newdigate/nosh-dev-board/fab/README.md

# Nosh fabrication outputs

Generated by `python3 Kicad/tools/fab_export.py` on 2026-11-03 from Kicad/Nosh.kicad_pcb (commit b732f8e).

| File | Contents |
|---|---|
| `Nosh-gerbers.zip` | 16 Gerber/drill files: 6 copper layers, paste, silk, mask, edge cuts, one Excellon drill file (PTH + NPTH, slots as routed ovals) and its map |
| `Nosh-bom.csv` | 70 order codes covering 268 fitted parts |
| `Nosh-cpl.csv` | 268 placements, 198 top / 70 bottom; through-hole parts included: J11, J4 |

## JLCPCB order settings

- 6 layers, 1.6 mm, FR4 TG155 (chosen over TG135 for the two lead-free reflow passes and hand rework), 1 oz outer / 0.5 oz inner copper (0.5 oz inner keeps the 0.09 mm inner spacing allowed), any colour.
- Order options worth the free day each: Confirm Production File = Yes, Confirm Parts Placement = Yes (rotation preview); Depanel boards & edge rail = Yes (JLCPCB rails go on the long edges; J5 pads sit 0.3 mm from the north V-score).
- Surface finish: ENIG, 1U" gold (0.025 um, the IPC-4552 minimum and JLCPCB's standard). The gold is sacrificial and dissolves into the joint, so 2U" adds nothing to wetting and only moves the small 0402 / 0.4 mm QFN joints toward Au embrittlement; thicker gold is for wiping contacts, which this board has none of. OSP is also offered on 6 layers but was rejected: two reflow passes (70 bottom-side parts), hand soldering of J4/J11, test points and rework all want a finish that survives handling.
- Stackup: Specify Stackup = Yes, JLC06161H-3313 (3313 prepreg, 0.0994 mm outer dielectric, 0.5 oz inner, finished 1.54 mm +-10%). JLCPCB impedance calculator, 2026-11-03, L1 over L2: the USB pairs (0.13 mm / 0.11 mm gap) come out ~85 R (USB 2.0 wants 90 +-15%) and the MIPI pairs (0.13 / 0.13) ~90 R (D-PHY 80-125 R), so no impedance-control order is needed. The 7628 and 2116 stackups put 0.21-0.22 mm under the outer layers (our pairs would read ~115-120 R) and 1080 only 0.076 mm (~75 R); do not pick those.
- Via covering: "Epoxy Filled & Capped" (the 6-layer default) - the board has via-in-pad under the decoupling capacitors.
- Min track / spacing: the 0.09 / 0.09 mm tier (board minimum 0.13 mm track, 0.09 mm spacing).
- Min via hole size / diameter: choose "0.2 mm / (0.3/0.35 mm)". The board has 323 vias at 0.2 mm drill in a 0.45 mm pad (0.125 mm ring), 809 at 0.3 mm drill in 0.45 mm (0.075 mm ring) and 63 at 0.3 mm in 0.5 mm; the 0.2 mm drills carry JLCPCB's small-via surcharge. Smallest component hole 0.6 mm.
- Assembly: both sides, standard parts; order the stencil for both sides; add BGA X-ray inspection.
- Consigned / pre-ordered parts: U1 MIMXRT1176DVMAA (C1020237, reserved in the parts library) and U9/U10 AS4C32M16SC-7TIN (C1349997, four ordered 2026-11-03 after the -6TIN C1351095 stayed out of stock).
- Through-hole: J4 barrel jack and J11 UART header are the only THT parts; run with `--no-tht` to leave them off the BOM/CPL and hand-solder them.
- Rotation: the CPL carries KiCad rotations. Check every polarised part (SOT-23 family, QFN, WSON, TSSOP, TSOP, SOT-223, SOD/SMA diodes, BGA) in the JLCPCB placement preview before paying.

## Order placed 2026-11-03

JLCPCB order Y95-2611336A, $477.79 incl. $30.57 shipping: 5 PCBs ($132.93) + 2 assembled both sides ($311.91). Dimension 153.9 x 91.8 mm = board + 5 mm rails on the long edges, FR4 TG155, JLC06161H-3313, ENIG 1U", 1 oz / 0.5 oz, epoxy filled & capped, 0.2 mm / (0.3/0.35 mm) vias, black, flying probe + 4-wire Kelvin, mark removed, no impedance control, Confirm Production File = No, build 7-8 + 4-5 days. Ordered without the placement-confirmation and depanel options: snap the rails off by hand (J5 pads are 0.3 mm from the north V-score).
