newdigate/nosh-dev-board/Kicad/handroute/bga_handroute.md

# Open connections to hand-route

Generated by `tools/handroute_list.py` on 2026-10-27 from a KiCad DRC of the board with its zones refilled: **0 open connections** in total, 0 with one end at the U1 ball grid (0 power, 0 signal) and 0 elsewhere on the board.

Numbers 1–0 match the labels in `bga_open.png` (label = the ball end; yellow = signal, cyan = power; the short bar points toward the other end). Every number is also in `board_open.png`, labelled at the middle of its airline.
Balls are 0.8 mm pitch, A1 at (65.6, 35.6), rows A–U top to bottom, columns 1–17 left to right. Coordinates are mm from the board origin (top-left, y down).

- **Fan-out via** is the dog-bone via already on that ball: start there. "none" means the ball has no fan-out yet (the outer two rings escape on F.Cu).
- **Other end** is where KiCad's ratsnest line lands (a pad, or the end of copper already routed on that net) and the pads it is part of.
- Inside the grid only 0.13 mm tracks (the board minimum) fit between the fan-out vias; no tracks on GND1, PWR or GND2.

⚡ = power net (route wider than 0.13 mm once outside the grid where there is room).
