newdigate/nosh-dev-board/Kicad/handroute/bga_open.png

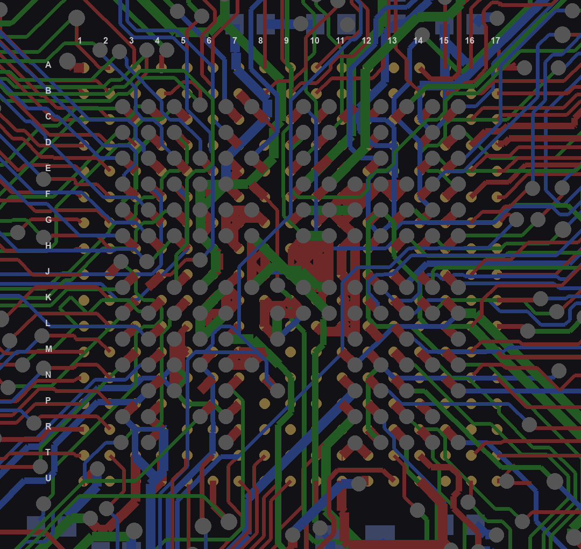
Kicad/handroute/bga_open.png
