newdigate/nosh-dev-board/Kicad/handroute/board_open.png

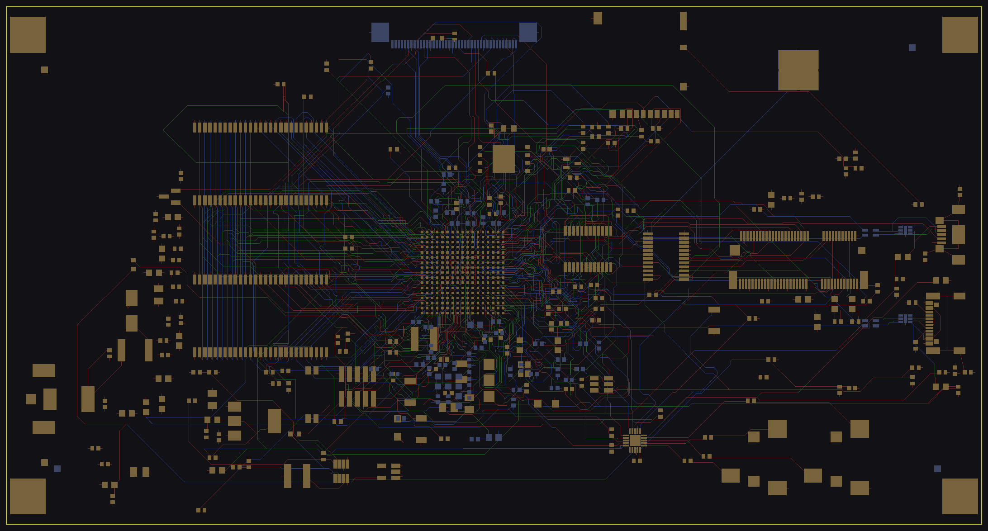
Kicad/handroute/board_open.png
