newdigate/nosh-dev-board/fab/Nosh-bom.csv

Comment | Designator | Footprint | LCSC Part # | MPN
1uF | C1,C11,C117,C132,C133,C141,C142,C19,C20,C47,C48,C49,C50,C51,C52,C58,C78,C8 | C_0402_1005Metric_JLC / C_0402_1005Metric_ViP | C52923 | CL05A105KA5NQNC
2.2uF | C118,C13,C14,C2,C28,C32,C34,C35,C36,C38,C39,C40,C42,C44,C7 | C_0402_1005Metric_JLC / C_0402_1005Metric_ViP | C12530 | CL05A225MQ5NSNC
100nF | C105,C106,C107,C108,C109,C111,C112,C113,C114,C119,C12,C127,C129,C130,C131,C146,C148,C21,C22,C25,C29,C3,C33,C46,C55,C56,C57,C59,C63,C69,C70,C74,C77,C80,C82,C84,C85,C86,C87,C88,C89,C9,C90,C91,C93,C94,C95,C96,C97,C98,C99 | C_0402_1005Metric_JLC / C_0402_1005Metric_ViP | C1525 | CL05B104KO5NNNC
220nF | C116,C4,C45,C71 | C_0402_1005Metric_JLC | C16772 | CL05B224KO5NNNC
4.7uF | C10,C128,C16,C17,C18,C24,C37,C41,C43,C5,C6,C64,C65,C66 | C_0402_1005Metric_JLC / C_0402_1005Metric_ViP | C23733 | CL05A475MP5NRNC
22uF | C15,C23,C26,C30 | C_0603_1608Metric | C59461 | CL10A226MQ8NRNC
10uF | C103,C104,C27,C31,C60,C62,C73,C75,C76,C81,C83 | C_0603_1608Metric | C19702 | CL10A106KP8NNNC
4.7pF | C53,C54 | C_0402_1005Metric_JLC | C325453 | CC0402BRNPO9BN4R7
10pF | C143,C144 | C_0402_1005Metric_JLC | C32949 | CL05C100JB5NNNC
3.3nF | C147 | C_0603_1608Metric | C1613 | CL10B332KB8NNNC
MIPI LCD FPC (RK055HDMIPI4MA0) | J7 | FPC40_0p5_Wuerth_68714014022 | C6264899 | 68714014022
DLW21HN900SQ2L | L3,L4 | L_CommonModeChoke_Murata_DLW21 | C80529 | DLW21HN900SQ2L
30k | R1 | R_0402_1005Metric_JLC | C2909347 | FRC0402F3002TS
100k | R100,R101,R102,R103,R105,R19,R24,R55,R90,R91,R92,R93,R94,R95,R96,R97,R98,R99 | R_0402_1005Metric_JLC | C25741 | 0402WGF1003TCE
47k | R106 | R_0402_1005Metric_JLC | C25792 | 0402WGF4702TCE
560R | R107 | R_0402_1005Metric_JLC | C25126 | 0402WGF5600TCE
RClamp0854P | U4,U5 | slp1616p6 | C842842 | RCLAMP0854P.TCT
TPS259531 | U17 | Texas_DSG0008A_WSON-8-1EP_2x2mm_P0.5mm_EP0.9x1.6mm | C2155674 | TPS259531DSGR
1.5nF | C61,C67 | C_0402_1005Metric_JLC | C107022 | CC0402KRX7R9BB152
22uF | C101,C68,C72 | C_0805_2012Metric | C45783 | CL21A226MAQNNNE
4.7uF | C100,C102,C79,C92 | C_0603_1608Metric | C19666 | CL10A475KO8NNNC
RB521S30 | D1,D5,D9 | D_SOD-523 | C145179 | RB521S30T1G
MBR120VLSFT1G | D3,D4 | D_SOD-123F | C223608 | MBR120VLSFT1G
RED | D10,D11,D6,D7 | LED_0603_1608Metric | C2286 | KT-0603R
SMAJ6.0A | D12 | D_SMA | C223993 | SMAJ6.0A
TPD1E05U06 | D13,D14,D15,D16,D17,D18 | ESD_X1SON-2_0.6x1mm_JLC | C436349 | TPD1E05U06DPYR
TPD1E10B06 | D19,D20,D21,D22 | ESD_X1SON-2_0.6x1mm_JLC | C48260 | TPD1E10B06DPYR
3A | F1 | Fuse_1812_4532Metric | C2892380 | SMD1812P300SLR/24
120R | FB1,FB11,FB2,FB3,FB4,FB5,FB6 | L_0402_1005Metric | C85812 | BLM15AG121SN1D
120R | FB10,FB7 | L_0603_1608Metric | C14709 | BLM18PG121SN1D
300R | FB8 | L_0603_1608Metric | C2649308 | 742792641
M2.5 nut 2mm | H5 | SMTSO_M2.5_Hole4.22mm_Pad6.2mm | C5301776 | SMTSOM2.520BTR
SWD | J1 | PinHeader_2x05_P1.27mm_Vertical_SMD | C150517 | 20021121-00010C4LF
USB2 micro-AB | J2 | USB_Micro-AB_Molex_47590-0001_JLC | C136001 | 47590-0001
USB1 USB-C | J3 | USB_C_Receptacle_GCT_USB4105-xx-A_16P_TopMnt_Horizontal_JLC | C5184243 | USB4105-GF-A-120
DC 5V IN | J4 | BarrelJack_CUI_PJ-063AH_Horizontal_JLC | C22434582 | PJ-063AH
microSD | J5 | microSD_HC_Hirose_DM3AT-SF-PEJM5_JLC | C114218 | DM3AT-SF-PEJM5
M.2 Key E (IW416 / MAYA-W1) | J6 | M2_KeyE_67pin_RA | C2977809 | 2199230-4
LINE IN / LINE OUT | J8,J9 | Jack_3.5mm_CUI_SJ-3524-SMT_Horizontal_JLC | C20182907 | SJ-3524-SMT-TR
DEBUG UART | J11 | PinHeader_1x03_P2.54mm_Vertical | C2937625 | PZ254V-11-03P
4.7uH | L1 | L_APV_ANR4020 | C6364800 | ANR4020T4R7M
1uH 3A | L5 | L_APV_ANR4020 | C91254 | SWPA4020S1R0NT
2SK3018 | Q2 | SOT-323_SC-70 | C113315 | 2SK3018T106
IRLML6401 | Q3,Q4 | SOT-23 | C3034 | IRLML6401TRPBF
4.7k | R11,R12,R2 | R_0402_1005Metric_JLC | C25900 | 0402WGF4701TCE
0R | R41,R42,R56,R7,R8,R81,R82,R83 | R_0402_1005Metric_JLC | C17168 | 0402WGF0000TCE
10k | R10,R108,R109,R13,R14,R18,R28,R43,R44,R46,R49,R53,R54,R57,R59,R66,R73 | R_0402_1005Metric_JLC | C25744 | 0402WGF1002TCE
100R | R16,R27 | R_0402_1005Metric_JLC | C25076 | 0402WGF1000TCE
22k | R23 | R_0402_1005Metric_JLC | C25768 | 0402WGF2202TCE
5.1k | R25,R26 | R_0402_1005Metric_JLC | C25905 | 0402WGF5101TCE
180k | R29 | R_0402_1005Metric_JLC | C25760 | 0402WGF1803TCE
40.2k | R30 | R_0402_1005Metric_JLC | C25893 | 0402WGF4022TCE
0R | R40 | R_0603_1608Metric | C21189 | 0603WAF0000T5E
27R | R47,R50 | R_0402_1005Metric_JLC | C25100 | 0402WGF270JTCE
1k | R104,R51,R52,R58,R60,R89 | R_0402_1005Metric_JLC | C11702 | 0402WGF1001TCE
2.2k | R74,R75 | R_0402_1005Metric_JLC | C25879 | 0402WGF2201TCE
ONOFF / RESET / WAKEUP | SW1,SW2,SW3 | SW_SPST_B3U-1000P | C231329 | B3U-1000P
BOOT_MODE | SW4 | SW_DIP_SPSTx02_Slide_KingTek_DSHP02TS_W7.62mm_P1.27mm | C3293142 | DSHP02TSGER
MIMXRT1176DVMAA | U1 | MAPBGA-289_14x14mm_Layout17x17_P0.8mm | C1020237 | MIMXRT1176DVMAA
W25Q512JVEIQ | U2 | WSON-8-1EP_8x6mm_P1.27mm_EP3.4x4.3mm | C7389628 | W25Q512JVEIQ
TPS2553DBVR | U3 | SOT-23-6 | C55266 | TPS2553DBVR
MP2143DJ | U6 | TSOT-23-8 | C43427 | MP2143DJ-LF-Z
AP2112K-3.3 | U7 | SOT-23-5 | C51118 | AP2112K-3.3TRG1
TLV1117LV-18 | U8 | SOT-223-3_TabPin2 | C80105 | TLV1117LV18DCYR
AS4C32M16SC-7TIN | U10,U9 | TSOP-II-54_22.2x10.16mm_P0.8mm | C1349997 | AS4C32M16SC-7TIN
74AVC8T245PW | U11,U12 | TSSOP-24_4.4x7.8mm_P0.65mm | C465742 | SN74AVC8T245PWR
SGTL5000XNLA3R2 | U15 | QFN-20-1EP_3x3mm_P0.4mm_EP1.65x1.65mm | C2651833 | SGTL5000XNLA3R2
TLV803S | U16 | SOT-23 | C132016 | TLV803SDBZR
24MHz | Y1 | Crystal_SMD_2016-4Pin_2.0x1.6mm | C5250251 | XRCGB24M000F2P91R0
32.768kHz | Y2 | Crystal_SMD_3215-2Pin_3.2x1.5mm_JLC | C48615 | Q13FC13500002
