newdigate/nosh-dev-board/Kicad/Nosh.kicad_pcb

## KiCad design Kicad/Nosh.kicad_pcb (2026-11-03)

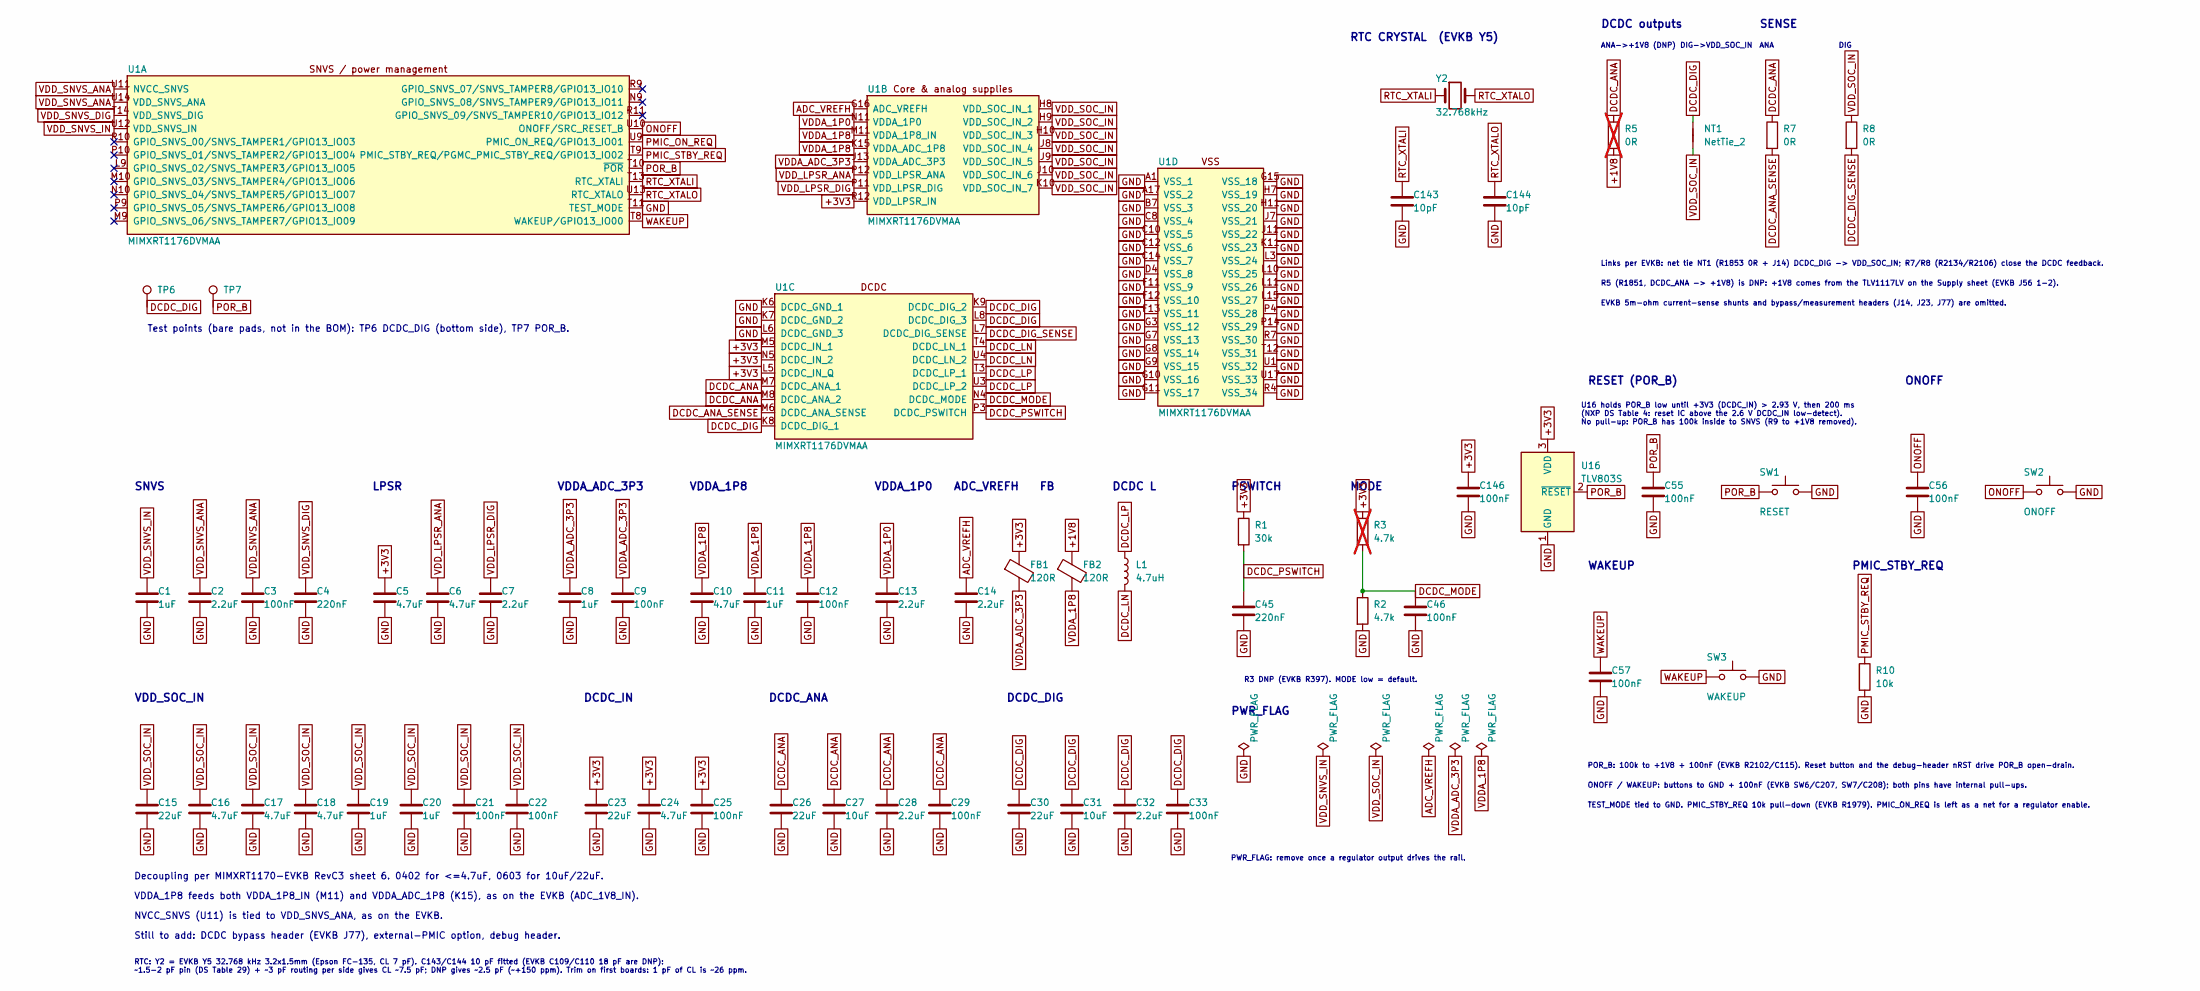
[picture p5: schematic power.kicad_sch]

Parts:
C1, C8: 1uF; C_0402_1005Metric_JLC; MPN CL05A105KA5NQNC; LCSC C52923
C2, C13, C14: 2.2uF; C_0402_1005Metric_JLC; MPN CL05A225MQ5NSNC; LCSC C12530
C3, C12, C21, C25, C33: 100nF; C_0402_1005Metric_ViP; MPN CL05B104KO5NNNC; LCSC C1525
C4, C45: 220nF; C_0402_1005Metric_JLC; MPN CL05B224KO5NNNC; LCSC C16772
C5, C16, C17, C24: 4.7uF; C_0402_1005Metric_ViP; MPN CL05A475MP5NRNC; LCSC C23733
C6, C10, C18: 4.7uF; C_0402_1005Metric_JLC; MPN CL05A475MP5NRNC; LCSC C23733
C7, C28, C32: 2.2uF; C_0402_1005Metric_ViP; MPN CL05A225MQ5NSNC; LCSC C12530
C9, C22, C29, C46, C55, C56, C57, C146: 100nF; C_0402_1005Metric_JLC; MPN CL05B104KO5NNNC; LCSC C1525
C11, C19, C20: 1uF; C_0402_1005Metric_ViP; MPN CL05A105KA5NQNC; LCSC C52923
C15, C23, C26, C30: 22uF; C_0603_1608Metric; MPN CL10A226MQ8NRNC; LCSC C59461
C27, C31: 10uF; C_0603_1608Metric; MPN CL10A106KP8NNNC; LCSC C19702
C143, C144: 10pF; C_0402_1005Metric_JLC; MPN CL05C100JB5NNNC; LCSC C32949
FB1, FB2: 120R; L_0402_1005Metric; MPN BLM15AG121SN1D; LCSC C85812
L1: 4.7uH; L_APV_ANR4020; MPN ANR4020T4R7M; LCSC C6364800
NT1: NetTie_2; NetTie-2_SMD_0805
R1: 30k; R_0402_1005Metric_JLC; MPN FRC0402F3002TS; LCSC C2909347
R2: 4.7k; R_0402_1005Metric_JLC; MPN 0402WGF4701TCE; LCSC C25900
R3: 4.7k; R_0402_1005Metric_JLC; MPN 0402WGF4701TCE; LCSC C25900; not fitted
R5: 0R; R_0805_2012Metric; MPN 0805W8F0000T5E; LCSC C17477; not fitted
R7, R8: 0R; R_0402_1005Metric_JLC; MPN 0402WGF0000TCE; LCSC C17168
R10: 10k; R_0402_1005Metric_JLC; MPN 0402WGF1002TCE; LCSC C25744
SW1: RESET; SW_SPST_B3U-1000P; MPN B3U-1000P; LCSC C231329
SW2: ONOFF; SW_SPST_B3U-1000P; MPN B3U-1000P; LCSC C231329
SW3: WAKEUP; SW_SPST_B3U-1000P; MPN B3U-1000P; LCSC C231329
TP6, TP7: TestPoint; TestPoint_Pad_D1.0mm_JLC
U1: MIMXRT1176DVMAA; MAPBGA-289_14x14mm_Layout17x17_P0.8mm; MPN MIMXRT1176DVMAA; LCSC C1020237
U16: TLV803S; SOT-23; MPN TLV803SDBZR; LCSC C132016
Y2: 32.768kHz; Crystal_SMD_3215-2Pin_3.2x1.5mm_JLC; MPN Q13FC13500002; LCSC C48615

Connections:
+1V8: FB2.1, R5.2; also elsewhere on the board
+3V3: C5.1, C23.1, C24.1, C25.1, C146.1, FB1.1, R1.1, R3.1, U1.L5 (DCDC_IN_Q), U1.M5 (DCDC_IN_1), U1.N5 (DCDC_IN_2), U1.R12 (VDD_LPSR_IN), U16.3 (VDD); also elsewhere on the board
ADC_VREFH: C14.1, U1.G16 (ADC_VREFH); also elsewhere on the board
DCDC_ANA: C26.1, C27.1, C28.1, C29.1, R5.1, R7.1, U1.M7 (DCDC_ANA_1), U1.M8 (DCDC_ANA_2)
DCDC_ANA_SENSE: R7.2, U1.M6 (DCDC_ANA_SENSE)
DCDC_DIG: C30.1, C31.1, C32.1, C33.1, NT1.1, TP6.1, U1.K8 (DCDC_DIG_1), U1.K9 (DCDC_DIG_2), U1.L8 (DCDC_DIG_3)
DCDC_DIG_SENSE: R8.2, U1.L7 (DCDC_DIG_SENSE)
DCDC_LN: L1.2, U1.T4 (DCDC_LN_1), U1.U4 (DCDC_LN_2)
DCDC_LP: L1.1, U1.T3 (DCDC_LP_1), U1.U3 (DCDC_LP_2)
DCDC_MODE: C46.1, R2.1, R3.2, U1.N4 (DCDC_MODE)
DCDC_PSWITCH: C45.1, R1.2, U1.P3 (DCDC_PSWITCH)
GND: C1.2, C2.2, C3.2, C4.2, C5.2, C6.2, C7.2, C8.2, C9.2, C10.2, C11.2, C12.2, C13.2, C14.2, C15.2, C16.2, C17.2, C18.2, C19.2, C20.2, C21.2, C22.2, C23.2, C24.2, C25.2, C26.2, C27.2, C28.2, C29.2, C30.2, C31.2, C32.2, C33.2, C45.2, C46.2, C55.2, C56.2, C57.2, C143.2, C144.2, C146.2, R2.2, R10.2, SW1.2, SW2.2, SW3.2, U1.A1 (VSS_1), U1.A17 (VSS_2), U1.B7 (VSS_3), U1.C8 (VSS_4), U1.C10 (VSS_5), U1.C12 (VSS_6), U1.C14 (VSS_7), U1.D4 (VSS_8), U1.F11 (VSS_9), U1.F12 (VSS_10), U1.F13 (VSS_11), U1.G3 (VSS_12), U1.G7 (VSS_13), U1.G8 (VSS_14), U1.G9 (VSS_15), U1.G10 (VSS_16), U1.G11 (VSS_17), U1.G15 (VSS_18), U1.H7 (VSS_19), U1.H11 (VSS_20), U1.J7 (VSS_21), U1.J11 (VSS_22), U1.K6 (DCDC_GND_1), U1.K7 (DCDC_GND_2), U1.K11 (VSS_23), U1.L3 (VSS_24), U1.L6 (DCDC_GND_3), U1.L10 (VSS_25), U1.L11 (VSS_26), U1.L15 (VSS_27), U1.P4 (VSS_28), U1.P14 (VSS_29), U1.R4 (VSS_34), U1.R7 (VSS_30), U1.T11 (TEST_MODE), U1.T12 (VSS_31), U1.U1 (VSS_32), U1.U17 (VSS_33), U16.1 (GND); also elsewhere on the board
ONOFF: C56.1, SW2.1, U1.U10 (ONOFF/SRC_RESET_B)
PMIC_ON_REQ: U1.U9 (PMIC_ON_REQ/GPIO13_IO01); also elsewhere on the board
PMIC_STBY_REQ: R10.1, U1.T9 (PMIC_STBY_REQ/PGMC_PMIC_STBY_REQ/GPIO13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)
POR_B: C55.1, SW1.1, TP7.1, U1.T10 (~POR), U16.2 (~RESET); also elsewhere on the board
RTC_XTALI: C143.1, U1.T13 (RTC_XTALI), Y2.1
RTC_XTALO: C144.1, U1.U13 (RTC_XTALO), Y2.2
VDDA_1P0: C13.1, U1.N11 (VDDA_1P0); also elsewhere on the board
VDDA_1P8: C10.1, C11.1, C12.1, FB2.2, U1.K15 (VDDA_ADC_1P8), U1.M11 (VDDA_1P8_IN)
VDDA_ADC_3P3: C8.1, C9.1, FB1.2, U1.J13 (VDDA_ADC_3P3)
VDD_LPSR_ANA: C6.1, U1.P12 (VDD_LPSR_ANA)
VDD_LPSR_DIG: C7.1, U1.P11 (VDD_LPSR_DIG)
VDD_SNVS_ANA: C2.1, C3.1, U1.U11 (NVCC_SNVS), U1.U14 (VDD_SNVS_ANA)
VDD_SNVS_DIG: C4.1, U1.T14 (VDD_SNVS_DIG)
VDD_SNVS_IN: C1.1, U1.U12 (VDD_SNVS_IN); also elsewhere on the board
VDD_SOC_IN: C15.1, C16.1, C17.1, C18.1, C19.1, C20.1, C21.1, C22.1, NT1.2, R8.1, U1.H8 (VDD_SOC_IN_1), U1.H9 (VDD_SOC_IN_2), U1.H10 (VDD_SOC_IN_3), U1.J8 (VDD_SOC_IN_4), U1.J9 (VDD_SOC_IN_5), U1.J10 (VDD_SOC_IN_6), U1.K10 (VDD_SOC_IN_7)
WAKEUP: C57.1, SW3.1, U1.T8 (WAKEUP/GPIO13_IO00)

Notes on the sheet:
DIG
SNVS
R5 (R1851, DCDC_ANA -> +1V8) is DNP: +1V8 comes from the TLV1117LV on the Supply sheet (EVKB J56 1-2).
ANA->+1V8 (DNP)
WAKEUP
RTC: Y2 = EVKB Y5 32.768 kHz 3.2x1.5mm (Epson FC-135, CL 7 pF). C143/C144 10 pF fitted (EVKB C109/C110 18 pF are DNP): ~1.5-2 pF pin (DS Table 29) + ~3 pF routing per side gives CL ~7.5 pF; DNP gives ~2.5 pF (~+150 ppm). Trim on first boards: 1 pF of CL is ~26 ppm.
U16 holds POR_B low until +3V3 (DCDC_IN) > 2.93 V, then 200 ms (NXP DS Table 4: reset IC above the 2.6 V DCDC_IN low-detect). No pull-up: POR_B has 100k inside to SNVS (R9 to +1V8 removed).
PWR_FLAG: remove once a regulator output drives the rail.
DCDC L
VDDA_1P8 feeds both VDDA_1P8_IN (M11) and VDDA_ADC_1P8 (K15), as on the EVKB (ADC_1V8_IN).
VDDA_1P0
TEST_MODE tied to GND. PMIC_STBY_REQ 10k pull-down (EVKB R1979). PMIC_ON_REQ is left as a net for a regulator enable.
PMIC_STBY_REQ
R3 DNP (EVKB R397). MODE low = default.
ADC_VREFH
SENSE
Still to add: DCDC bypass header (EVKB J77), external-PMIC option, debug header.
DCDC outputs
DCDC_DIG
VDDA_ADC_3P3
PSWITCH
VDDA_1P8
DCDC_IN
LPSR
ANA
RTC CRYSTAL (EVKB Y5)
MODE
RESET (POR_B)
EVKB 5m-ohm current-sense shunts and bypass/measurement headers (J14, J23, J77) are omitted.
PWR_FLAG
POR_B: 100k to +1V8 + 100nF (EVKB R2102/C115). Reset button and the debug-header nRST drive POR_B open-drain.
NVCC_SNVS (U11) is tied to VDD_SNVS_ANA, as on the EVKB.
Links per EVKB: net tie NT1 (R1853 0R + J14) DCDC_DIG -> VDD_SOC_IN; R7/R8 (R2134/R2106) close the DCDC feedback.
VDD_SOC_IN
DCDC_ANA
ONOFF / WAKEUP: buttons to GND + 100nF (EVKB SW6/C207, SW7/C208); both pins have internal pull-ups.
ONOFF
Decoupling per MIMXRT1170-EVKB RevC3 sheet 6. 0402 for <=4.7uF, 0603 for 10uF/22uF.
DIG->VDD_SOC_IN
Test points (bare pads, not in the BOM): TP6 DCDC_DIG (bottom side), TP7 POR_B.

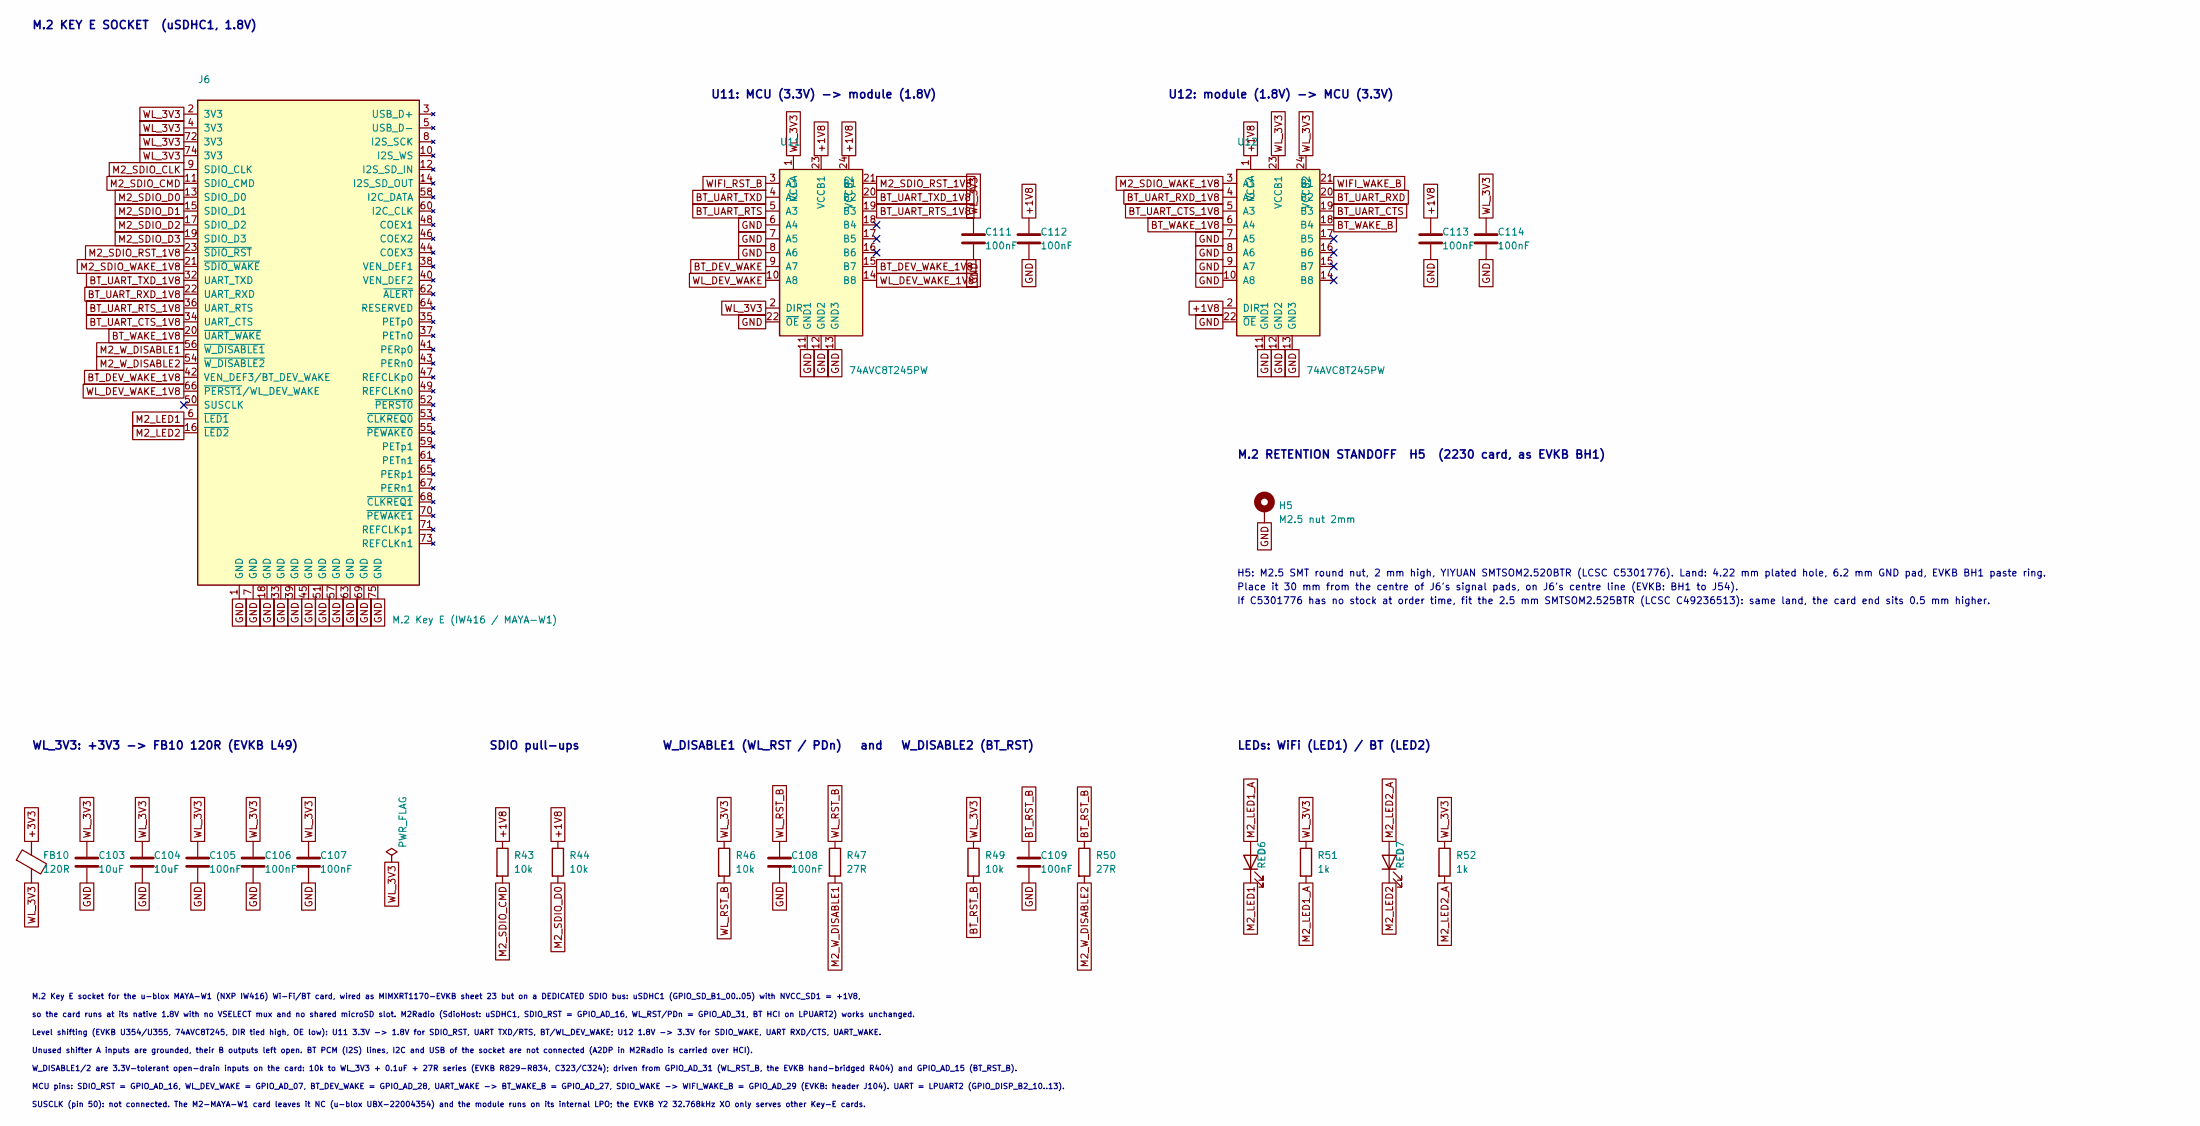
[picture p6: schematic m2.kicad_sch]

Parts:
C103, C104: 10uF; C_0603_1608Metric; MPN CL10A106KP8NNNC; LCSC C19702
C105, C106, C107, C108, C109, C111, C112, C113, C114: 100nF; C_0402_1005Metric_JLC; MPN CL05B104KO5NNNC; LCSC C1525
D6, D7: RED; LED_0603_1608Metric; MPN KT-0603R; LCSC C2286
FB10: 120R; L_0603_1608Metric; MPN BLM18PG121SN1D; LCSC C14709
H5: M2.5 nut 2mm; SMTSO_M2.5_Hole4.22mm_Pad6.2mm; MPN SMTSOM2.520BTR; LCSC C5301776
J6: M.2 Key E (IW416 / MAYA-W1); M2_KeyE_67pin_RA; MPN 2199230-4; LCSC C2977809
R43, R44, R46, R49: 10k; R_0402_1005Metric_JLC; MPN 0402WGF1002TCE; LCSC C25744
R47, R50: 27R; R_0402_1005Metric_JLC; MPN 0402WGF270JTCE; LCSC C25100
R51, R52: 1k; R_0402_1005Metric_JLC; MPN 0402WGF1001TCE; LCSC C11702
U11, U12: 74AVC8T245PW; TSSOP-24_4.4x7.8mm_P0.65mm; MPN SN74AVC8T245PWR; LCSC C465742

Connections:
+1V8: C112.1, C113.1, R43.1, R44.1, U11.23 (VCCB1), U11.24 (VCCB2), U12.1 (VCCA), U12.2 (DIR); also elsewhere on the board
+3V3: FB10.1; also elsewhere on the board
BT_DEV_WAKE: U11.9 (A7); also elsewhere on the board
BT_DEV_WAKE_1V8: J6.42 (VEN_DEF3/BT_DEV_WAKE), U11.15 (B7)
BT_RST_B: C109.1, R49.2, R50.1; also elsewhere on the board
BT_UART_CTS: U12.19 (B3); also elsewhere on the board
BT_UART_CTS_1V8: J6.34 (UART_CTS), U12.5 (A3)
BT_UART_RTS: U11.5 (A3); also elsewhere on the board
BT_UART_RTS_1V8: J6.36 (UART_RTS), U11.19 (B3)
BT_UART_RXD: U12.20 (B2); also elsewhere on the board
BT_UART_RXD_1V8: J6.22 (UART_RXD), U12.4 (A2)
BT_UART_TXD: U11.4 (A2); also elsewhere on the board
BT_UART_TXD_1V8: J6.32 (UART_TXD), U11.20 (B2)
BT_WAKE_1V8: J6.20 (~UART_WAKE), U12.6 (A4)
BT_WAKE_B: U12.18 (B4); also elsewhere on the board
GND: C103.2, C104.2, C105.2, C106.2, C107.2, C108.2, C109.2, C111.2, C112.2, C113.2, C114.2, H5.1, J6.1 (GND), J6.7 (GND), J6.18 (GND), J6.33 (GND), J6.39 (GND), J6.45 (GND), J6.51 (GND), J6.57 (GND), J6.63 (GND), J6.69 (GND), J6.75 (GND), U11.6 (A4), U11.7 (A5), U11.8 (A6), U11.11 (GND1), U11.12 (GND2), U11.13 (GND3), U11.22 (~OE), U12.7 (A5), U12.8 (A6), U12.9 (A7), U12.10 (A8), U12.11 (GND1), U12.12 (GND2), U12.13 (GND3), U12.22 (~OE); also elsewhere on the board
M2_LED1: D6.1 (K), J6.6 (~LED1)
M2_LED1_A: D6.2 (A), R51.2
M2_LED2: D7.1 (K), J6.16 (~LED2)
M2_LED2_A: D7.2 (A), R52.2
M2_SDIO_CLK: J6.9 (SDIO_CLK); also elsewhere on the board
M2_SDIO_CMD: J6.11 (SDIO_CMD), R43.2; also elsewhere on the board
M2_SDIO_D0: J6.13 (SDIO_D0), R44.2; also elsewhere on the board
M2_SDIO_D1: J6.15 (SDIO_D1); also elsewhere on the board
M2_SDIO_D2: J6.17 (SDIO_D2); also elsewhere on the board
M2_SDIO_D3: J6.19 (SDIO_D3); also elsewhere on the board
M2_SDIO_RST_1V8: J6.23 (~SDIO_RST), U11.21 (B1)
M2_SDIO_WAKE_1V8: J6.21 (~SDIO_WAKE), U12.3 (A1)
M2_W_DISABLE1: J6.56 (~W_DISABLE1), R47.2
M2_W_DISABLE2: J6.54 (~W_DISABLE2), R50.2
WIFI_RST_B: U11.3 (A1); also elsewhere on the board
WIFI_WAKE_B: U12.21 (B1); also elsewhere on the board
WL_3V3: C103.1, C104.1, C105.1, C106.1, C107.1, C111.1, C114.1, FB10.2, J6.2 (3V3), J6.4 (3V3), J6.72 (3V3), J6.74 (3V3), R46.1, R49.1, R51.1, R52.1, U11.1 (VCCA), U11.2 (DIR), U12.23 (VCCB1), U12.24 (VCCB2)
WL_DEV_WAKE: U11.10 (A8); also elsewhere on the board
WL_DEV_WAKE_1V8: J6.66 (~PERST1/WL_DEV_WAKE), U11.14 (B8)
WL_RST_B: C108.1, R46.2, R47.1; also elsewhere on the board

Notes on the sheet:
LEDs: WiFi (LED1) / BT (LED2)
Unused shifter A inputs are grounded, their B outputs left open. BT PCM (I2S) lines, I2C and USB of the socket are not connected (A2DP in M2Radio is carried over HCI).
WL_3V3: +3V3 -> FB10 120R (EVKB L49)
If C5301776 has no stock at order time, fit the 2.5 mm SMTSOM2.525BTR (LCSC C49236513): same land, the card end sits 0.5 mm higher.
Place it 30 mm from the centre of J6's signal pads, on J6's centre line (EVKB: BH1 to J54).
so the card runs at its native 1.8V with no VSELECT mux and no shared microSD slot. M2Radio (SdioHost: uSDHC1, SDIO_RST = GPIO_AD_16, WL_RST/PDn = GPIO_AD_31, BT HCI on LPUART2) works unchanged.
W_DISABLE1/2 are 3.3V-tolerant open-drain inputs on the card: 10k to WL_3V3 + 0.1uF + 27R series (EVKB R829-R834, C323/C324); driven from GPIO_AD_31 (WL_RST_B, the EVKB hand-bridged R404) and GPIO_AD_15 (BT_RST_B).
M.2 RETENTION STANDOFF H5 (2230 card, as EVKB BH1)
U12: module (1.8V) -> MCU (3.3V)
Level shifting (EVKB U354/U355, 74AVC8T245, DIR tied high, OE low): U11 3.3V -> 1.8V for SDIO_RST, UART TXD/RTS, BT/WL_DEV_WAKE; U12 1.8V -> 3.3V for SDIO_WAKE, UART RXD/CTS, UART_WAKE.
SUSCLK (pin 50): not connected. The M2-MAYA-W1 card leaves it NC (u-blox UBX-22004354) and the module runs on its internal LPO; the EVKB Y2 32.768kHz XO only serves other Key-E cards.
M.2 Key E socket for the u-blox MAYA-W1 (NXP IW416) Wi-Fi/BT card, wired as MIMXRT1170-EVKB sheet 23 but on a DEDICATED SDIO bus: uSDHC1 (GPIO_SD_B1_00..05) with NVCC_SD1 = +1V8,
U11: MCU (3.3V) -> module (1.8V)
M.2 KEY E SOCKET (uSDHC1, 1.8V)
H5: M2.5 SMT round nut, 2 mm high, YIYUAN SMTSOM2.520BTR (LCSC C5301776). Land: 4.22 mm plated hole, 6.2 mm GND pad, EVKB BH1 paste ring.
MCU pins: SDIO_RST = GPIO_AD_16, WL_DEV_WAKE = GPIO_AD_07, BT_DEV_WAKE = GPIO_AD_28, UART_WAKE -> BT_WAKE_B = GPIO_AD_27, SDIO_WAKE -> WIFI_WAKE_B = GPIO_AD_29 (EVKB: header J104). UART = LPUART2 (GPIO_DISP_B2_10..13).
SDIO pull-ups
W_DISABLE1 (WL_RST / PDn) and W_DISABLE2 (BT_RST)

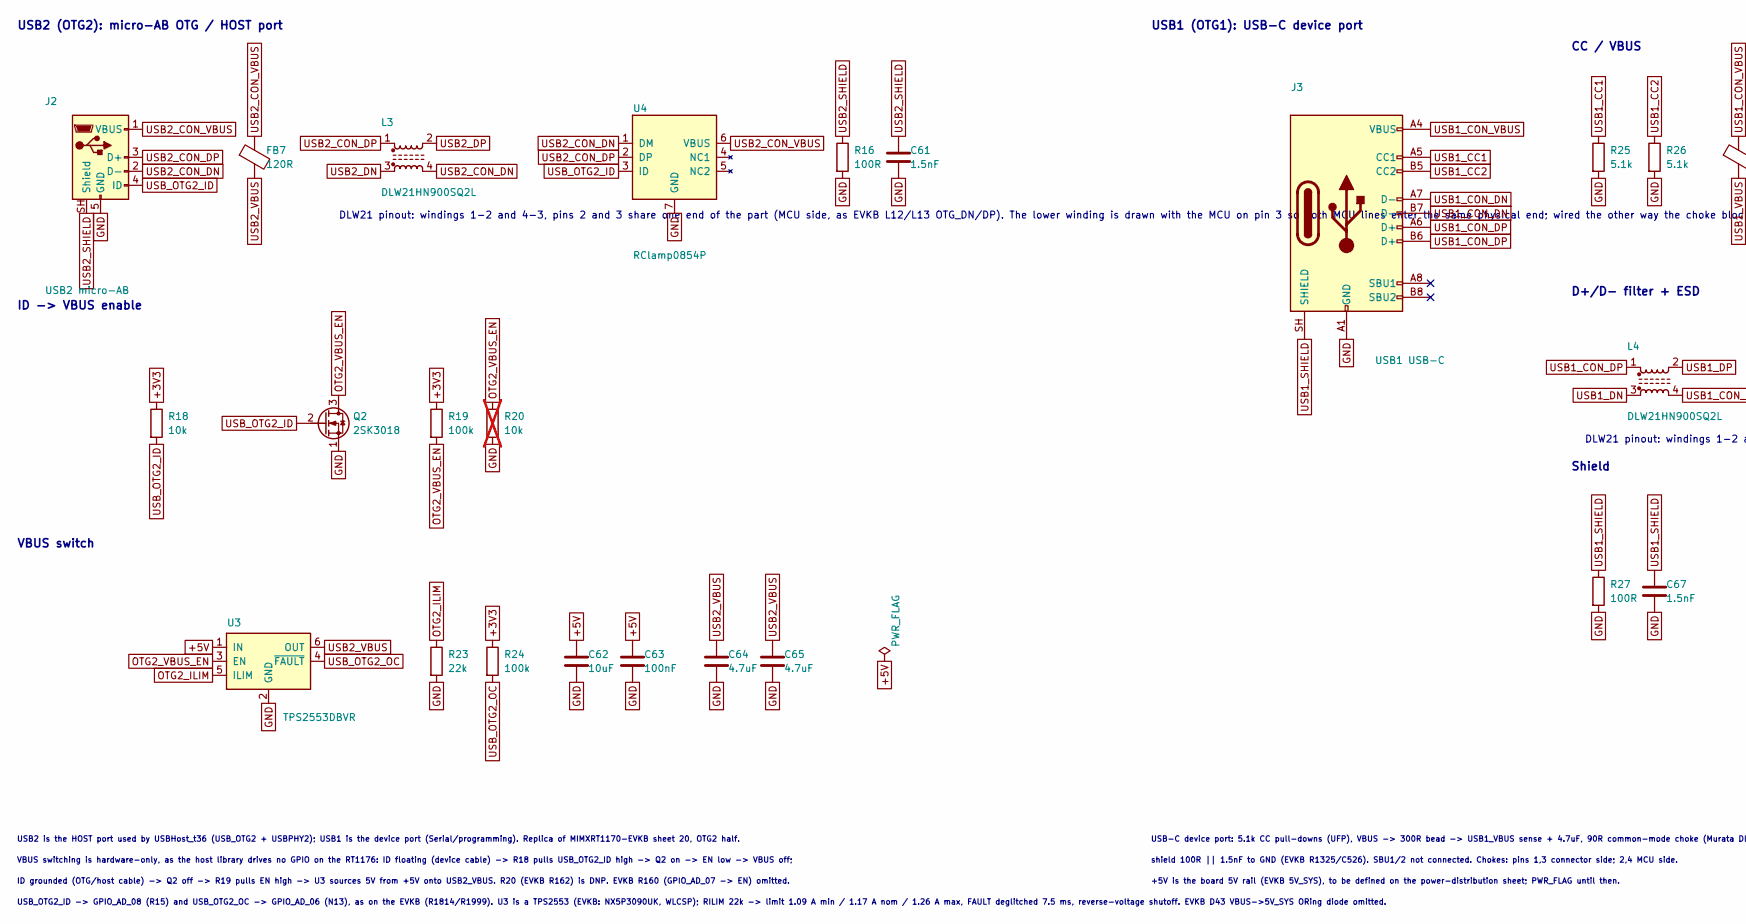
[picture p7: schematic usb.kicad_sch, part in row 1, column 1]

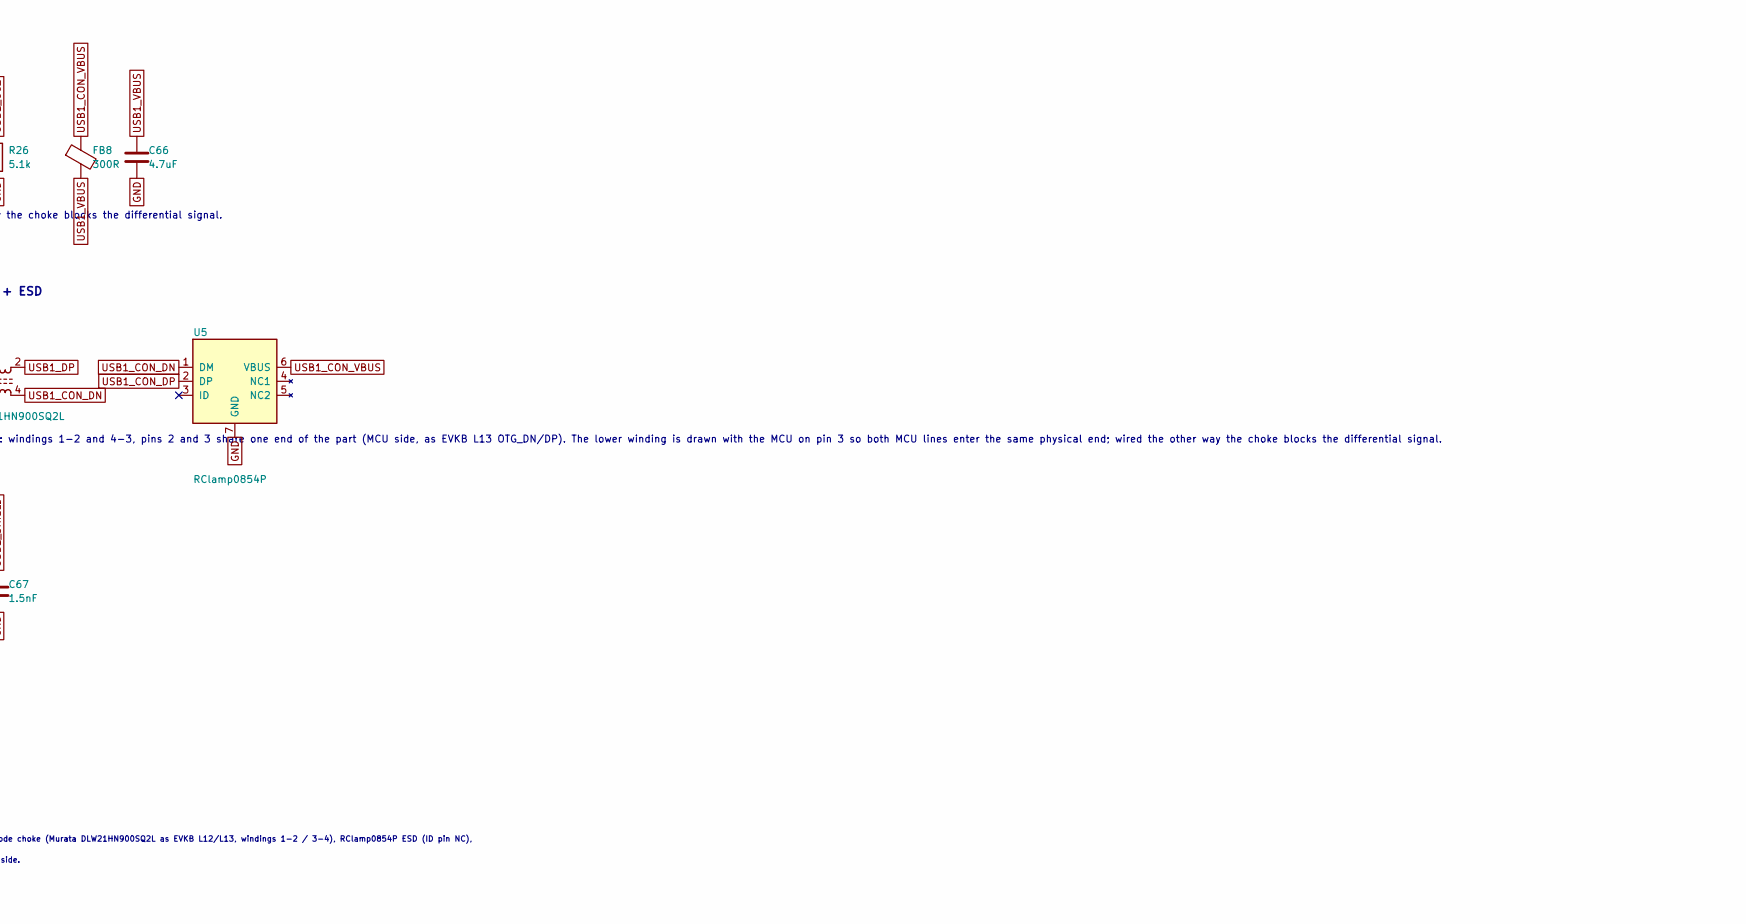
[picture p8: schematic usb.kicad_sch, part in row 1, column 2]

Parts:
C61, C67: 1.5nF; C_0402_1005Metric_JLC; MPN CC0402KRX7R9BB152; LCSC C107022
C62: 10uF; C_0603_1608Metric; MPN CL10A106KP8NNNC; LCSC C19702
C63: 100nF; C_0402_1005Metric_JLC; MPN CL05B104KO5NNNC; LCSC C1525
C64, C65, C66: 4.7uF; C_0402_1005Metric_JLC; MPN CL05A475MP5NRNC; LCSC C23733
FB7: 120R; L_0603_1608Metric; MPN BLM18PG121SN1D; LCSC C14709
FB8: 300R; L_0603_1608Metric; MPN 742792641; LCSC C2649308
J2: USB2 micro-AB; USB_Micro-AB_Molex_47590-0001_JLC; MPN 47590-0001; LCSC C136001
J3: USB1 USB-C; USB_C_Receptacle_GCT_USB4105-xx-A_16P_TopMnt_Horizontal_JLC; MPN USB4105-GF-A-120; LCSC C5184243
L3, L4: DLW21HN900SQ2L; L_CommonModeChoke_Murata_DLW21; MPN DLW21HN900SQ2L; LCSC C80529
Q2: 2SK3018; SOT-323_SC-70; MPN 2SK3018T106; LCSC C113315
R16, R27: 100R; R_0402_1005Metric_JLC; MPN 0402WGF1000TCE; LCSC C25076
R18: 10k; R_0402_1005Metric_JLC; MPN 0402WGF1002TCE; LCSC C25744
R19, R24: 100k; R_0402_1005Metric_JLC; MPN 0402WGF1003TCE; LCSC C25741
R20: 10k; R_0402_1005Metric_JLC; MPN 0402WGF1002TCE; LCSC C25744; not fitted
R23: 22k; R_0402_1005Metric_JLC; MPN 0402WGF2202TCE; LCSC C25768
R25, R26: 5.1k; R_0402_1005Metric_JLC; MPN 0402WGF5101TCE; LCSC C25905
U3: TPS2553DBVR; SOT-23-6; MPN TPS2553DBVR; LCSC C55266
U4, U5: RClamp0854P; slp1616p6; MPN RCLAMP0854P.TCT; LCSC C842842

Connections:
+3V3: R18.1, R19.1, R24.1; also elsewhere on the board
+5V: C62.1, C63.1, U3.1 (IN); also elsewhere on the board
GND: C61.2, C62.2, C63.2, C64.2, C65.2, C66.2, C67.2, J2.5 (GND), J3.A1 (GND), J3.A12 (GND), J3.B1 (GND), J3.B12 (GND), Q2.1 (S), R16.2, R20.2, R23.2, R25.2, R26.2, R27.2, U3.2 (GND), U4.7 (GND), U5.7 (GND); also elsewhere on the board
OTG2_ILIM: R23.1, U3.5 (ILIM)
OTG2_VBUS_EN: Q2.3 (D), R19.2, R20.1, U3.3 (EN)
USB1_CC1: J3.A5 (CC1), R25.1
USB1_CC2: J3.B5 (CC2), R26.1
USB1_CON_DN: J3.A7 (D-), J3.B7 (D-), L4.4, U5.1 (DM)
USB1_CON_DP: J3.A6 (D+), J3.B6 (D+), L4.1, U5.2 (DP)
USB1_CON_VBUS: FB8.1, J3.A4 (VBUS), J3.A9 (VBUS), J3.B4 (VBUS), J3.B9 (VBUS), U5.6 (VBUS)
USB1_DN: L4.3; also elsewhere on the board
USB1_DP: L4.2; also elsewhere on the board
USB1_SHIELD: C67.1, J3.SH (SHIELD), R27.1
USB1_VBUS: C66.1, FB8.2; also elsewhere on the board
USB2_CON_DN: J2.2 (D-), L3.4, U4.1 (DM)
USB2_CON_DP: J2.3 (D+), L3.1, U4.2 (DP)
USB2_CON_VBUS: FB7.1, J2.1 (VBUS), U4.6 (VBUS)
USB2_DN: L3.3; also elsewhere on the board
USB2_DP: L3.2; also elsewhere on the board
USB2_SHIELD: C61.1, J2.SH (Shield), R16.1
USB2_VBUS: C64.1, C65.1, FB7.2, U3.6 (OUT); also elsewhere on the board
USB_OTG2_ID: J2.4 (ID), Q2.2 (G), R18.2, U4.3 (ID); also elsewhere on the board
USB_OTG2_OC: R24.2, U3.4 (~FAULT); also elsewhere on the board

Notes on the sheet:
ID grounded (OTG/host cable) -> Q2 off -> R19 pulls EN high -> U3 sources 5V from +5V onto USB2_VBUS. R20 (EVKB R162) is DNP. EVKB R160 (GPIO_AD_07 -> EN) omitted.
shield 100R || 1.5nF to GND (EVKB R1325/C526). SBU1/2 not connected. Chokes: pins 1,3 connector side; 2,4 MCU side.
USB1 (OTG1): USB-C device port
DLW21 pinout: windings 1-2 and 4-3, pins 2 and 3 share one end of the part (MCU side, as EVKB L13 OTG_DN/DP). The lower winding is drawn with the MCU on pin 3 so both MCU lines enter the same physical end; wired the other way the choke blocks the differential signal.
Shield
D+/D- filter + ESD
VBUS switch
+5V is the board 5V rail (EVKB 5V_SYS), to be defined on the power-distribution sheet; PWR_FLAG until then.
USB-C device port: 5.1k CC pull-downs (UFP), VBUS -> 300R bead -> USB1_VBUS sense + 4.7uF, 90R common-mode choke (Murata DLW21HN900SQ2L as EVKB L12/L13, windings 1-2 / 3-4), RClamp0854P ESD (ID pin NC),
CC / VBUS
USB_OTG2_ID -> GPIO_AD_08 (R15) and USB_OTG2_OC -> GPIO_AD_06 (N13), as on the EVKB (R1814/R1999). U3 is a TPS2553 (EVKB: NX5P3090UK, WLCSP); RILIM 22k -> limit 1.09 A min / 1.17 A nom / 1.26 A max, FAULT deglitched 7.5 ms, reverse-voltage shutoff. EVKB D43 VBUS->5V_SYS ORing diode omitted.
USB2 is the HOST port used by USBHost_t36 (USB_OTG2 + USBPHY2); USB1 is the device port (Serial/programming). Replica of MIMXRT1170-EVKB sheet 20, OTG2 half.
ID -> VBUS enable
VBUS switching is hardware-only, as the host library drives no GPIO on the RT1176: ID floating (device cable) -> R18 pulls USB_OTG2_ID high -> Q2 on -> EN low -> VBUS off;
DLW21 pinout: windings 1-2 and 4-3, pins 2 and 3 share one end of the part (MCU side, as EVKB L12/L13 OTG_DN/DP). The lower winding is drawn with the MCU on pin 3 so both MCU lines enter the same physical end; wired the other way the choke blocks the differential signal.
USB2 (OTG2): micro-AB OTG / HOST port
