newdigate/nosh-dev-board/Kicad/Nosh.kicad_pcb

## KiCad design Kicad/Nosh.kicad_pcb (continued)

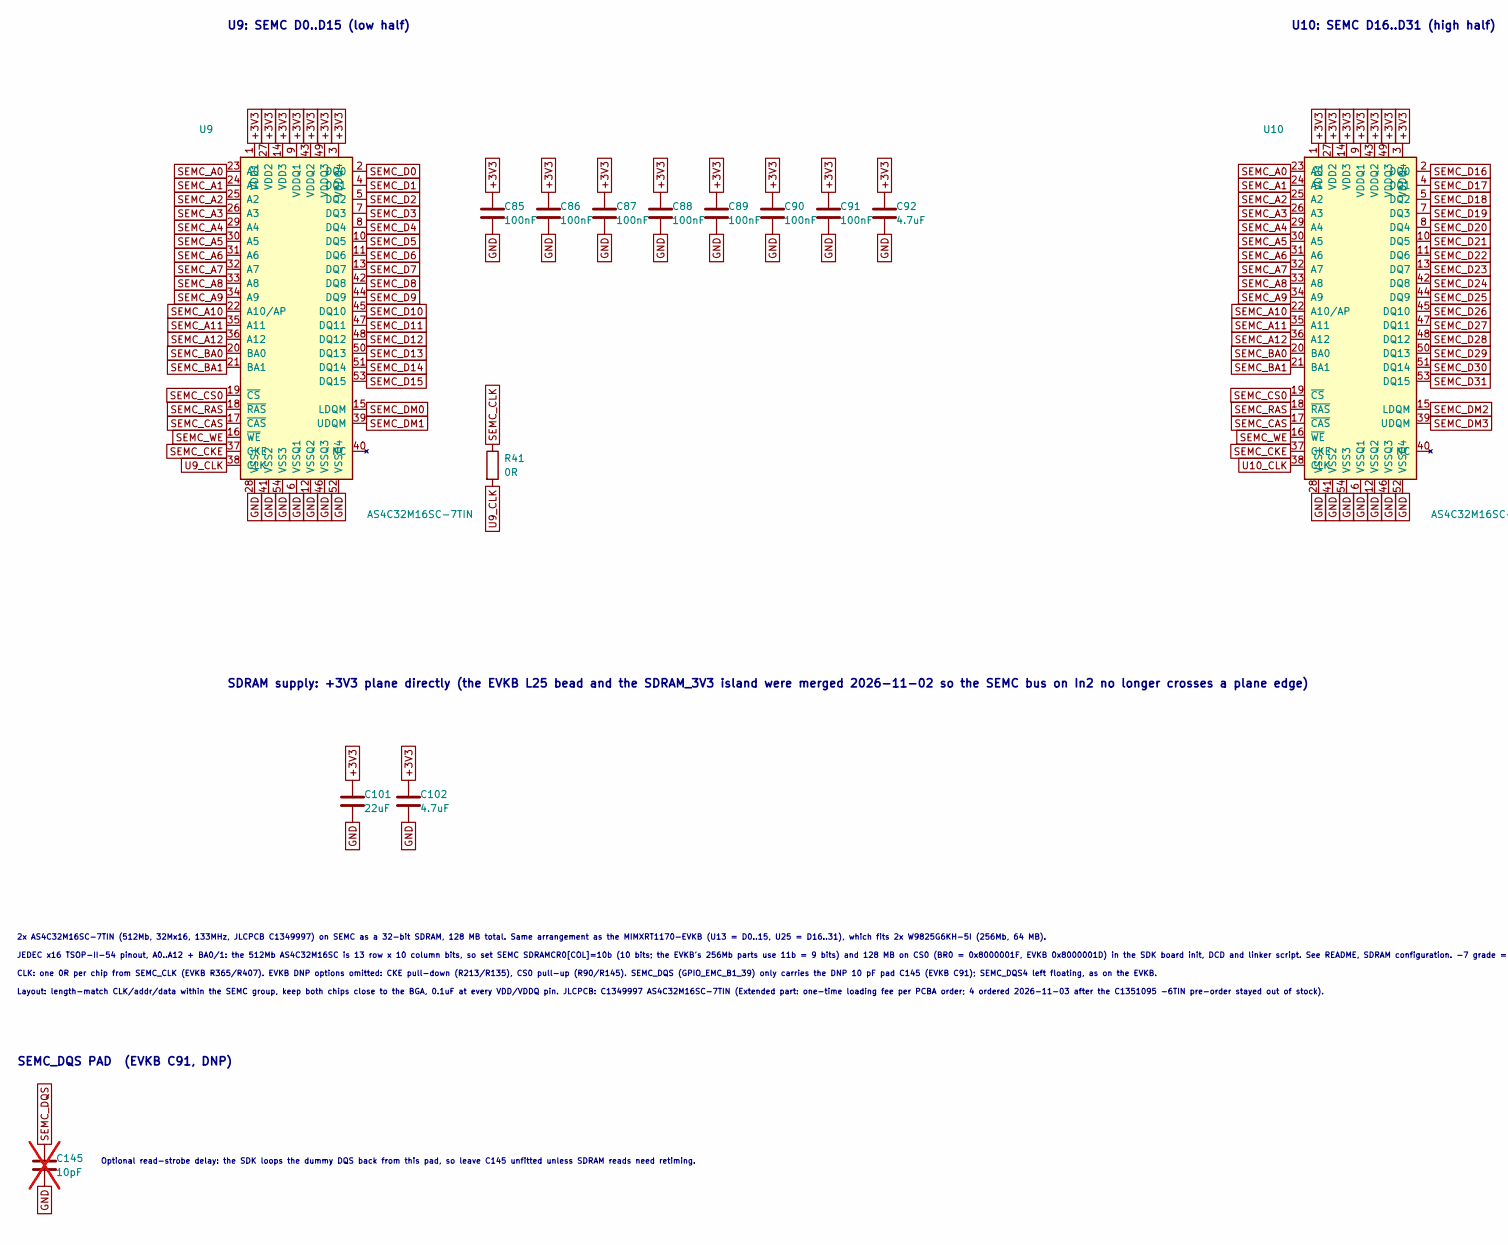
[picture p9: schematic sdram.kicad_sch, part in row 1, column 1]

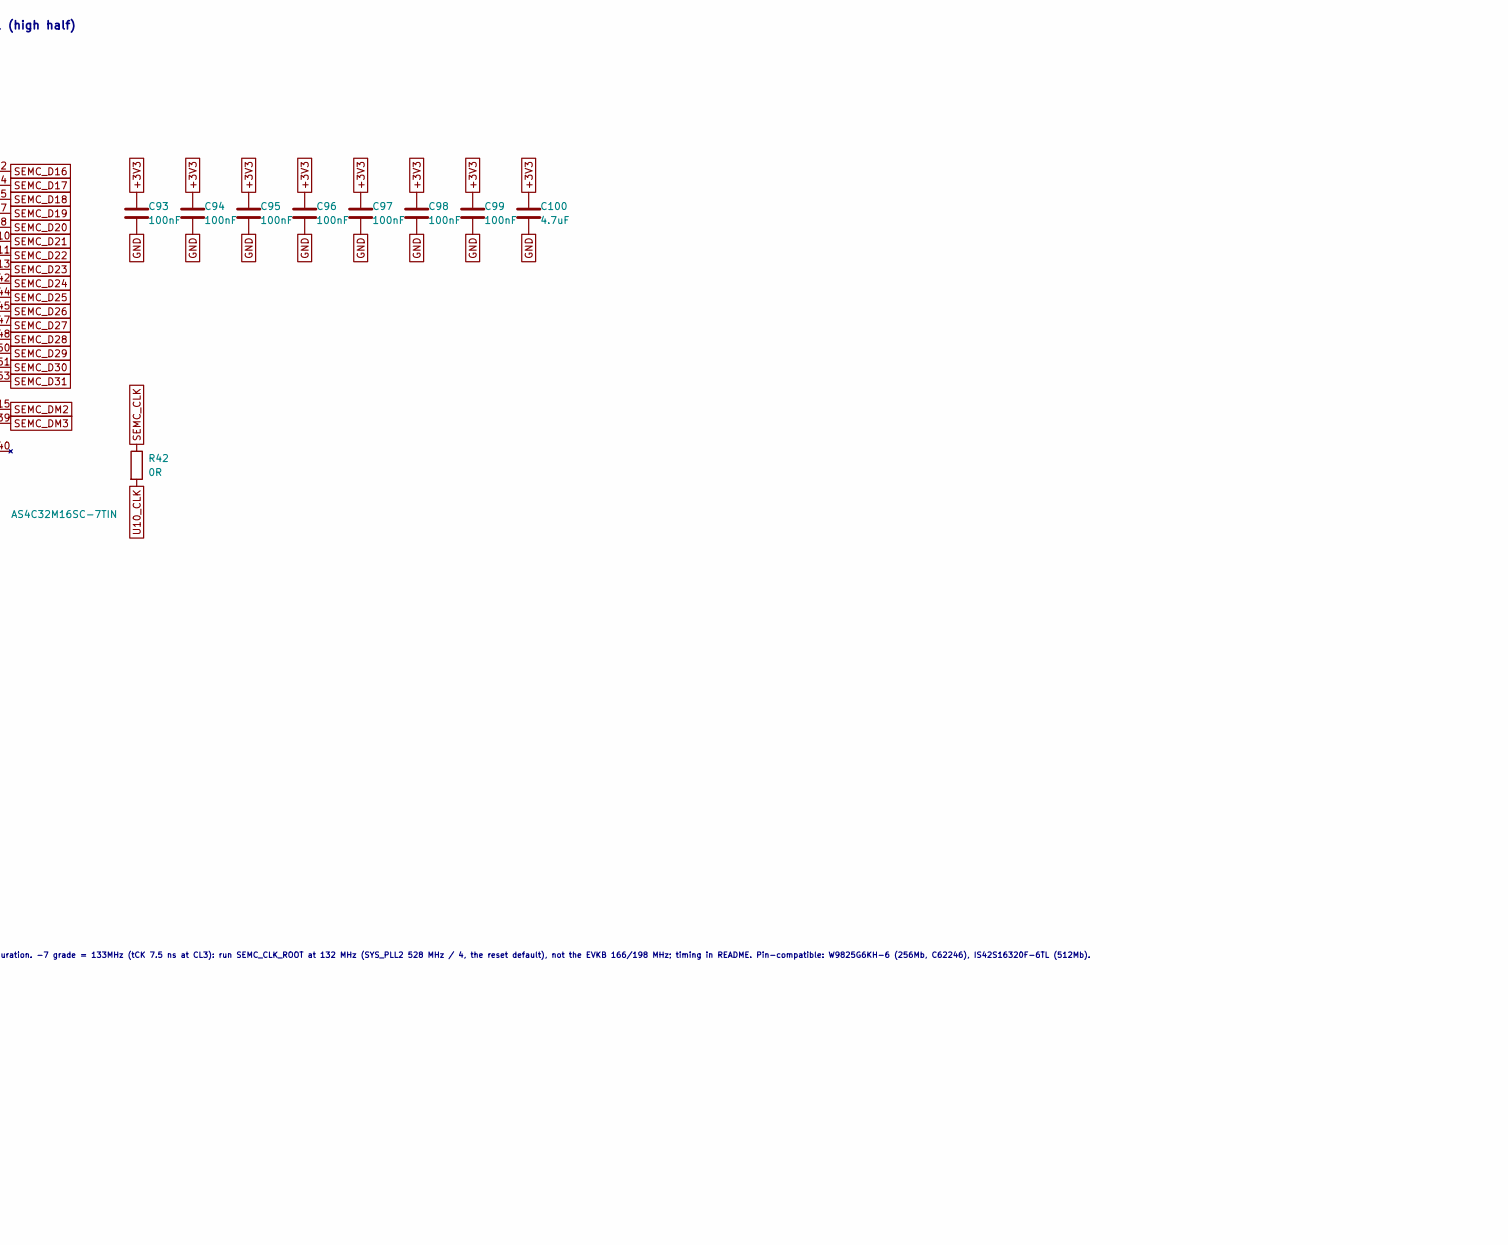
[picture p10: schematic sdram.kicad_sch, part in row 1, column 2]

Parts:
C85, C86, C87, C88, C89, C90, C91, C94, C95, C96, C97, C98, C99: 100nF; C_0402_1005Metric_JLC; MPN CL05B104KO5NNNC; LCSC C1525
C92, C100, C102: 4.7uF; C_0603_1608Metric; MPN CL10A475KO8NNNC; LCSC C19666
C93: 100nF; C_0402_1005Metric_ViP; MPN CL05B104KO5NNNC; LCSC C1525
C101: 22uF; C_0805_2012Metric; MPN CL21A226MAQNNNE; LCSC C45783
C145: 10pF; C_0402_1005Metric_JLC; MPN 0402CG100J500NT; LCSC C1545; not fitted
R41, R42: 0R; R_0402_1005Metric_JLC; MPN 0402WGF0000TCE; LCSC C17168
U9, U10: AS4C32M16SC-7TIN; TSOP-II-54_22.2x10.16mm_P0.8mm; MPN AS4C32M16SC-7TIN; LCSC C1349997

Connections:
+3V3: C85.1, C86.1, C87.1, C88.1, C89.1, C90.1, C91.1, C92.1, C93.1, C94.1, C95.1, C96.1, C97.1, C98.1, C99.1, C100.1, C101.1, C102.1, U9.1 (VDD1), U9.3 (VDDQ4), U9.9 (VDDQ1), U9.14 (VDD3), U9.27 (VDD2), U9.43 (VDDQ2), U9.49 (VDDQ3), U10.1 (VDD1), U10.3 (VDDQ4), U10.9 (VDDQ1), U10.14 (VDD3), U10.27 (VDD2), U10.43 (VDDQ2), U10.49 (VDDQ3); also elsewhere on the board
GND: C85.2, C86.2, C87.2, C88.2, C89.2, C90.2, C91.2, C92.2, C93.2, C94.2, C95.2, C96.2, C97.2, C98.2, C99.2, C100.2, C101.2, C102.2, C145.2, U9.6 (VSSQ1), U9.12 (VSSQ2), U9.28 (VSS1), U9.41 (VSS2), U9.46 (VSSQ3), U9.52 (VSSQ4), U9.54 (VSS3), U10.6 (VSSQ1), U10.12 (VSSQ2), U10.28 (VSS1), U10.41 (VSS2), U10.46 (VSSQ3), U10.52 (VSSQ4), U10.54 (VSS3); also elsewhere on the board
SEMC_A0: U9.23 (A0), U10.23 (A0); also elsewhere on the board
SEMC_A1: U9.24 (A1), U10.24 (A1); also elsewhere on the board
SEMC_A2: U9.25 (A2), U10.25 (A2); also elsewhere on the board
SEMC_A3: U9.26 (A3), U10.26 (A3); also elsewhere on the board
SEMC_A4: U9.29 (A4), U10.29 (A4); also elsewhere on the board
SEMC_A5: U9.30 (A5), U10.30 (A5); also elsewhere on the board
SEMC_A6: U9.31 (A6), U10.31 (A6); also elsewhere on the board
SEMC_A7: U9.32 (A7), U10.32 (A7); also elsewhere on the board
SEMC_A8: U9.33 (A8), U10.33 (A8); also elsewhere on the board
SEMC_A9: U9.34 (A9), U10.34 (A9); also elsewhere on the board
SEMC_A10: U9.22 (A10/AP), U10.22 (A10/AP); also elsewhere on the board
SEMC_A11: U9.35 (A11), U10.35 (A11); also elsewhere on the board
SEMC_A12: U9.36 (A12), U10.36 (A12); also elsewhere on the board
SEMC_BA0: U9.20 (BA0), U10.20 (BA0); also elsewhere on the board
SEMC_BA1: U9.21 (BA1), U10.21 (BA1); also elsewhere on the board
SEMC_CAS: U9.17 (~CAS), U10.17 (~CAS); also elsewhere on the board
SEMC_CKE: U9.37 (CKE), U10.37 (CKE); also elsewhere on the board
SEMC_CLK: R41.1, R42.1; also elsewhere on the board
SEMC_CS0: U9.19 (~CS), U10.19 (~CS); also elsewhere on the board
SEMC_D0: U9.2 (DQ0); also elsewhere on the board
SEMC_D1: U9.4 (DQ1); also elsewhere on the board
SEMC_D2: U9.5 (DQ2); also elsewhere on the board
SEMC_D3: U9.7 (DQ3); also elsewhere on the board
SEMC_D4: U9.8 (DQ4); also elsewhere on the board
SEMC_D5: U9.10 (DQ5); also elsewhere on the board
SEMC_D6: U9.11 (DQ6); also elsewhere on the board
SEMC_D7: U9.13 (DQ7); also elsewhere on the board
SEMC_D8: U9.42 (DQ8); also elsewhere on the board
SEMC_D9: U9.44 (DQ9); also elsewhere on the board
SEMC_D10: U9.45 (DQ10); also elsewhere on the board
SEMC_D11: U9.47 (DQ11); also elsewhere on the board
SEMC_D12: U9.48 (DQ12); also elsewhere on the board
SEMC_D13: U9.50 (DQ13); also elsewhere on the board
SEMC_D14: U9.51 (DQ14); also elsewhere on the board
SEMC_D15: U9.53 (DQ15); also elsewhere on the board
SEMC_D16: U10.2 (DQ0); also elsewhere on the board
SEMC_D17: U10.4 (DQ1); also elsewhere on the board
SEMC_D18: U10.5 (DQ2); also elsewhere on the board
SEMC_D19: U10.7 (DQ3); also elsewhere on the board
SEMC_D20: U10.8 (DQ4); also elsewhere on the board
SEMC_D21: U10.10 (DQ5); also elsewhere on the board
SEMC_D22: U10.11 (DQ6); also elsewhere on the board
SEMC_D23: U10.13 (DQ7); also elsewhere on the board
SEMC_D24: U10.42 (DQ8); also elsewhere on the board
SEMC_D25: U10.44 (DQ9); also elsewhere on the board
SEMC_D26: U10.45 (DQ10); also elsewhere on the board
SEMC_D27: U10.47 (DQ11); also elsewhere on the board
SEMC_D28: U10.48 (DQ12); also elsewhere on the board
SEMC_D29: U10.50 (DQ13); also elsewhere on the board
SEMC_D30: U10.51 (DQ14); also elsewhere on the board
SEMC_D31: U10.53 (DQ15); also elsewhere on the board
SEMC_DM0: U9.15 (LDQM); also elsewhere on the board
SEMC_DM1: U9.39 (UDQM); also elsewhere on the board
SEMC_DM2: U10.15 (LDQM); also elsewhere on the board
SEMC_DM3: U10.39 (UDQM); also elsewhere on the board
SEMC_DQS: C145.1; also elsewhere on the board
SEMC_RAS: U9.18 (~RAS), U10.18 (~RAS); also elsewhere on the board
SEMC_WE: U9.16 (~WE), U10.16 (~WE); also elsewhere on the board
U9_CLK: R41.2, U9.38 (CLK)
U10_CLK: R42.2, U10.38 (CLK)

Notes on the sheet:
SDRAM supply: +3V3 plane directly (the EVKB L25 bead and the SDRAM_3V3 island were merged 2026-11-02 so the SEMC bus on In2 no longer crosses a plane edge)
SEMC_DQS PAD (EVKB C91, DNP)
Layout: length-match CLK/addr/data within the SEMC group, keep both chips close to the BGA, 0.1uF at every VDD/VDDQ pin. JLCPCB: C1349997 AS4C32M16SC-7TIN (Extended part: one-time loading fee per PCBA order; 4 ordered 2026-11-03 after the C1351095 -6TIN pre-order stayed out of stock).
U9: SEMC D0..D15 (low half)
CLK: one 0R per chip from SEMC_CLK (EVKB R365/R407). EVKB DNP options omitted: CKE pull-down (R213/R135), CS0 pull-up (R90/R145). SEMC_DQS (GPIO_EMC_B1_39) only carries the DNP 10 pF pad C145 (EVKB C91); SEMC_DQS4 left floating, as on the EVKB.
JEDEC x16 TSOP-II-54 pinout, A0..A12 + BA0/1: the 512Mb AS4C32M16SC is 13 row x 10 column bits, so set SEMC SDRAMCR0[COL]=10b (10 bits; the EVKB's 256Mb parts use 11b = 9 bits) and 128 MB on CS0 (BR0 = 0x8000001F, EVKB 0x8000001D) in the SDK board init, DCD and linker script. See README, SDRAM conf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
U10: SEMC D16..D31 (high half)
2x AS4C32M16SC-7TIN (512Mb, 32Mx16, 133MHz, JLCPCB C1349997) on SEMC as a 32-bit SDRAM, 128 MB total. Same arrangement as the MIMXRT1170-EVKB (U13 = D0..15, U25 = D16..31), which fits 2x W9825G6KH-5I (256Mb, 64 MB).
Optional read-strobe delay: the SDK loops the dummy DQS back from this pad, so leave C145 unfitted unless SDRAM reads need retiming.

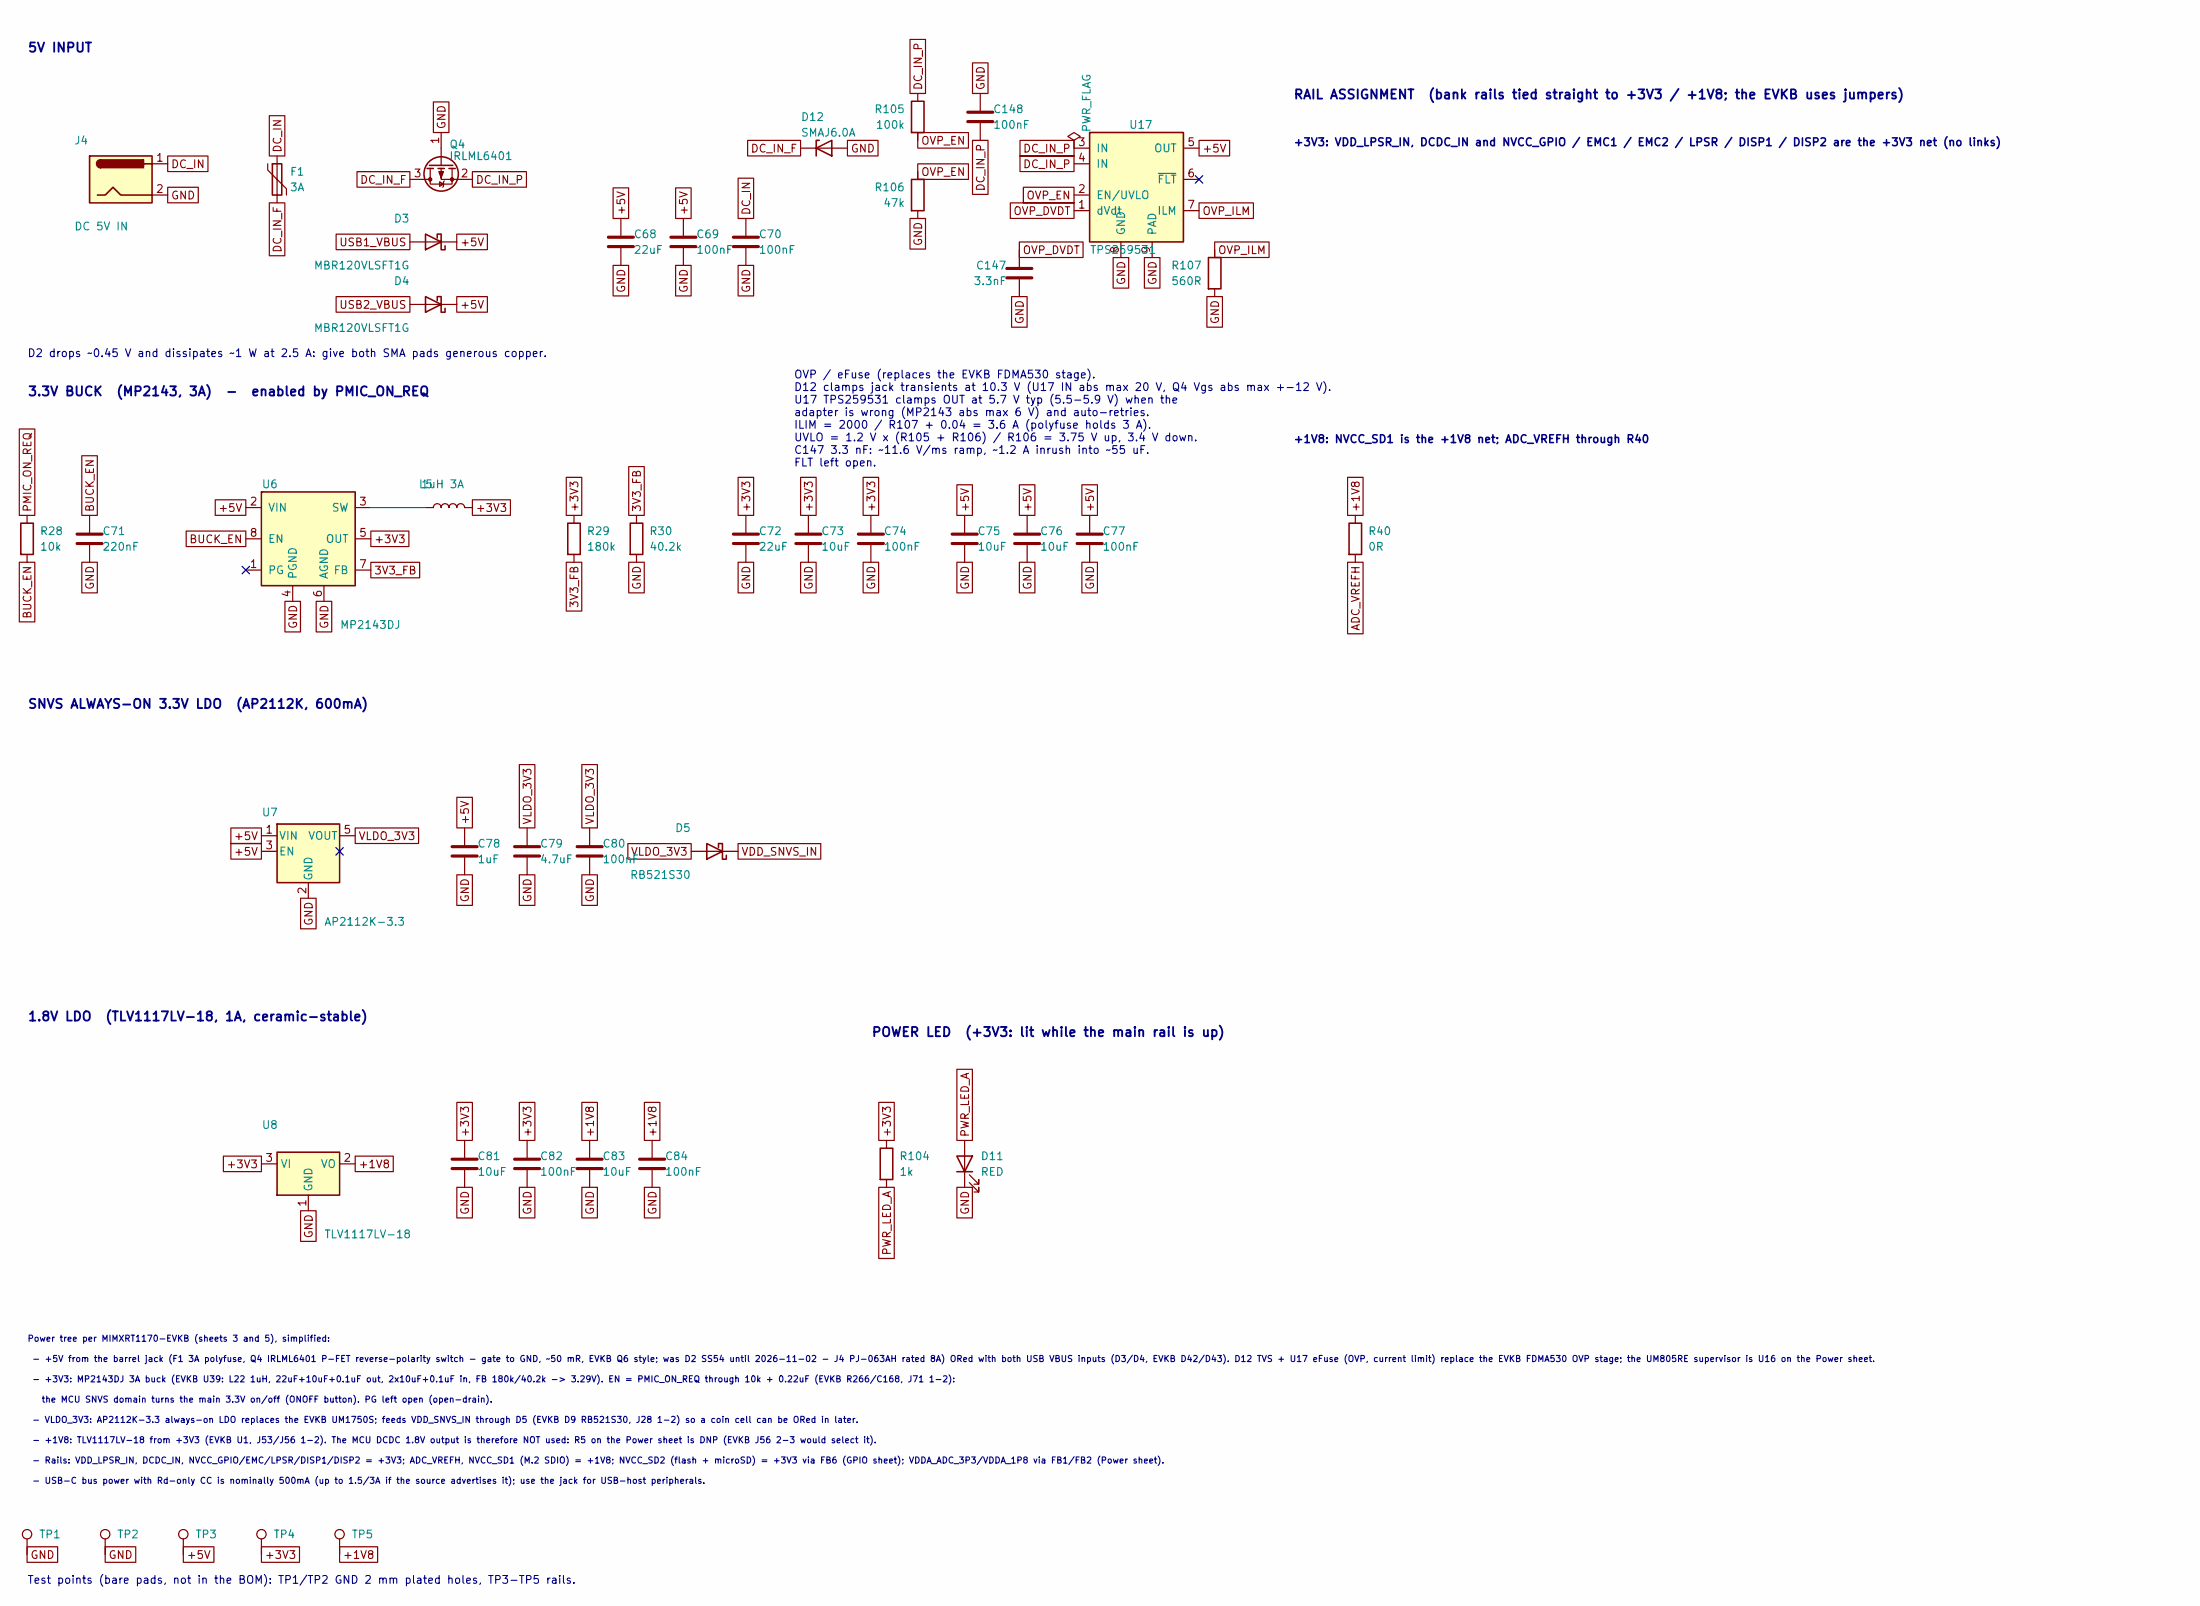
[picture p11: schematic supply.kicad_sch]

Parts:
C68, C72: 22uF; C_0805_2012Metric; MPN CL21A226MAQNNNE; LCSC C45783
C69, C70, C74, C77, C80, C82, C84, C148: 100nF; C_0402_1005Metric_JLC; MPN CL05B104KO5NNNC; LCSC C1525
C71: 220nF; C_0402_1005Metric_JLC; MPN CL05B224KO5NNNC; LCSC C16772
C73, C75, C76, C81, C83: 10uF; C_0603_1608Metric; MPN CL10A106KP8NNNC; LCSC C19702
C78: 1uF; C_0402_1005Metric_JLC; MPN CL05A105KA5NQNC; LCSC C52923
C79: 4.7uF; C_0603_1608Metric; MPN CL10A475KO8NNNC; LCSC C19666
C147: 3.3nF; C_0603_1608Metric; MPN CL10B332KB8NNNC; LCSC C1613
D3, D4: MBR120VLSFT1G; D_SOD-123F; MPN MBR120VLSFT1G; LCSC C223608
D5: RB521S30; D_SOD-523; MPN RB521S30T1G; LCSC C145179
D11: RED; LED_0603_1608Metric; MPN KT-0603R; LCSC C2286
D12: SMAJ6.0A; D_SMA; MPN SMAJ6.0A; LCSC C223993
F1: 3A; Fuse_1812_4532Metric; MPN SMD1812P300SLR/24; LCSC C2892380
J4: DC 5V IN; BarrelJack_CUI_PJ-063AH_Horizontal_JLC; MPN PJ-063AH; LCSC C22434582
L5: 1uH 3A; L_APV_ANR4020; MPN SWPA4020S1R0NT; LCSC C91254
Q4: IRLML6401; SOT-23; MPN IRLML6401TRPBF; LCSC C3034
R28: 10k; R_0402_1005Metric_JLC; MPN 0402WGF1002TCE; LCSC C25744
R29: 180k; R_0402_1005Metric_JLC; MPN 0402WGF1803TCE; LCSC C25760
R30: 40.2k; R_0402_1005Metric_JLC; MPN 0402WGF4022TCE; LCSC C25893
R40: 0R; R_0603_1608Metric; MPN 0603WAF0000T5E; LCSC C21189
R104: 1k; R_0402_1005Metric_JLC; MPN 0402WGF1001TCE; LCSC C11702
R105: 100k; R_0402_1005Metric_JLC; MPN 0402WGF1003TCE; LCSC C25741
R106: 47k; R_0402_1005Metric_JLC; MPN 0402WGF4702TCE; LCSC C25792
R107: 560R; R_0402_1005Metric_JLC; MPN 0402WGF5600TCE; LCSC C25126
TP1, TP2: TestPoint; TestPoint_THTPad_D2.0mm_Drill1.0mm_JLC
TP3, TP4, TP5: TestPoint; TestPoint_Pad_D1.0mm_JLC
U6: MP2143DJ; TSOT-23-8; MPN MP2143DJ-LF-Z; LCSC C43427
U7: AP2112K-3.3; SOT-23-5; MPN AP2112K-3.3TRG1; LCSC C51118
U8: TLV1117LV-18; SOT-223-3_TabPin2; MPN TLV1117LV18DCYR; LCSC C80105
U17: TPS259531; Texas_DSG0008A_WSON-8-1EP_2x2mm_P0.5mm_EP0.9x1.6mm; MPN TPS259531DSGR; LCSC C2155674

Connections:
3V3_FB: R29.2, R30.1, U6.7 (FB)
+1V8: C83.1, C84.1, R40.1, TP5.1, U8.2 (VO); also elsewhere on the board
+3V3: C72.1, C73.1, C74.1, C81.1, C82.1, L5.2, R29.1, R104.1, TP4.1, U6.5 (OUT), U8.3 (VI); also elsewhere on the board
+5V: C68.1, C69.1, C75.1, C76.1, C77.1, C78.1, D3.1 (K), D4.1 (K), TP3.1, U6.2 (VIN), U7.1 (VIN), U7.3 (EN), U17.5 (OUT); also elsewhere on the board
ADC_VREFH: R40.2; also elsewhere on the board
BUCK_EN: C71.1, R28.2, U6.8 (EN)
DC_IN: C70.1, F1.1, J4.1
DC_IN_F: D12.1 (K), F1.2, Q4.3 (D)
DC_IN_P: C148.2, Q4.2 (S), R105.1, U17.3 (IN), U17.4 (IN)
GND: C68.2, C69.2, C70.2, C71.2, C72.2, C73.2, C74.2, C75.2, C76.2, C77.2, C78.2, C79.2, C80.2, C81.2, C82.2, C83.2, C84.2, C147.2, C148.1, D11.1 (K), D12.2 (A), J4.2, Q4.1 (G), R30.2, R106.2, R107.2, TP1.1, TP2.1, U6.4 (PGND), U6.6 (AGND), U7.2 (GND), U8.1 (GND), U17.8 (GND), U17.9 (PAD); also elsewhere on the board
unnamed: L5.1, U6.3 (SW)
OVP_DVDT: C147.1, U17.1 (dVdt)
OVP_EN: R105.2, R106.1, U17.2 (EN/UVLO)
OVP_ILM: R107.1, U17.7 (ILM)
PMIC_ON_REQ: R28.1; also elsewhere on the board
PWR_LED_A: D11.2 (A), R104.2
USB1_VBUS: D3.2 (A); also elsewhere on the board
USB2_VBUS: D4.2 (A); also elsewhere on the board
VDD_SNVS_IN: D5.1 (K); also elsewhere on the board
VLDO_3V3: C79.1, C80.1, D5.2 (A), U7.5 (VOUT)

Notes on the sheet:
- +5V from the barrel jack (F1 3A polyfuse, Q4 IRLML6401 P-FET reverse-polarity switch - gate to GND, ~50 mR, EVKB Q6 style; was D2 SS54 until 2026-11-02 - J4 PJ-063AH rated 8A) ORed with both USB VBUS inputs (D3/D4, EVKB D42/D43). D12 TVS + U17 eFuse (OVP, current limit) replace the EVKB FDMA530 O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
+1V8: NVCC_SD1 is the +1V8 net; ADC_VREFH through R40
5V INPUT
- USB-C bus power with Rd-only CC is nominally 500mA (up to 1.5/3A if the source advertises it); use the jack for USB-host peripherals.
D2 drops ~0.45 V and dissipates ~1 W at 2.5 A: give both SMA pads generous copper.
RAIL ASSIGNMENT (bank rails tied straight to +3V3 / +1V8; the EVKB uses jumpers)
SNVS ALWAYS-ON 3.3V LDO (AP2112K, 600mA)
- +3V3: MP2143DJ 3A buck (EVKB U39: L22 1uH, 22uF+10uF+0.1uF out, 2x10uF+0.1uF in, FB 180k/40.2k -> 3.29V). EN = PMIC_ON_REQ through 10k + 0.22uF (EVKB R266/C168, J71 1-2):
Power tree per MIMXRT1170-EVKB (sheets 3 and 5), simplified:
- VLDO_3V3: AP2112K-3.3 always-on LDO replaces the EVKB UM1750S; feeds VDD_SNVS_IN through D5 (EVKB D9 RB521S30, J28 1-2) so a coin cell can be ORed in later.
POWER LED (+3V3: lit while the main rail is up)
1.8V LDO (TLV1117LV-18, 1A, ceramic-stable)
3.3V BUCK (MP2143, 3A) - enabled by PMIC_ON_REQ
the MCU SNVS domain turns the main 3.3V on/off (ONOFF button). PG left open (open-drain).
+3V3: VDD_LPSR_IN, DCDC_IN and NVCC_GPIO / EMC1 / EMC2 / LPSR / DISP1 / DISP2 are the +3V3 net (no links)
- Rails: VDD_LPSR_IN, DCDC_IN, NVCC_GPIO/EMC/LPSR/DISP1/DISP2 = +3V3; ADC_VREFH, NVCC_SD1 (M.2 SDIO) = +1V8; NVCC_SD2 (flash + microSD) = +3V3 via FB6 (GPIO sheet); VDDA_ADC_3P3/VDDA_1P8 via FB1/FB2 (Power sheet).
- +1V8: TLV1117LV-18 from +3V3 (EVKB U1, J53/J56 1-2). The MCU DCDC 1.8V output is therefore NOT used: R5 on the Power sheet is DNP (EVKB J56 2-3 would select it).
OVP / eFuse (replaces the EVKB FDMA530 stage). D12 clamps jack transients at 10.3 V (U17 IN abs max 20 V, Q4 Vgs abs max +-12 V). U17 TPS259531 clamps OUT at 5.7 V typ (5.5-5.9 V) when the adapter is wrong (MP2143 abs max 6 V) and auto-retries. ILIM = 2000 / R107 + 0.04 = 3.6 A (polyfuse holds 3 A)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
Test points (bare pads, not in the BOM): TP1/TP2 GND 2 mm plated holes, TP3-TP5 rails.

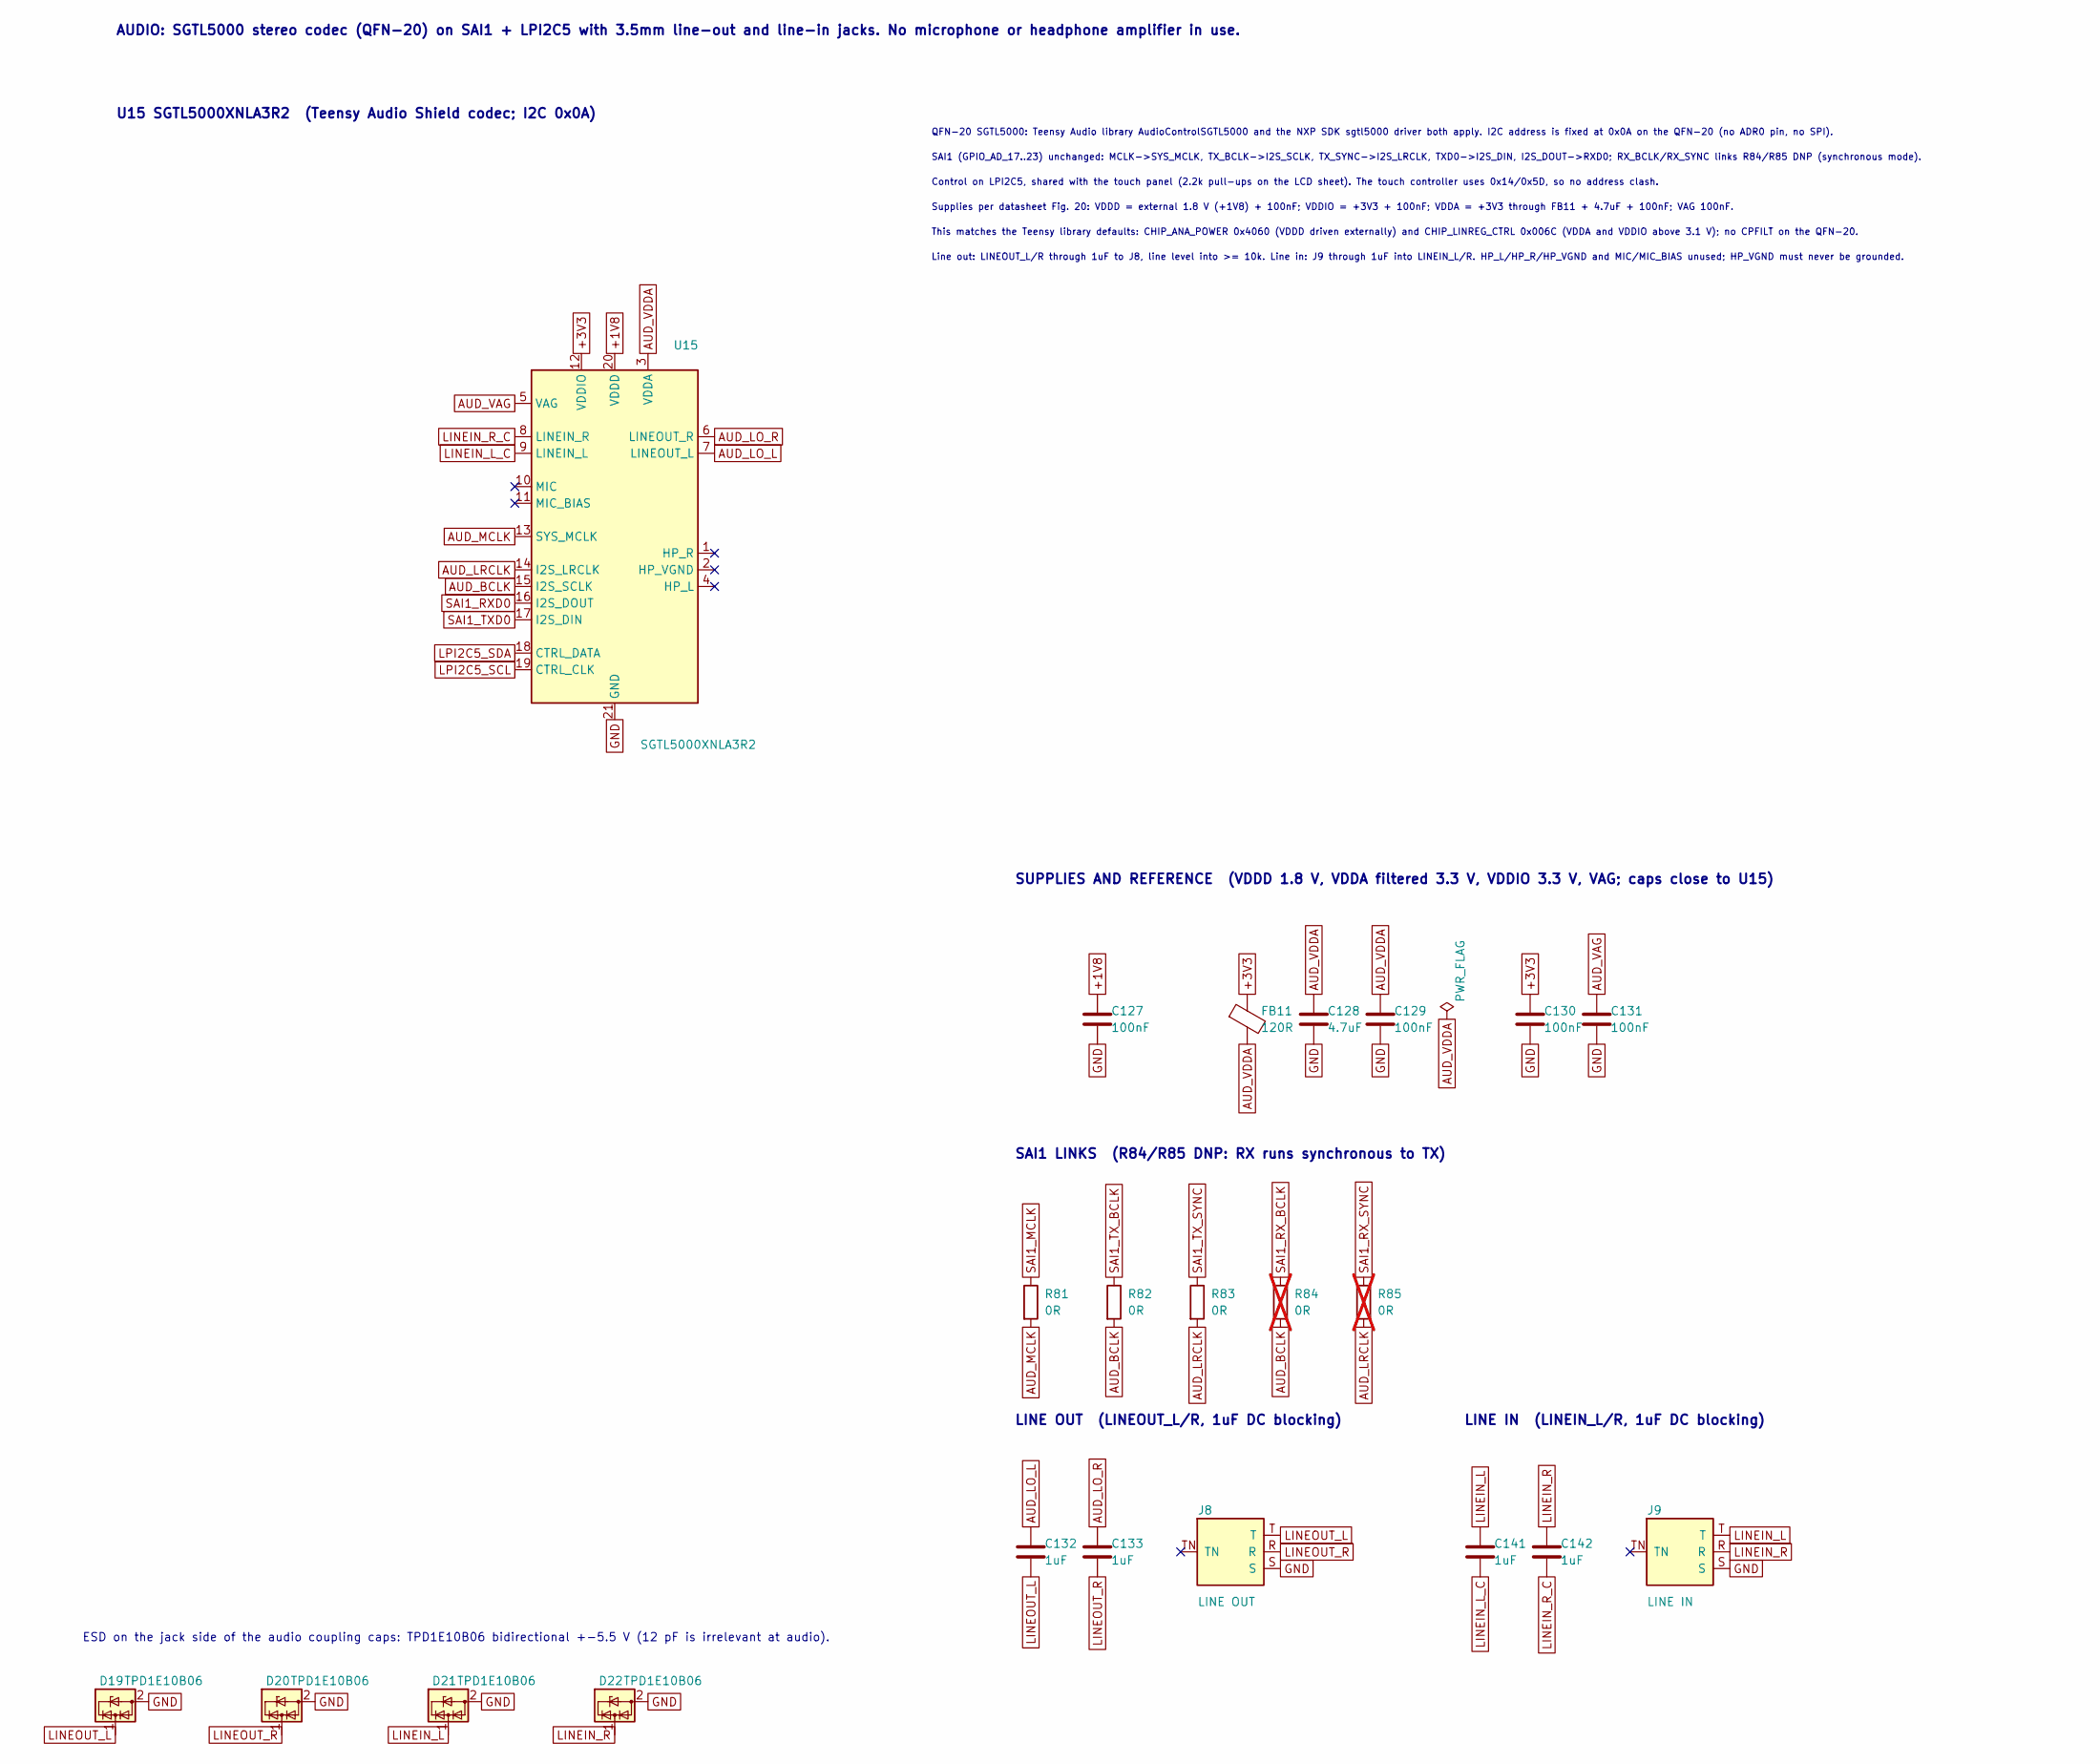
[picture p12: schematic audio.kicad_sch]

Parts:
C127, C129, C130, C131: 100nF; C_0402_1005Metric_JLC; MPN CL05B104KO5NNNC; LCSC C1525
C128: 4.7uF; C_0402_1005Metric_JLC; MPN CL05A475MP5NRNC; LCSC C23733
C132, C133, C141, C142: 1uF; C_0402_1005Metric_JLC; MPN CL05A105KA5NQNC; LCSC C52923
D19, D20, D21, D22: TPD1E10B06; ESD_X1SON-2_0.6x1mm_JLC; MPN TPD1E10B06DPYR; LCSC C48260
FB11: 120R; L_0402_1005Metric; MPN BLM15AG121SN1D; LCSC C85812
J8: LINE OUT; Jack_3.5mm_CUI_SJ-3524-SMT_Horizontal_JLC; MPN SJ-3524-SMT-TR; LCSC C20182907
J9: LINE IN; Jack_3.5mm_CUI_SJ-3524-SMT_Horizontal_JLC; MPN SJ-3524-SMT-TR; LCSC C20182907
R81, R82, R83: 0R; R_0402_1005Metric_JLC; MPN 0402WGF0000TCE; LCSC C17168
R84, R85: 0R; R_0402_1005Metric_JLC; MPN 0402WGF0000TCE; LCSC C17168; not fitted
U15: SGTL5000XNLA3R2; QFN-20-1EP_3x3mm_P0.4mm_EP1.65x1.65mm; MPN SGTL5000XNLA3R2; LCSC C2651833

Connections:
+1V8: C127.1, U15.20 (VDDD); also elsewhere on the board
+3V3: C130.1, FB11.1, U15.12 (VDDIO); also elsewhere on the board
AUD_BCLK: R82.2, R84.2, U15.15 (I2S_SCLK)
AUD_LO_L: C132.1, U15.7 (LINEOUT_L)
AUD_LO_R: C133.1, U15.6 (LINEOUT_R)
AUD_LRCLK: R83.2, R85.2, U15.14 (I2S_LRCLK)
AUD_MCLK: R81.2, U15.13 (SYS_MCLK)
AUD_VAG: C131.1, U15.5 (VAG)
AUD_VDDA: C128.1, C129.1, FB11.2, U15.3 (VDDA)
GND: C127.2, C128.2, C129.2, C130.2, C131.2, D19.2 (GND), D20.2 (GND), D21.2 (GND), D22.2 (GND), J8.S, J9.S, U15.21 (GND); also elsewhere on the board
LINEIN_L: C141.1, D21.1 (I/O), J9.T
LINEIN_L_C: C141.2, U15.9 (LINEIN_L)
LINEIN_R: C142.1, D22.1 (I/O), J9.R
LINEIN_R_C: C142.2, U15.8 (LINEIN_R)
LINEOUT_L: C132.2, D19.1 (I/O), J8.T
LINEOUT_R: C133.2, D20.1 (I/O), J8.R
LPI2C5_SCL: U15.19 (CTRL_CLK); also elsewhere on the board
LPI2C5_SDA: U15.18 (CTRL_DATA); also elsewhere on the board
SAI1_MCLK: R81.1; also elsewhere on the board
SAI1_RXD0: U15.16 (I2S_DOUT); also elsewhere on the board
SAI1_RX_BCLK: R84.1; also elsewhere on the board
SAI1_RX_SYNC: R85.1; also elsewhere on the board
SAI1_TXD0: U15.17 (I2S_DIN); also elsewhere on the board
SAI1_TX_BCLK: R82.1; also elsewhere on the board
SAI1_TX_SYNC: R83.1; also elsewhere on the board

Notes on the sheet:
LINE OUT (LINEOUT_L/R, 1uF DC blocking)
Control on LPI2C5, shared with the touch panel (2.2k pull-ups on the LCD sheet). The touch controller uses 0x14/0x5D, so no address clash.
SAI1 LINKS (R84/R85 DNP: RX runs synchronous to TX)
SUPPLIES AND REFERENCE (VDDD 1.8 V, VDDA filtered 3.3 V, VDDIO 3.3 V, VAG; caps close to U15)
This matches the Teensy library defaults: CHIP_ANA_POWER 0x4060 (VDDD driven externally) and CHIP_LINREG_CTRL 0x006C (VDDA and VDDIO above 3.1 V); no CPFILT on the QFN-20.
LINE IN (LINEIN_L/R, 1uF DC blocking)
U15 SGTL5000XNLA3R2 (Teensy Audio Shield codec; I2C 0x0A)
Line out: LINEOUT_L/R through 1uF to J8, line level into >= 10k. Line in: J9 through 1uF into LINEIN_L/R. HP_L/HP_R/HP_VGND and MIC/MIC_BIAS unused; HP_VGND must never be grounded.
QFN-20 SGTL5000: Teensy Audio library AudioControlSGTL5000 and the NXP SDK sgtl5000 driver both apply. I2C address is fixed at 0x0A on the QFN-20 (no ADR0 pin, no SPI).
AUDIO: SGTL5000 stereo codec (QFN-20) on SAI1 + LPI2C5 with 3.5mm line-out and line-in jacks. No microphone or headphone amplifier in use.
Supplies per datasheet Fig. 20: VDDD = external 1.8 V (+1V8) + 100nF; VDDIO = +3V3 + 100nF; VDDA = +3V3 through FB11 + 4.7uF + 100nF; VAG 100nF.
SAI1 (GPIO_AD_17..23) unchanged: MCLK->SYS_MCLK, TX_BCLK->I2S_SCLK, TX_SYNC->I2S_LRCLK, TXD0->I2S_DIN, I2S_DOUT->RXD0; RX_BCLK/RX_SYNC links R84/R85 DNP (synchronous mode).
ESD on the jack side of the audio coupling caps: TPD1E10B06 bidirectional +-5.5 V (12 pF is irrelevant at audio).
