newdigate/nosh-dev-board/Kicad/Nosh.kicad_pcb

## KiCad design Kicad/Nosh.kicad_pcb (continued)

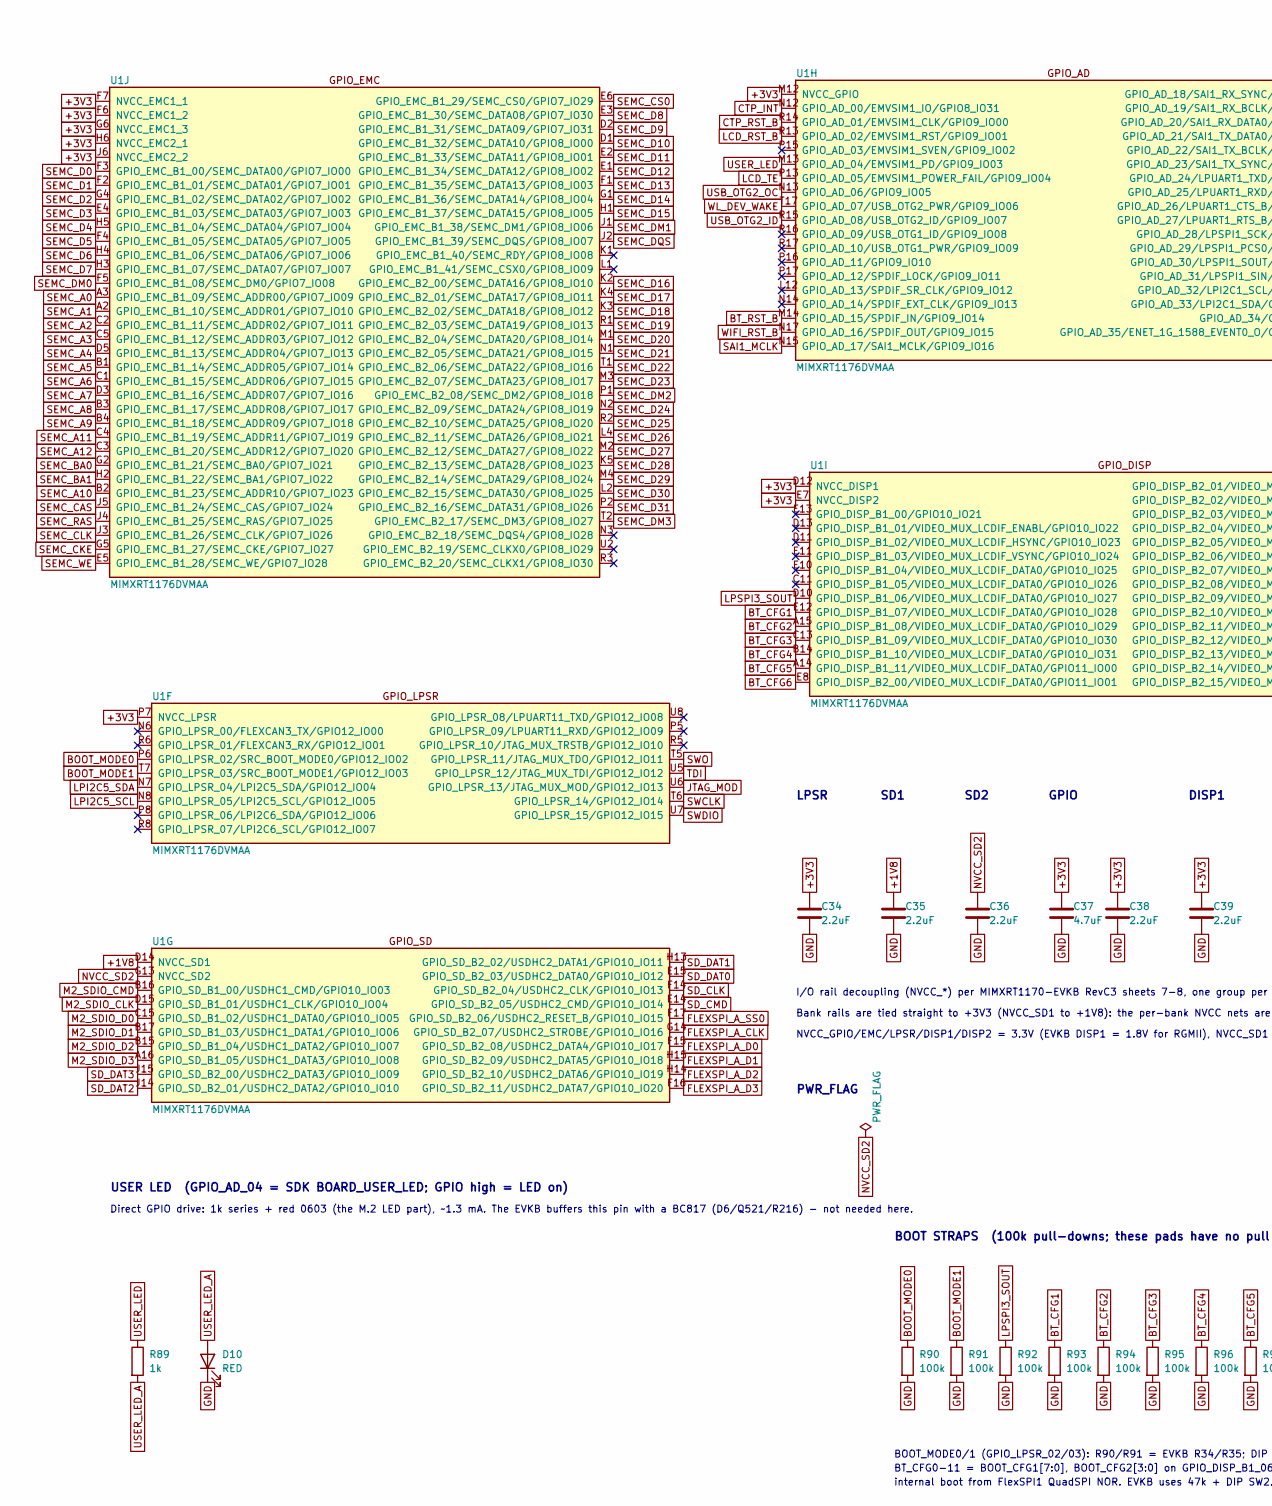
[picture p13: schematic gpio.kicad_sch, part in row 1, column 1]

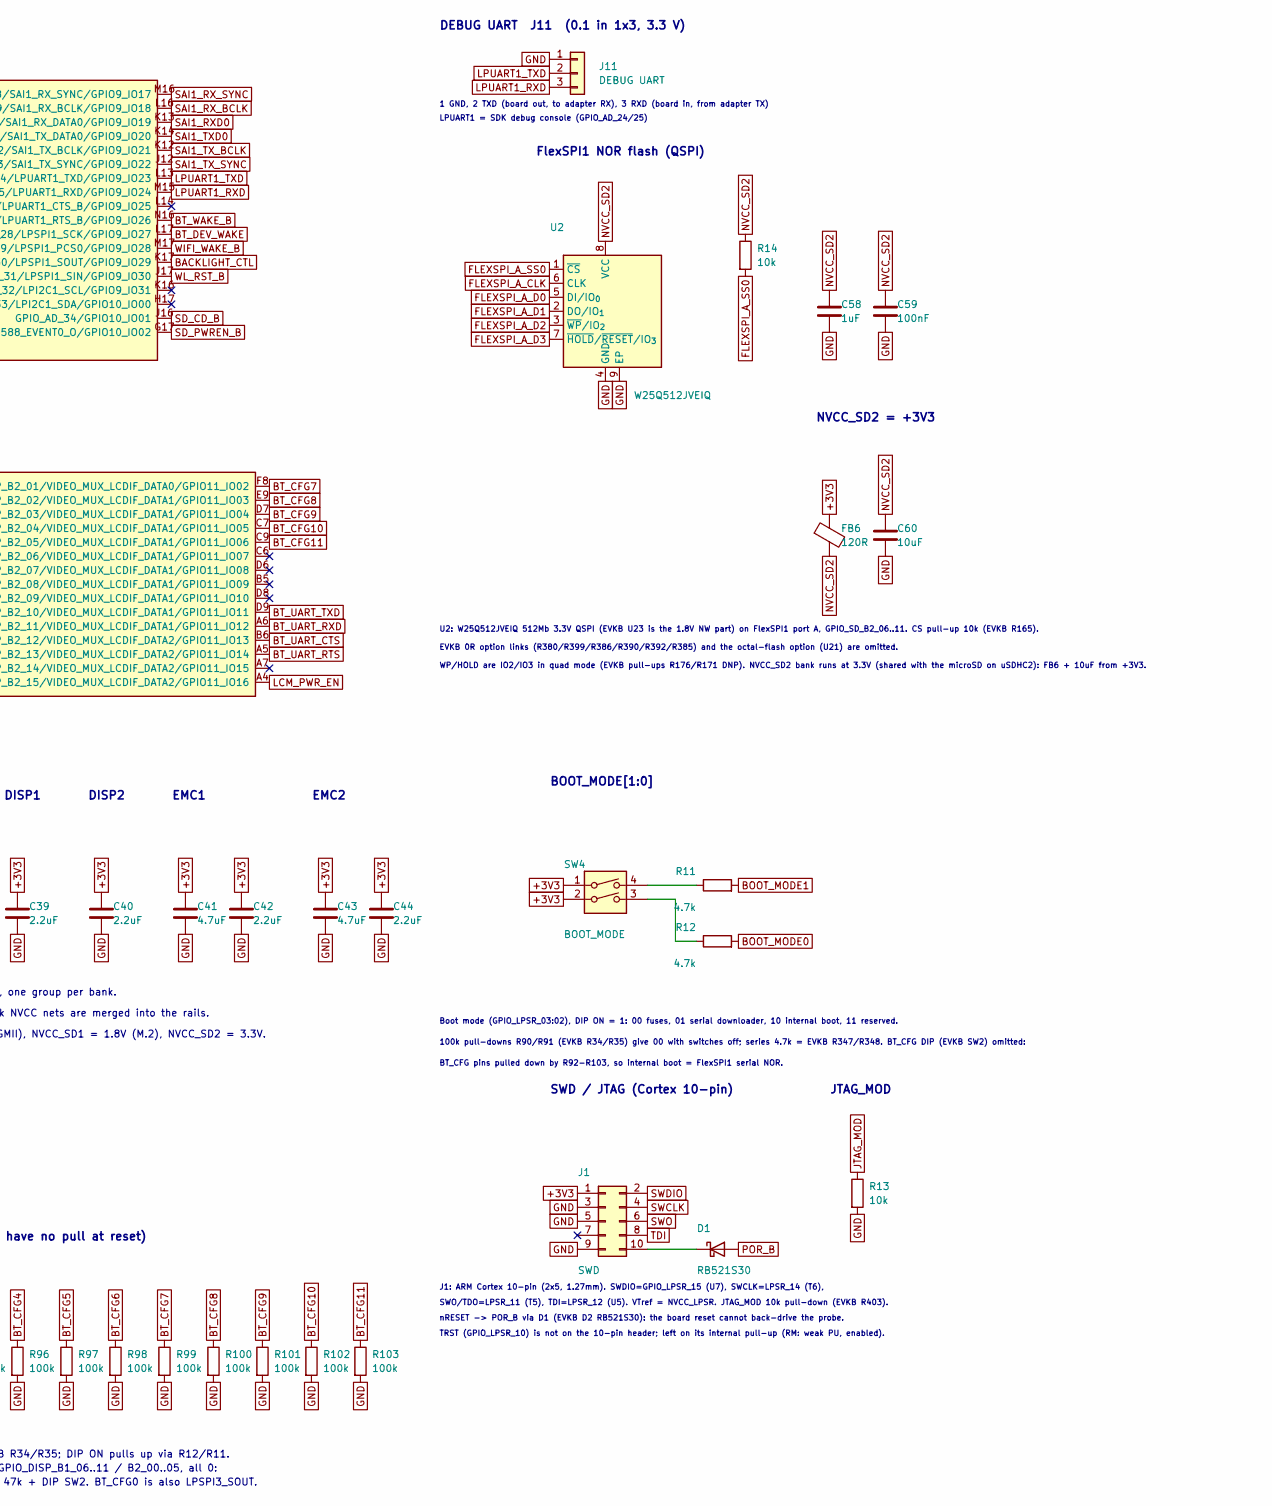
[picture p14: schematic gpio.kicad_sch, part in row 1, column 2]

Parts:
C34, C35, C36, C38, C42, C44: 2.2uF; C_0402_1005Metric_ViP; MPN CL05A225MQ5NSNC; LCSC C12530
C37: 4.7uF; C_0402_1005Metric_ViP; MPN CL05A475MP5NRNC; LCSC C23733
C39, C40: 2.2uF; C_0402_1005Metric_JLC; MPN CL05A225MQ5NSNC; LCSC C12530
C41, C43: 4.7uF; C_0402_1005Metric_JLC; MPN CL05A475MP5NRNC; LCSC C23733
C58: 1uF; C_0402_1005Metric_JLC; MPN CL05A105KA5NQNC; LCSC C52923
C59: 100nF; C_0402_1005Metric_JLC; MPN CL05B104KO5NNNC; LCSC C1525
C60: 10uF; C_0603_1608Metric; MPN CL10A106KP8NNNC; LCSC C19702
D1: RB521S30; D_SOD-523; MPN RB521S30T1G; LCSC C145179
D10: RED; LED_0603_1608Metric; MPN KT-0603R; LCSC C2286
FB6: 120R; L_0402_1005Metric; MPN BLM15AG121SN1D; LCSC C85812
J1: SWD; PinHeader_2x05_P1.27mm_Vertical_SMD; MPN 20021121-00010C4LF; LCSC C150517
J11: DEBUG UART; PinHeader_1x03_P2.54mm_Vertical; MPN PZ254V-11-03P; LCSC C2937625
R11, R12: 4.7k; R_0402_1005Metric_JLC; MPN 0402WGF4701TCE; LCSC C25900
R13, R14: 10k; R_0402_1005Metric_JLC; MPN 0402WGF1002TCE; LCSC C25744
R89: 1k; R_0402_1005Metric_JLC; MPN 0402WGF1001TCE; LCSC C11702
R90, R91, R92, R93, R94, R95, R96, R97, R98, R99, R100, R101, R102, R103: 100k; R_0402_1005Metric_JLC; MPN 0402WGF1003TCE; LCSC C25741
SW4: BOOT_MODE; SW_DIP_SPSTx02_Slide_KingTek_DSHP02TS_W7.62mm_P1.27mm; MPN DSHP02TSGER; LCSC C3293142
U1: MIMXRT1176DVMAA; MAPBGA-289_14x14mm_Layout17x17_P0.8mm; MPN MIMXRT1176DVMAA; LCSC C1020237
U2: W25Q512JVEIQ; WSON-8-1EP_8x6mm_P1.27mm_EP3.4x4.3mm; MPN W25Q512JVEIQ; LCSC C7389628

Connections:
+1V8: C35.1, U1.D14 (NVCC_SD1); also elsewhere on the board
+3V3: C34.1, C37.1, C38.1, C39.1, C40.1, C41.1, C42.1, C43.1, C44.1, FB6.1, J1.1, SW4.1, SW4.2, U1.D12 (NVCC_DISP1), U1.E7 (NVCC_DISP2), U1.F6 (NVCC_EMC1_2), U1.F7 (NVCC_EMC1_1), U1.G6 (NVCC_EMC1_3), U1.H6 (NVCC_EMC2_1), U1.J6 (NVCC_EMC2_2), U1.M12 (NVCC_GPIO), U1.P7 (NVCC_LPSR); also elsewhere on the board
BACKLIGHT_CTL: U1.K17 (GPIO_AD_30/LPSPI1_SOUT/GPIO9_IO29); also elsewhere on the board
BOOT_MODE0: R12.2, R90.1, U1.P6 (GPIO_LPSR_02/SRC_BOOT_MODE0/GPIO12_IO02)
BOOT_MODE1: R11.2, R91.1, U1.T7 (GPIO_LPSR_03/SRC_BOOT_MODE1/GPIO12_IO03)
BT_CFG1: R93.1, U1.E12 (GPIO_DISP_B1_07/VIDEO_MUX_LCDIF_DATA0/G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)
BT_CFG2: R94.1, U1.A15 (GPIO_DISP_B1_08/VIDEO_MUX_LCDIF_DATA0/G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)
BT_CFG3: R95.1, U1.C13 (GPIO_DISP_B1_09/VIDEO_MUX_LCDIF_DATA0/G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)
BT_CFG4: R96.1, U1.B14 (GPIO_DISP_B1_10/VIDEO_MUX_LCDIF_DATA0/G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)
BT_CFG5: R97.1, U1.A14 (GPIO_DISP_B1_11/VIDEO_MUX_LCDIF_DATA0/G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)
BT_CFG6: R98.1, U1.E8 (GPIO_DISP_B2_00/VIDEO_MUX_LCDIF_DATA0/G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)
BT_CFG7: R99.1, U1.F8 (GPIO_DISP_B2_01/VIDEO_MUX_LCDIF_DATA0/G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)
BT_CFG8: R100.1, U1.E9 (GPIO_DISP_B2_02/VIDEO_MUX_LCDIF_DATA1/G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)
BT_CFG9: R101.1, U1.D7 (GPIO_DISP_B2_03/VIDEO_MUX_LCDIF_DATA1/G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)
BT_CFG10: R102.1, U1.C7 (GPIO_DISP_B2_04/VIDEO_MUX_LCDIF_DATA1/G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)
BT_CFG11: R103.1, U1.C9 (GPIO_DISP_B2_05/VIDEO_MUX_LCDIF_DATA1/G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)
BT_DEV_WAKE: U1.L17 (GPIO_AD_28/LPSPI1_SCK/GPIO9_IO27); also elsewhere on the board
BT_RST_B: U1.M14 (GPIO_AD_15/SPDIF_IN/GPIO9_IO14); also elsewhere on the board
BT_UART_CTS: U1.B6 (GPIO_DISP_B2_12/VIDEO_MUX_LCDIF_DATA2/G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); also elsewhere on the board
BT_UART_RTS: U1.A5 (GPIO_DISP_B2_13/VIDEO_MUX_LCDIF_DATA2/G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); also elsewhere on the board
BT_UART_RXD: U1.A6 (GPIO_DISP_B2_11/VIDEO_MUX_LCDIF_DATA1/G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); also elsewhere on the board
BT_UART_TXD: U1.D9 (GPIO_DISP_B2_10/VIDEO_MUX_LCDIF_DATA1/G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); also elsewhere on the board
BT_WAKE_B: U1.N16 (GPIO_AD_27/LPUART1_RTS_B/GPIO9_IO26); also elsewhere on the board
CTP_INT: U1.N12 (GPIO_AD_00/EMVSIM1_IO/GPIO8_IO31); also elsewhere on the board
CTP_RST_B: U1.R14 (GPIO_AD_01/EMVSIM1_CLK/GPIO9_IO00); also elsewhere on the board
FLEXSPI_A_CLK: U1.G14 (GPIO_SD_B2_07/USDHC2_STROBE/GPIO10_IO16), U2.6 (CLK)
FLEXSPI_A_D0: U1.F15 (GPIO_SD_B2_08/USDHC2_DATA4/GPIO10_IO17), U2.5 (DI/IO_{0})
FLEXSPI_A_D1: U1.H15 (GPIO_SD_B2_09/USDHC2_DATA5/GPIO10_IO18), U2.2 (DO/IO_{1})
FLEXSPI_A_D2: U1.H14 (GPIO_SD_B2_10/USDHC2_DATA6/GPIO10_IO19), U2.3 (~WP/IO_{2})
FLEXSPI_A_D3: U1.F16 (GPIO_SD_B2_11/USDHC2_DATA7/GPIO10_IO20), U2.7 (~HOLD/~RESET/IO_{3})
FLEXSPI_A_SS0: R14.2, U1.F17 (GPIO_SD_B2_06/USDHC2_RESET_B/GPIO10_IO15), U2.1 (~CS)
GND: C34.2, C35.2, C36.2, C37.2, C38.2, C39.2, C40.2, C41.2, C42.2, C43.2, C44.2, C58.2, C59.2, C60.2, D10.1 (K), J1.3, J1.5, J1.9, J11.1, R13.2, R90.2, R91.2, R92.2, R93.2, R94.2, R95.2, R96.2, R97.2, R98.2, R99.2, R100.2, R101.2, R102.2, R103.2, U2.4 (GND), U2.9 (EP); also elsewhere on the board
JTAG_MOD: R13.1, U1.U6 (GPIO_LPSR_13/JTAG_MUX_MOD/GPIO12_IO13)
LCD_RST_B: U1.R13 (GPIO_AD_02/EMVSIM1_RST/GPIO9_IO01); also elsewhere on the board
LCD_TE: U1.P13 (GPIO_AD_05/EMVSIM1_POWER_FAIL/GPIO9_IO04); also elsewhere on the board
LCM_PWR_EN: U1.A4 (GPIO_DISP_B2_15/VIDEO_MUX_LCDIF_DATA2/G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); also elsewhere on the board
LPI2C5_SCL: U1.N8 (GPIO_LPSR_05/LPI2C5_SCL/GPIO12_IO05); also elsewhere on the board
LPI2C5_SDA: U1.N7 (GPIO_LPSR_04/LPI2C5_SDA/GPIO12_IO04); also elsewhere on the board
LPSPI3_SOUT: R92.1, U1.D10 (GPIO_DISP_B1_06/VIDEO_MUX_LCDIF_DATA0/G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)
LPUART1_RXD: J11.3, U1.M15 (GPIO_AD_25/LPUART1_RXD/GPIO9_IO24)
LPUART1_TXD: J11.2, U1.L13 (GPIO_AD_24/LPUART1_TXD/GPIO9_IO23)
M2_SDIO_CLK: U1.D15 (GPIO_SD_B1_01/USDHC1_CLK/GPIO10_IO04); also elsewhere on the board
M2_SDIO_CMD: U1.B16 (GPIO_SD_B1_00/USDHC1_CMD/GPIO10_IO03); also elsewhere on the board
M2_SDIO_D0: U1.C15 (GPIO_SD_B1_02/USDHC1_DATA0/GPIO10_IO05); also elsewhere on the board
M2_SDIO_D1: U1.B17 (GPIO_SD_B1_03/USDHC1_DATA1/GPIO10_IO06); also elsewhere on the board
M2_SDIO_D2: U1.B15 (GPIO_SD_B1_04/USDHC1_DATA2/GPIO10_IO07); also elsewhere on the board
M2_SDIO_D3: U1.A16 (GPIO_SD_B1_05/USDHC1_DATA3/GPIO10_IO08); also elsewhere on the board
NVCC_SD2: C36.1, C58.1, C59.1, C60.1, FB6.2, R14.1, U1.G13 (NVCC_SD2), U2.8 (VCC); also elsewhere on the board
unnamed: D1.1 (K), J1.10
unnamed: R11.1, SW4.4
unnamed: R12.1, SW4.3
POR_B: D1.2 (A); also elsewhere on the board
SAI1_MCLK: U1.N15 (GPIO_AD_17/SAI1_MCLK/GPIO9_IO16); also elsewhere on the board
SAI1_RXD0: U1.K13 (GPIO_AD_20/SAI1_RX_DATA0/GPIO9_IO19); also elsewhere on the board
SAI1_RX_BCLK: U1.L16 (GPIO_AD_19/SAI1_RX_BCLK/GPIO9_IO18); also elsewhere on the board
SAI1_RX_SYNC: U1.M16 (GPIO_AD_18/SAI1_RX_SYNC/GPIO9_IO17); also elsewhere on the board
SAI1_TXD0: U1.K14 (GPIO_AD_21/SAI1_TX_DATA0/GPIO9_IO20); also elsewhere on the board
SAI1_TX_BCLK: U1.K12 (GPIO_AD_22/SAI1_TX_BCLK/GPIO9_IO21); also elsewhere on the board
SAI1_TX_SYNC: U1.J12 (GPIO_AD_23/SAI1_TX_SYNC/GPIO9_IO22); also elsewhere on the board
SD_CD_B: U1.J16 (GPIO_AD_34/GPIO10_IO01); also elsewhere on the board
SD_CLK: U1.F14 (GPIO_SD_B2_04/USDHC2_CLK/GPIO10_IO13); also elsewhere on the board
SD_CMD: U1.E14 (GPIO_SD_B2_05/USDHC2_CMD/GPIO10_IO14); also elsewhere on the board
SD_DAT0: U1.E15 (GPIO_SD_B2_03/USDHC2_DATA0/GPIO10_IO12); also elsewhere on the board
SD_DAT1: U1.H13 (GPIO_SD_B2_02/USDHC2_DATA1/GPIO10_IO11); also elsewhere on the board
SD_DAT2: U1.J14 (GPIO_SD_B2_01/USDHC2_DATA2/GPIO10_IO10); also elsewhere on the board
SD_DAT3: U1.J15 (GPIO_SD_B2_00/USDHC2_DATA3/GPIO10_IO09); also elsewhere on the board
SD_PWREN_B: U1.G17 (GPIO_AD_35/ENET_1G_1588_EVENT0_O/GPIO10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); also elsewhere on the board
SEMC_A0: U1.A3 (GPIO_EMC_B1_09/SEMC_ADDR00/GPIO7_IO09); also elsewhere on the board
SEMC_A1: U1.A2 (GPIO_EMC_B1_10/SEMC_ADDR01/GPIO7_IO10); also elsewhere on the board
SEMC_A2: U1.C2 (GPIO_EMC_B1_11/SEMC_ADDR02/GPIO7_IO11); also elsewhere on the board
SEMC_A3: U1.C5 (GPIO_EMC_B1_12/SEMC_ADDR03/GPIO7_IO12); also elsewhere on the board
SEMC_A4: U1.D5 (GPIO_EMC_B1_13/SEMC_ADDR04/GPIO7_IO13); also elsewhere on the board
SEMC_A5: U1.B1 (GPIO_EMC_B1_14/SEMC_ADDR05/GPIO7_IO14); also elsewhere on the board
SEMC_A6: U1.C1 (GPIO_EMC_B1_15/SEMC_ADDR06/GPIO7_IO15); also elsewhere on the board
SEMC_A7: U1.D3 (GPIO_EMC_B1_16/SEMC_ADDR07/GPIO7_IO16); also elsewhere on the board
SEMC_A8: U1.B3 (GPIO_EMC_B1_17/SEMC_ADDR08/GPIO7_IO17); also elsewhere on the board
SEMC_A9: U1.B4 (GPIO_EMC_B1_18/SEMC_ADDR09/GPIO7_IO18); also elsewhere on the board
SEMC_A10: U1.B2 (GPIO_EMC_B1_23/SEMC_ADDR10/GPIO7_IO23); also elsewhere on the board
SEMC_A11: U1.C4 (GPIO_EMC_B1_19/SEMC_ADDR11/GPIO7_IO19); also elsewhere on the board
SEMC_A12: U1.C3 (GPIO_EMC_B1_20/SEMC_ADDR12/GPIO7_IO20); also elsewhere on the board
SEMC_BA0: U1.G2 (GPIO_EMC_B1_21/SEMC_BA0/GPIO7_IO21); also elsewhere on the board
SEMC_BA1: U1.H2 (GPIO_EMC_B1_22/SEMC_BA1/GPIO7_IO22); also elsewhere on the board
SEMC_CAS: U1.J5 (GPIO_EMC_B1_24/SEMC_CAS/GPIO7_IO24); also elsewhere on the board
SEMC_CKE: U1.G5 (GPIO_EMC_B1_27/SEMC_CKE/GPIO7_IO27); also elsewhere on the board
SEMC_CLK: U1.J3 (GPIO_EMC_B1_26/SEMC_CLK/GPIO7_IO26); also elsewhere on the board
SEMC_CS0: U1.E6 (GPIO_EMC_B1_29/SEMC_CS0/GPIO7_IO29); also elsewhere on the board
SEMC_D0: U1.F3 (GPIO_EMC_B1_00/SEMC_DATA00/GPIO7_IO00); also elsewhere on the board
SEMC_D1: U1.F2 (GPIO_EMC_B1_01/SEMC_DATA01/GPIO7_IO01); also elsewhere on the board
SEMC_D2: U1.G4 (GPIO_EMC_B1_02/SEMC_DATA02/GPIO7_IO02); also elsewhere on the board
SEMC_D3: U1.E4 (GPIO_EMC_B1_03/SEMC_DATA03/GPIO7_IO03); also elsewhere on the board
SEMC_D4: U1.H5 (GPIO_EMC_B1_04/SEMC_DATA04/GPIO7_IO04); also elsewhere on the board
SEMC_D5: U1.F4 (GPIO_EMC_B1_05/SEMC_DATA05/GPIO7_IO05); also elsewhere on the board
SEMC_D6: U1.H4 (GPIO_EMC_B1_06/SEMC_DATA06/GPIO7_IO06); also elsewhere on the board
SEMC_D7: U1.H3 (GPIO_EMC_B1_07/SEMC_DATA07/GPIO7_IO07); also elsewhere on the board
SEMC_D8: U1.E3 (GPIO_EMC_B1_30/SEMC_DATA08/GPIO7_IO30); also elsewhere on the board
SEMC_D9: U1.D2 (GPIO_EMC_B1_31/SEMC_DATA09/GPIO7_IO31); also elsewhere on the board
SEMC_D10: U1.D1 (GPIO_EMC_B1_32/SEMC_DATA10/GPIO8_IO00); also elsewhere on the board
SEMC_D11: U1.E2 (GPIO_EMC_B1_33/SEMC_DATA11/GPIO8_IO01); also elsewhere on the board
SEMC_D12: U1.E1 (GPIO_EMC_B1_34/SEMC_DATA12/GPIO8_IO02); also elsewhere on the board
SEMC_D13: U1.F1 (GPIO_EMC_B1_35/SEMC_DATA13/GPIO8_IO03); also elsewhere on the board
SEMC_D14: U1.G1 (GPIO_EMC_B1_36/SEMC_DATA14/GPIO8_IO04); also elsewhere on the board
SEMC_D15: U1.H1 (GPIO_EMC_B1_37/SEMC_DATA15/GPIO8_IO05); also elsewhere on the board
SEMC_D16: U1.K2 (GPIO_EMC_B2_00/SEMC_DATA16/GPIO8_IO10); also elsewhere on the board
SEMC_D17: U1.K4 (GPIO_EMC_B2_01/SEMC_DATA17/GPIO8_IO11); also elsewhere on the board
SEMC_D18: U1.K3 (GPIO_EMC_B2_02/SEMC_DATA18/GPIO8_IO12); also elsewhere on the board
SEMC_D19: U1.R1 (GPIO_EMC_B2_03/SEMC_DATA19/GPIO8_IO13); also elsewhere on the board
SEMC_D20: U1.M1 (GPIO_EMC_B2_04/SEMC_DATA20/GPIO8_IO14); also elsewhere on the board
SEMC_D21: U1.N1 (GPIO_EMC_B2_05/SEMC_DATA21/GPIO8_IO15); also elsewhere on the board
SEMC_D22: U1.T1 (GPIO_EMC_B2_06/SEMC_DATA22/GPIO8_IO16); also elsewhere on the board
SEMC_D23: U1.M3 (GPIO_EMC_B2_07/SEMC_DATA23/GPIO8_IO17); also elsewhere on the board
SEMC_D24: U1.N2 (GPIO_EMC_B2_09/SEMC_DATA24/GPIO8_IO19); also elsewhere on the board
SEMC_D25: U1.R2 (GPIO_EMC_B2_10/SEMC_DATA25/GPIO8_IO20); also elsewhere on the board
SEMC_D26: U1.L4 (GPIO_EMC_B2_11/SEMC_DATA26/GPIO8_IO21); also elsewhere on the board
SEMC_D27: U1.M2 (GPIO_EMC_B2_12/SEMC_DATA27/GPIO8_IO22); also elsewhere on the board
SEMC_D28: U1.K5 (GPIO_EMC_B2_13/SEMC_DATA28/GPIO8_IO23); also elsewhere on the board
SEMC_D29: U1.M4 (GPIO_EMC_B2_14/SEMC_DATA29/GPIO8_IO24); also elsewhere on the board
SEMC_D30: U1.L2 (GPIO_EMC_B2_15/SEMC_DATA30/GPIO8_IO25); also elsewhere on the board
SEMC_D31: U1.P2 (GPIO_EMC_B2_16/SEMC_DATA31/GPIO8_IO26); also elsewhere on the board
SEMC_DM0: U1.F5 (GPIO_EMC_B1_08/SEMC_DM0/GPIO7_IO08); also elsewhere on the board
SEMC_DM1: U1.J1 (GPIO_EMC_B1_38/SEMC_DM1/GPIO8_IO06); also elsewhere on the board
SEMC_DM2: U1.P1 (GPIO_EMC_B2_08/SEMC_DM2/GPIO8_IO18); also elsewhere on the board
SEMC_DM3: U1.T2 (GPIO_EMC_B2_17/SEMC_DM3/GPIO8_IO27); also elsewhere on the board
SEMC_DQS: U1.J2 (GPIO_EMC_B1_39/SEMC_DQS/GPIO8_IO07); also elsewhere on the board
SEMC_RAS: U1.J4 (GPIO_EMC_B1_25/SEMC_RAS/GPIO7_IO25); also elsewhere on the board
SEMC_WE: U1.E5 (GPIO_EMC_B1_28/SEMC_WE/GPIO7_IO28); also elsewhere on the board
SWCLK: J1.4, U1.T6 (GPIO_LPSR_14/GPIO12_IO14)
SWDIO: J1.2, U1.U7 (GPIO_LPSR_15/GPIO12_IO15)
SWO: J1.6, U1.T5 (GPIO_LPSR_11/JTAG_MUX_TDO/GPIO12_IO11)
TDI: J1.8, U1.U5 (GPIO_LPSR_12/JTAG_MUX_TDI/GPIO12_IO12)
USB_OTG2_ID: U1.R15 (GPIO_AD_08/USB_OTG2_ID/GPIO9_IO07); also elsewhere on the board
USB_OTG2_OC: U1.N13 (GPIO_AD_06/GPIO9_IO05); also elsewhere on the board
USER_LED: R89.1, U1.M13 (GPIO_AD_04/EMVSIM1_PD/GPIO9_IO03)
USER_LED_A: D10.2 (A), R89.2
WIFI_RST_B: U1.N17 (GPIO_AD_16/SPDIF_OUT/GPIO9_IO15); also elsewhere on the board
WIFI_WAKE_B: U1.M17 (GPIO_AD_29/LPSPI1_PCS0/GPIO9_IO28); also elsewhere on the board
WL_DEV_WAKE: U1.T17 (GPIO_AD_07/USB_OTG2_PWR/GPIO9_IO06); also elsewhere on the board
WL_RST_B: U1.J17 (GPIO_AD_31/LPSPI1_SIN/GPIO9_IO30); also elsewhere on the board

Notes on the sheet:
DISP1
TRST (GPIO_LPSR_10) is not on the 10-pin header; left on its internal pull-up (RM: weak PU, enabled).
J1: ARM Cortex 10-pin (2x5, 1.27mm). SWDIO=GPIO_LPSR_15 (U7), SWCLK=LPSR_14 (T6),
SWD / JTAG (Cortex 10-pin)
EMC1
NVCC_SD2 = +3V3
LPUART1 = SDK debug console (GPIO_AD_24/25)
FlexSPI1 NOR flash (QSPI)
nRESET -> POR_B via D1 (EVKB D2 RB521S30): the board reset cannot back-drive the probe.
SD1
BOOT STRAPS (100k pull-downs; these pads have no pull at reset)
I/O rail decoupling (NVCC_*) per MIMXRT1170-EVKB RevC3 sheets 7-8, one group per bank.
NVCC_GPIO/EMC/LPSR/DISP1/DISP2 = 3.3V (EVKB DISP1 = 1.8V for RGMII), NVCC_SD1 = 1.8V (M.2), NVCC_SD2 = 3.3V.
PWR_FLAG
SD2
100k pull-downs R90/R91 (EVKB R34/R35) give 00 with switches off; series 4.7k = EVKB R347/R348. BT_CFG DIP (EVKB SW2) omitted:
Direct GPIO drive: 1k series + red 0603 (the M.2 LED part), ~1.3 mA. The EVKB buffers this pin with a BC817 (D6/Q521/R216) - not needed here.
DISP2
internal boot from FlexSPI1 QuadSPI NOR. EVKB uses 47k + DIP SW2. BT_CFG0 is also LPSPI3_SOUT.
USER LED (GPIO_AD_04 = SDK BOARD_USER_LED; GPIO high = LED on)
BT_CFG0-11 = BOOT_CFG1[7:0], BOOT_CFG2[3:0] on GPIO_DISP_B1_06..11 / B2_00..05, all 0:
Boot mode (GPIO_LPSR_03:02), DIP ON = 1: 00 fuses, 01 serial downloader, 10 internal boot, 11 reserved.
GPIO
Bank rails are tied straight to +3V3 (NVCC_SD1 to +1V8): the per-bank NVCC nets are merged into the rails.
EVKB 0R option links (R380/R399/R386/R390/R392/R385) and the octal-flash option (U21) are omitted.
WP/HOLD are IO2/IO3 in quad mode (EVKB pull-ups R176/R171 DNP). NVCC_SD2 bank runs at 3.3V (shared with the microSD on uSDHC2): FB6 + 10uF from +3V3.
BOOT_MODE[1:0]
1 GND, 2 TXD (board out, to adapter RX), 3 RXD (board in, from adapter TX)
LPSR
DEBUG UART J11 (0.1 in 1x3, 3.3 V)
EMC2
JTAG_MOD
BT_CFG pins pulled down by R92-R103, so internal boot = FlexSPI1 serial NOR.
U2: W25Q512JVEIQ 512Mb 3.3V QSPI (EVKB U23 is the 1.8V NW part) on FlexSPI1 port A, GPIO_SD_B2_06..11. CS pull-up 10k (EVKB R165).
BOOT_MODE0/1 (GPIO_LPSR_02/03): R90/R91 = EVKB R34/R35; DIP ON pulls up via R12/R11.
SWO/TDO=LPSR_11 (T5), TDI=LPSR_12 (U5). VTref = NVCC_LPSR. JTAG_MOD 10k pull-down (EVKB R403).

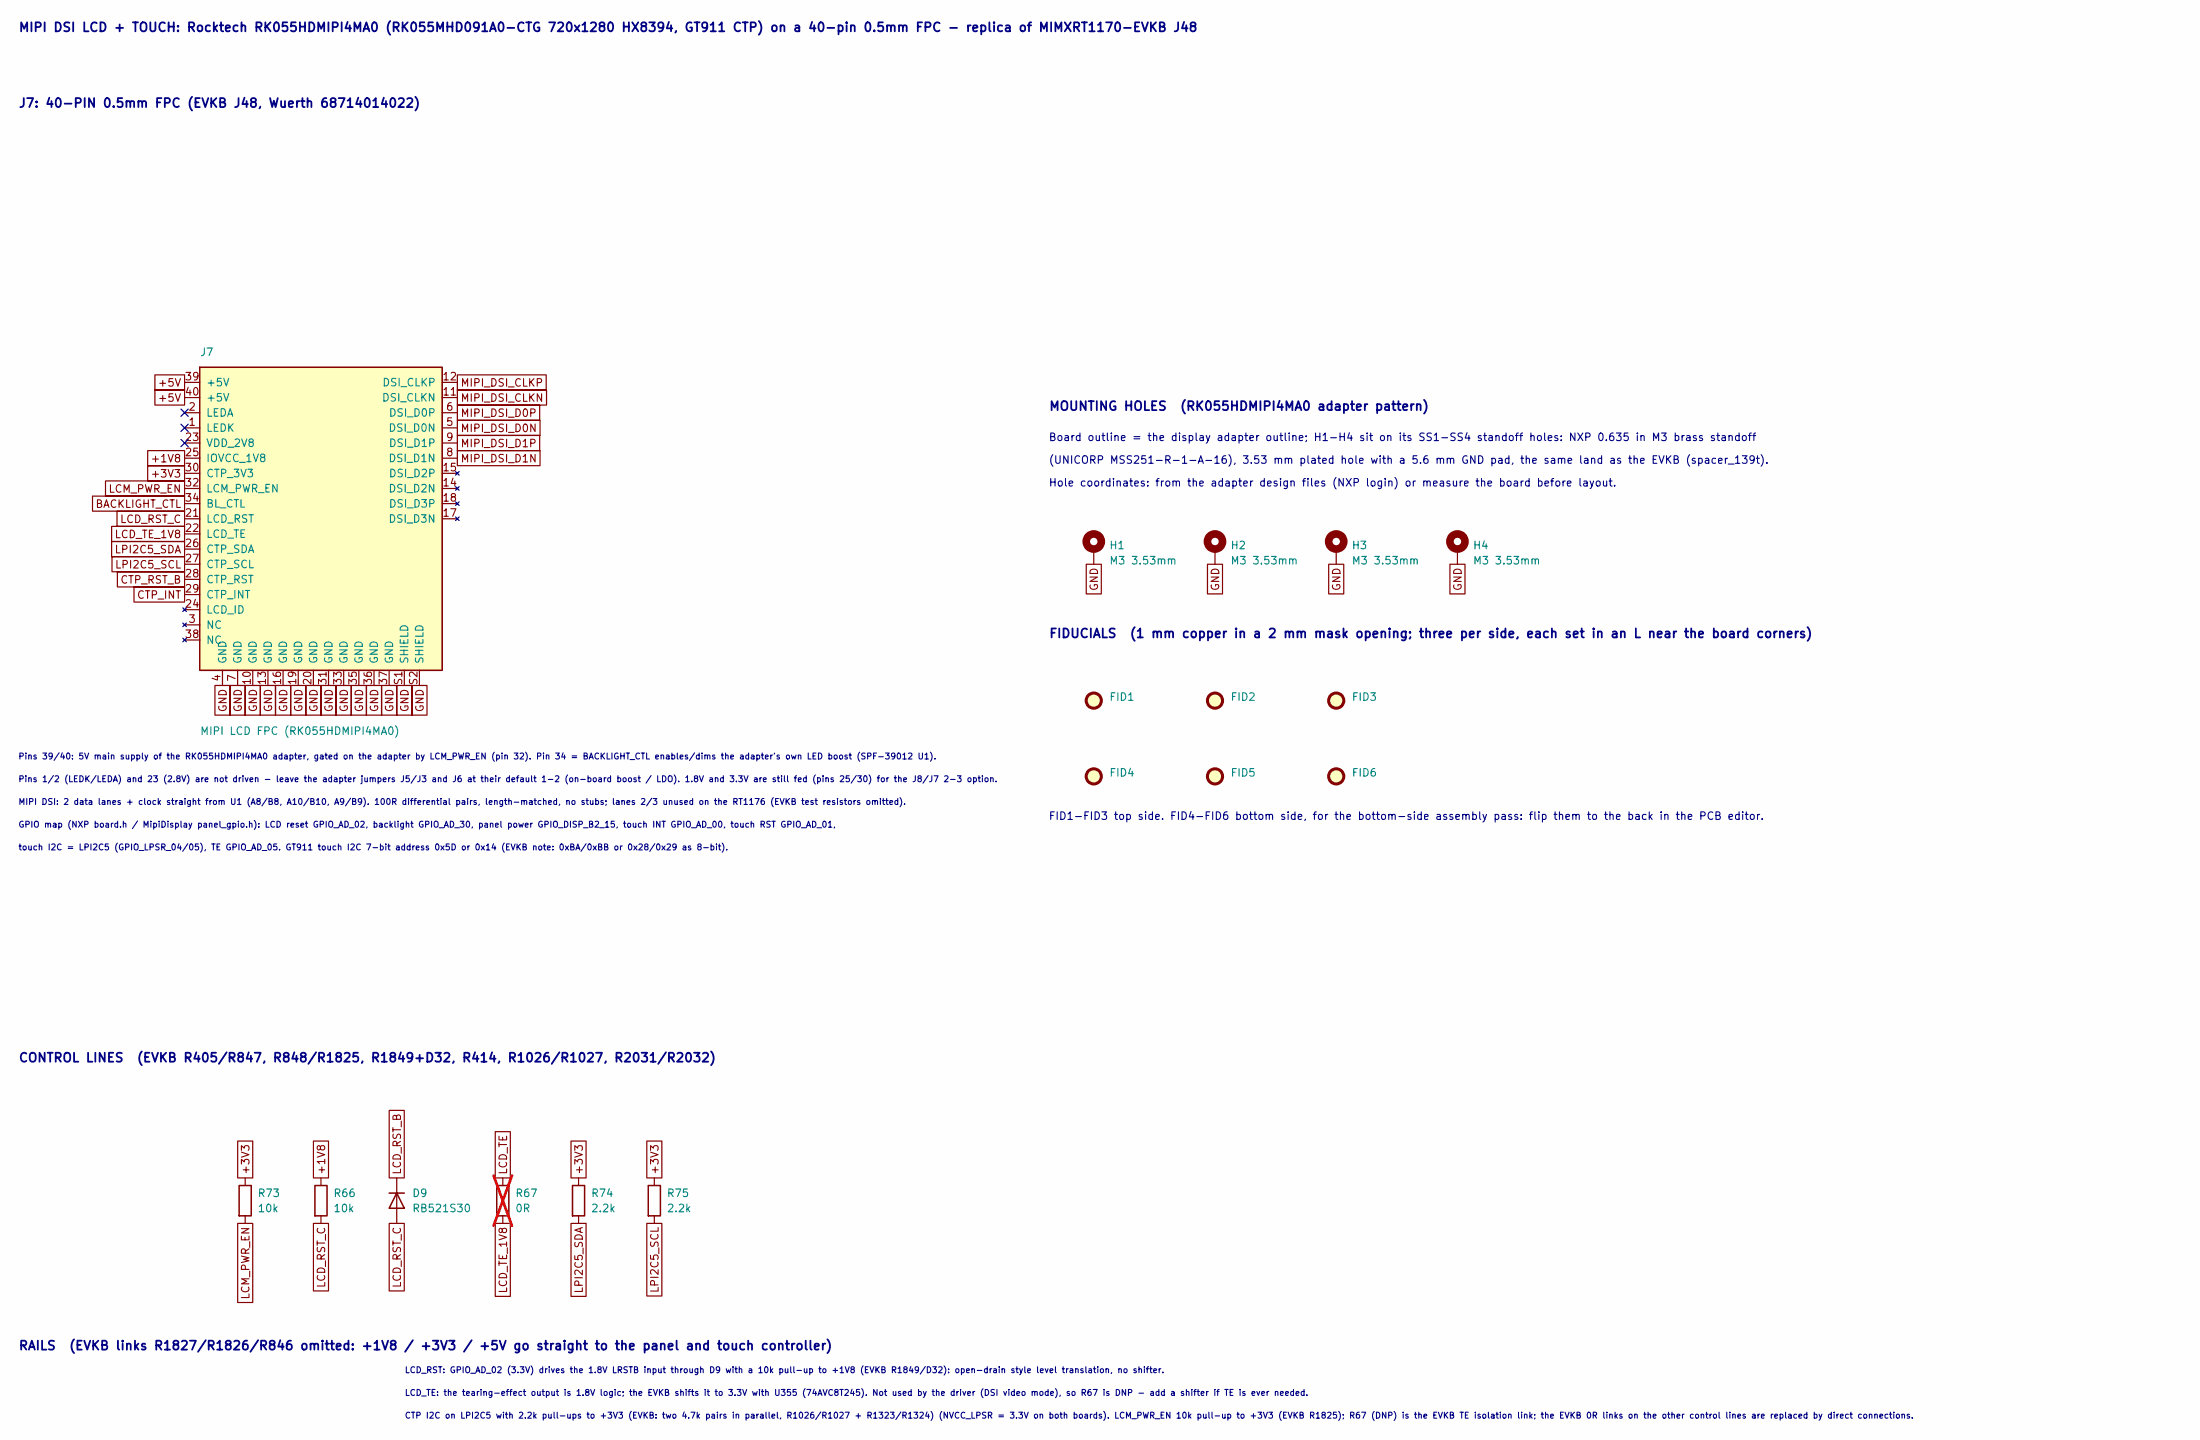
[picture p15: schematic lcd.kicad_sch]

Parts:
D9: RB521S30; D_SOD-523; MPN RB521S30T1G; LCSC C145179
FID1, FID2, FID3, FID4, FID5, FID6: Fiducial; Fiducial_1mm_Mask2mm
H1, H2, H3, H4: M3 3.53mm; MountingHole_3.53mm_M3_Pad
J7: MIPI LCD FPC (RK055HDMIPI4MA0); FPC40_0p5_Wuerth_68714014022; MPN 68714014022; LCSC C6264899
R66, R73: 10k; R_0402_1005Metric_JLC; MPN 0402WGF1002TCE; LCSC C25744
R67: 0R; R_0402_1005Metric_JLC; MPN 0402WGF0000TCE; LCSC C17168; not fitted
R74, R75: 2.2k; R_0402_1005Metric_JLC; MPN 0402WGF2201TCE; LCSC C25879

Connections:
+1V8: J7.25 (IOVCC_1V8), R66.1; also elsewhere on the board
+3V3: J7.30 (CTP_3V3), R73.1, R74.1, R75.1; also elsewhere on the board
+5V: J7.39 (+5V), J7.40 (+5V); also elsewhere on the board
BACKLIGHT_CTL: J7.34 (BL_CTL); also elsewhere on the board
CTP_INT: J7.29 (CTP_INT); also elsewhere on the board
CTP_RST_B: J7.28 (CTP_RST); also elsewhere on the board
GND: H1.1, H2.1, H3.1, H4.1, J7.4 (GND), J7.7 (GND), J7.10 (GND), J7.13 (GND), J7.16 (GND), J7.19 (GND), J7.20 (GND), J7.31 (GND), J7.33 (GND), J7.35 (GND), J7.36 (GND), J7.37 (GND), J7.S1 (SHIELD), J7.S2 (SHIELD); also elsewhere on the board
LCD_RST_B: D9.1 (K); also elsewhere on the board
LCD_RST_C: D9.2 (A), J7.21 (LCD_RST), R66.2
LCD_TE: R67.1; also elsewhere on the board
LCD_TE_1V8: J7.22 (LCD_TE), R67.2
LCM_PWR_EN: J7.32 (LCM_PWR_EN), R73.2; also elsewhere on the board
LPI2C5_SCL: J7.27 (CTP_SCL), R75.2; also elsewhere on the board
LPI2C5_SDA: J7.26 (CTP_SDA), R74.2; also elsewhere on the board
MIPI_DSI_CLKN: J7.11 (DSI_CLKN); also elsewhere on the board
MIPI_DSI_CLKP: J7.12 (DSI_CLKP); also elsewhere on the board
MIPI_DSI_D0N: J7.5 (DSI_D0N); also elsewhere on the board
MIPI_DSI_D0P: J7.6 (DSI_D0P); also elsewhere on the board
MIPI_DSI_D1N: J7.8 (DSI_D1N); also elsewhere on the board
MIPI_DSI_D1P: J7.9 (DSI_D1P); also elsewhere on the board

Notes on the sheet:
J7: 40-PIN 0.5mm FPC (EVKB J48, Wuerth 68714014022)
MIPI DSI LCD + TOUCH: Rocktech RK055HDMIPI4MA0 (RK055MHD091A0-CTG 720x1280 HX8394, GT911 CTP) on a 40-pin 0.5mm FPC - replica of MIMXRT1170-EVKB J48
MIPI DSI: 2 data lanes + clock straight from U1 (A8/B8, A10/B10, A9/B9). 100R differential pairs, length-matched, no stubs; lanes 2/3 unused on the RT1176 (EVKB test resistors omitted).
touch I2C = LPI2C5 (GPIO_LPSR_04/05), TE GPIO_AD_05. GT911 touch I2C 7-bit address 0x5D or 0x14 (EVKB note: 0xBA/0xBB or 0x28/0x29 as 8-bit).
LCD_TE: the tearing-effect output is 1.8V logic; the EVKB shifts it to 3.3V with U355 (74AVC8T245). Not used by the driver (DSI video mode), so R67 is DNP - add a shifter if TE is ever needed.
CTP I2C on LPI2C5 with 2.2k pull-ups to +3V3 (EVKB: two 4.7k pairs in parallel, R1026/R1027 + R1323/R1324) (NVCC_LPSR = 3.3V on both boards). LCM_PWR_EN 10k pull-up to +3V3 (EVKB R1825); R67 (DNP) is the EVKB TE isolation link; the EVKB 0R links on the other control lines are replaced by direct con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
(UNICORP MSS251-R-1-A-16), 3.53 mm plated hole with a 5.6 mm GND pad, the same land as the EVKB (spacer_139t).
CONTROL LINES (EVKB R405/R847, R848/R1825, R1849+D32, R414, R1026/R1027, R2031/R2032)
Hole coordinates: from the adapter design files (NXP login) or measure the board before layout.
RAILS (EVKB links R1827/R1826/R846 omitted: +1V8 / +3V3 / +5V go straight to the panel and touch controller)
FIDUCIALS (1 mm copper in a 2 mm mask opening; three per side, each set in an L near the board corners)
LCD_RST: GPIO_AD_02 (3.3V) drives the 1.8V LRSTB input through D9 with a 10k pull-up to +1V8 (EVKB R1849/D32): open-drain style level translation, no shifter.
MOUNTING HOLES (RK055HDMIPI4MA0 adapter pattern)
Pins 1/2 (LEDK/LEDA) and 23 (2.8V) are not driven - leave the adapter jumpers J5/J3 and J6 at their default 1-2 (on-board boost / LDO). 1.8V and 3.3V are still fed (pins 25/30) for the J8/J7 2-3 option.
FID1-FID3 top side. FID4-FID6 bottom side, for the bottom-side assembly pass: flip them to the back in the PCB editor.
Board outline = the display adapter outline; H1-H4 sit on its SS1-SS4 standoff holes: NXP 0.635 in M3 brass standoff
GPIO map (NXP board.h / MipiDisplay panel_gpio.h): LCD reset GPIO_AD_02, backlight GPIO_AD_30, panel power GPIO_DISP_B2_15, touch INT GPIO_AD_00, touch RST GPIO_AD_01,
Pins 39/40: 5V main supply of the RK055HDMIPI4MA0 adapter, gated on the adapter by LCM_PWR_EN (pin 32). Pin 34 = BACKLIGHT_CTL enables/dims the adapter's own LED boost (SPF-39012 U1).

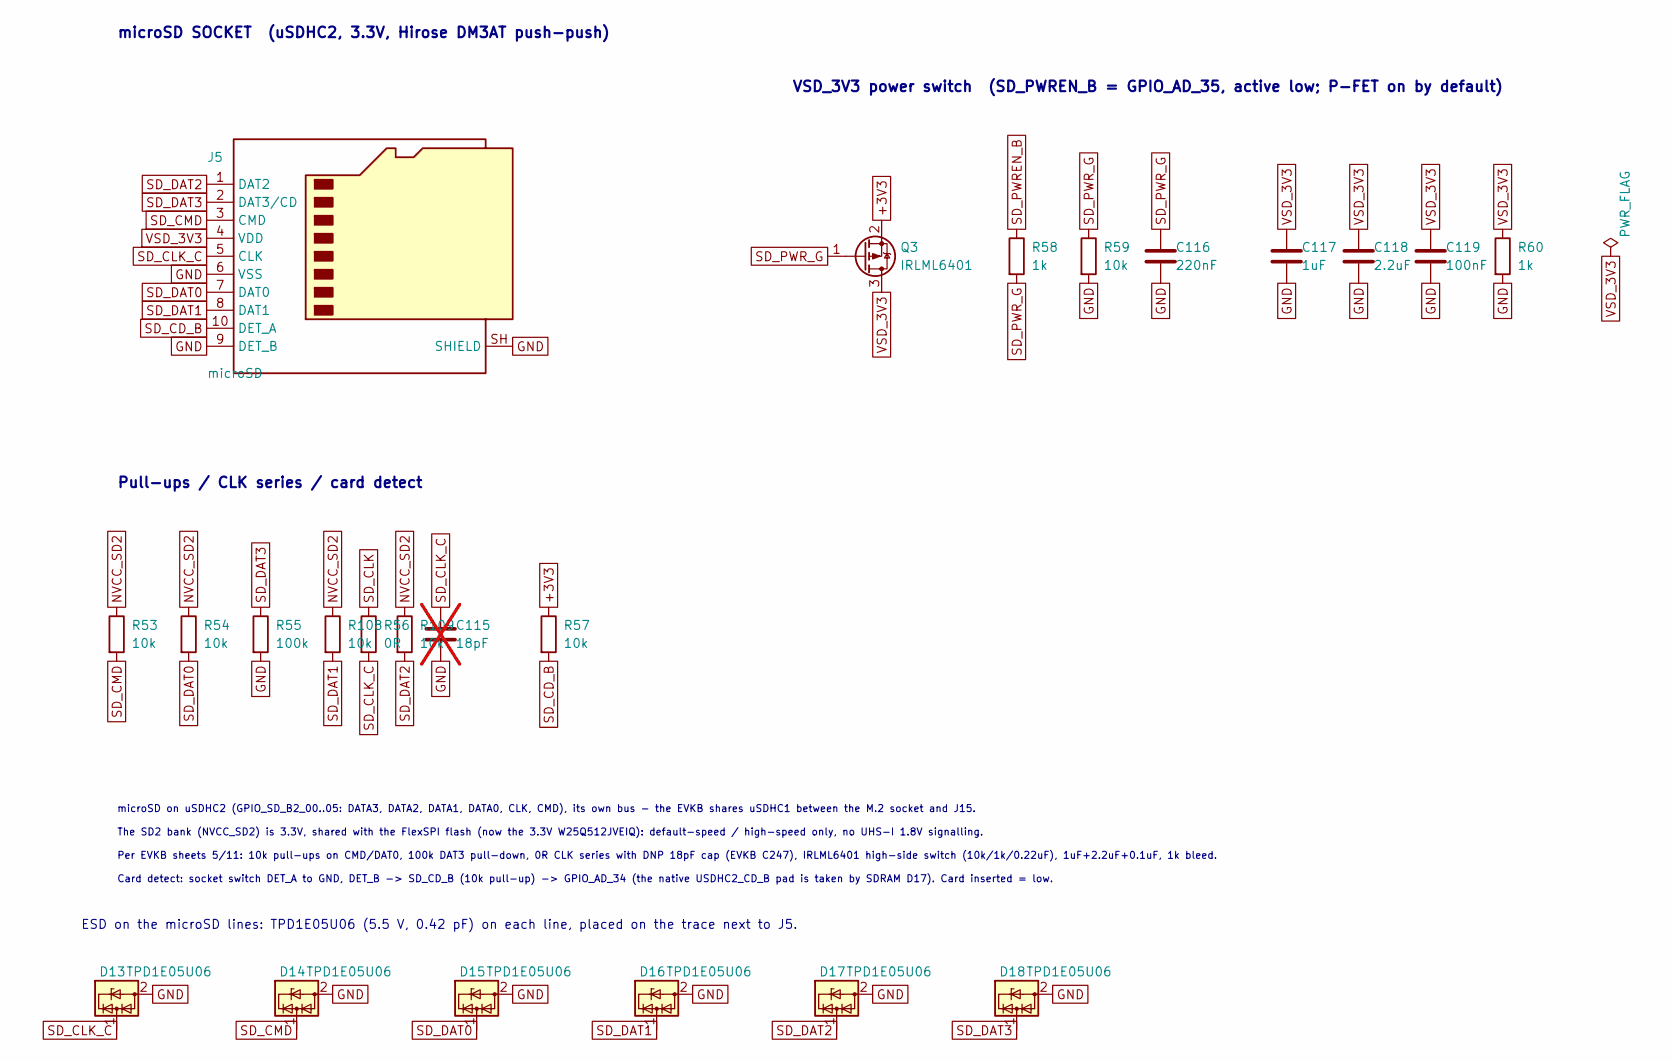
[picture p16: schematic sdcard.kicad_sch]

Parts:
C115: 18pF; C_0402_1005Metric_JLC; MPN 0402CG180J500NT; LCSC C1549; not fitted
C116: 220nF; C_0402_1005Metric_JLC; MPN CL05B224KO5NNNC; LCSC C16772
C117: 1uF; C_0402_1005Metric_JLC; MPN CL05A105KA5NQNC; LCSC C52923
C118: 2.2uF; C_0402_1005Metric_JLC; MPN CL05A225MQ5NSNC; LCSC C12530
C119: 100nF; C_0402_1005Metric_JLC; MPN CL05B104KO5NNNC; LCSC C1525
D13, D14, D15, D16, D17, D18: TPD1E05U06; ESD_X1SON-2_0.6x1mm_JLC; MPN TPD1E05U06DPYR; LCSC C436349
J5: microSD; microSD_HC_Hirose_DM3AT-SF-PEJM5_JLC; MPN DM3AT-SF-PEJM5; LCSC C114218
Q3: IRLML6401; SOT-23; MPN IRLML6401TRPBF; LCSC C3034
R53, R54, R57, R59, R108, R109: 10k; R_0402_1005Metric_JLC; MPN 0402WGF1002TCE; LCSC C25744
R55: 100k; R_0402_1005Metric_JLC; MPN 0402WGF1003TCE; LCSC C25741
R56: 0R; R_0402_1005Metric_JLC; MPN 0402WGF0000TCE; LCSC C17168
R58, R60: 1k; R_0402_1005Metric_JLC; MPN 0402WGF1001TCE; LCSC C11702

Connections:
+3V3: Q3.2 (S), R57.1; also elsewhere on the board
GND: C115.2, C116.2, C117.2, C118.2, C119.2, D13.2 (GND), D14.2 (GND), D15.2 (GND), D16.2 (GND), D17.2 (GND), D18.2 (GND), J5.6 (VSS), J5.9 (DET_B), J5.SH (SHIELD), R55.2, R59.2, R60.2; also elsewhere on the board
NVCC_SD2: R53.1, R54.1, R108.1, R109.1; also elsewhere on the board
SD_CD_B: J5.10 (DET_A), R57.2; also elsewhere on the board
SD_CLK: R56.1; also elsewhere on the board
SD_CLK_C: C115.1, D13.1 (I/O), J5.5 (CLK), R56.2
SD_CMD: D14.1 (I/O), J5.3 (CMD), R53.2; also elsewhere on the board
SD_DAT0: D15.1 (I/O), J5.7 (DAT0), R54.2; also elsewhere on the board
SD_DAT1: D16.1 (I/O), J5.8 (DAT1), R108.2; also elsewhere on the board
SD_DAT2: D17.1 (I/O), J5.1 (DAT2), R109.2; also elsewhere on the board
SD_DAT3: D18.1 (I/O), J5.2 (DAT3/CD), R55.1; also elsewhere on the board
SD_PWREN_B: R58.1; also elsewhere on the board
SD_PWR_G: C116.1, Q3.1 (G), R58.2, R59.1
VSD_3V3: C117.1, C118.1, C119.1, J5.4 (VDD), Q3.3 (D), R60.1

Notes on the sheet:
The SD2 bank (NVCC_SD2) is 3.3V, shared with the FlexSPI flash (now the 3.3V W25Q512JVEIQ): default-speed / high-speed only, no UHS-I 1.8V signalling.
VSD_3V3 power switch (SD_PWREN_B = GPIO_AD_35, active low; P-FET on by default)
microSD on uSDHC2 (GPIO_SD_B2_00..05: DATA3, DATA2, DATA1, DATA0, CLK, CMD), its own bus - the EVKB shares uSDHC1 between the M.2 socket and J15.
Per EVKB sheets 5/11: 10k pull-ups on CMD/DAT0, 100k DAT3 pull-down, 0R CLK series with DNP 18pF cap (EVKB C247), IRLML6401 high-side switch (10k/1k/0.22uF), 1uF+2.2uF+0.1uF, 1k bleed.
microSD SOCKET (uSDHC2, 3.3V, Hirose DM3AT push-push)
Card detect: socket switch DET_A to GND, DET_B -> SD_CD_B (10k pull-up) -> GPIO_AD_34 (the native USDHC2_CD_B pad is taken by SDRAM D17). Card inserted = low.
Pull-ups / CLK series / card detect
ESD on the microSD lines: TPD1E05U06 (5.5 V, 0.42 pF) on each line, placed on the trace next to J5.
