newdigate/nosh-dev-board/Kicad/Nosh.kicad_pcb

## KiCad design Kicad/Nosh.kicad_pcb (continued)

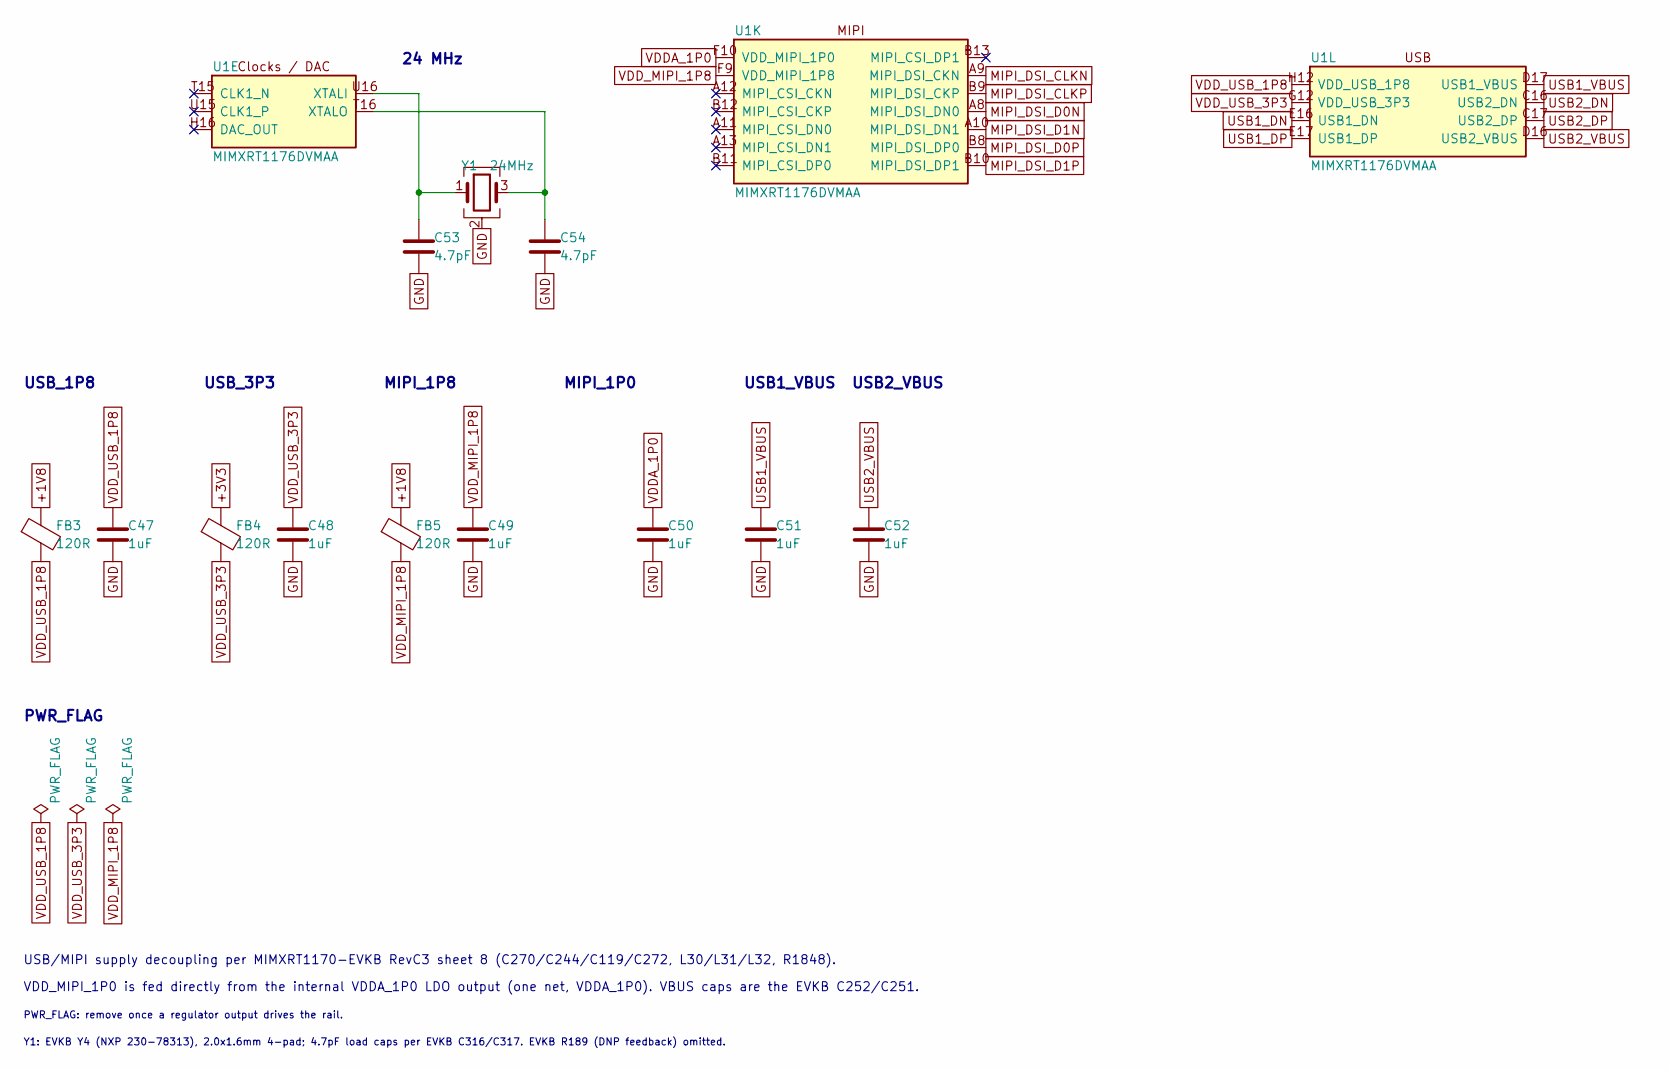
[picture p17: schematic core.kicad_sch]

Parts:
C47, C48, C50: 1uF; C_0402_1005Metric_ViP; MPN CL05A105KA5NQNC; LCSC C52923
C49, C51, C52: 1uF; C_0402_1005Metric_JLC; MPN CL05A105KA5NQNC; LCSC C52923
C53, C54: 4.7pF; C_0402_1005Metric_JLC; MPN CC0402BRNPO9BN4R7; LCSC C325453
FB3, FB4, FB5: 120R; L_0402_1005Metric; MPN BLM15AG121SN1D; LCSC C85812
U1: MIMXRT1176DVMAA; MAPBGA-289_14x14mm_Layout17x17_P0.8mm; MPN MIMXRT1176DVMAA; LCSC C1020237
Y1: 24MHz; Crystal_SMD_2016-4Pin_2.0x1.6mm; MPN XRCGB24M000F2P91R0; LCSC C5250251

Connections:
+1V8: FB3.1, FB5.1; also elsewhere on the board
+3V3: FB4.1; also elsewhere on the board
GND: C47.2, C48.2, C49.2, C50.2, C51.2, C52.2, C53.2, C54.2, Y1.2 (G), Y1.4 (G); also elsewhere on the board
MIPI_DSI_CLKN: U1.A9 (MIPI_DSI_CKN); also elsewhere on the board
MIPI_DSI_CLKP: U1.B9 (MIPI_DSI_CKP); also elsewhere on the board
MIPI_DSI_D0N: U1.A8 (MIPI_DSI_DN0); also elsewhere on the board
MIPI_DSI_D0P: U1.B8 (MIPI_DSI_DP0); also elsewhere on the board
MIPI_DSI_D1N: U1.A10 (MIPI_DSI_DN1); also elsewhere on the board
MIPI_DSI_D1P: U1.B10 (MIPI_DSI_DP1); also elsewhere on the board
unnamed: C53.1, U1.U16 (XTALI), Y1.1
unnamed: C54.1, U1.T16 (XTALO), Y1.3
USB1_DN: U1.E16 (USB1_DN); also elsewhere on the board
USB1_DP: U1.E17 (USB1_DP); also elsewhere on the board
USB1_VBUS: C51.1, U1.D17 (USB1_VBUS); also elsewhere on the board
USB2_DN: U1.C16 (USB2_DN); also elsewhere on the board
USB2_DP: U1.C17 (USB2_DP); also elsewhere on the board
USB2_VBUS: C52.1, U1.D16 (USB2_VBUS); also elsewhere on the board
VDDA_1P0: C50.1, U1.F10 (VDD_MIPI_1P0); also elsewhere on the board
VDD_MIPI_1P8: C49.1, FB5.2, U1.F9 (VDD_MIPI_1P8)
VDD_USB_1P8: C47.1, FB3.2, U1.H12 (VDD_USB_1P8)
VDD_USB_3P3: C48.1, FB4.2, U1.G12 (VDD_USB_3P3)

Notes on the sheet:
USB2_VBUS
VDD_MIPI_1P0 is fed directly from the internal VDDA_1P0 LDO output (one net, VDDA_1P0). VBUS caps are the EVKB C252/C251.
PWR_FLAG
USB/MIPI supply decoupling per MIMXRT1170-EVKB RevC3 sheet 8 (C270/C244/C119/C272, L30/L31/L32, R1848).
PWR_FLAG: remove once a regulator output drives the rail.
MIPI_1P8
Y1: EVKB Y4 (NXP 230-78313), 2.0x1.6mm 4-pad; 4.7pF load caps per EVKB C316/C317. EVKB R189 (DNP feedback) omitted.
USB1_VBUS
USB_1P8
MIPI_1P0
USB_3P3
24 MHz

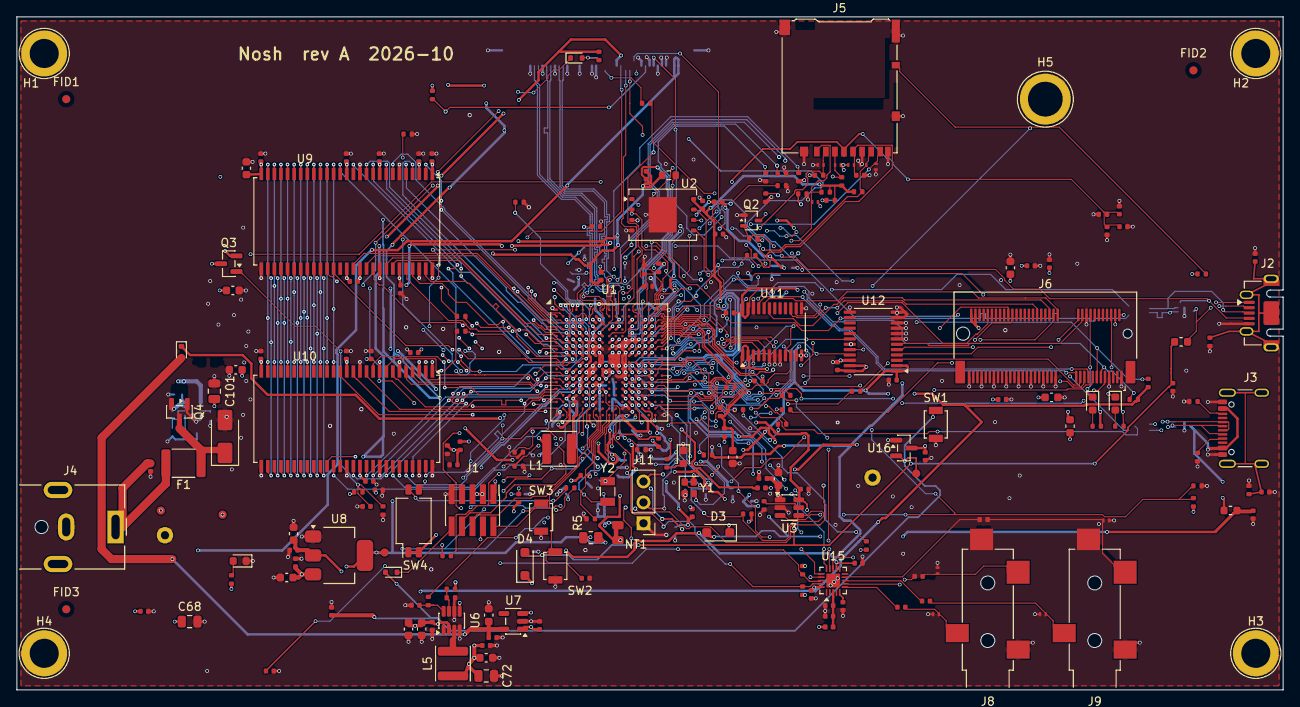
[picture p18: board Nosh.kicad_pcb from above]

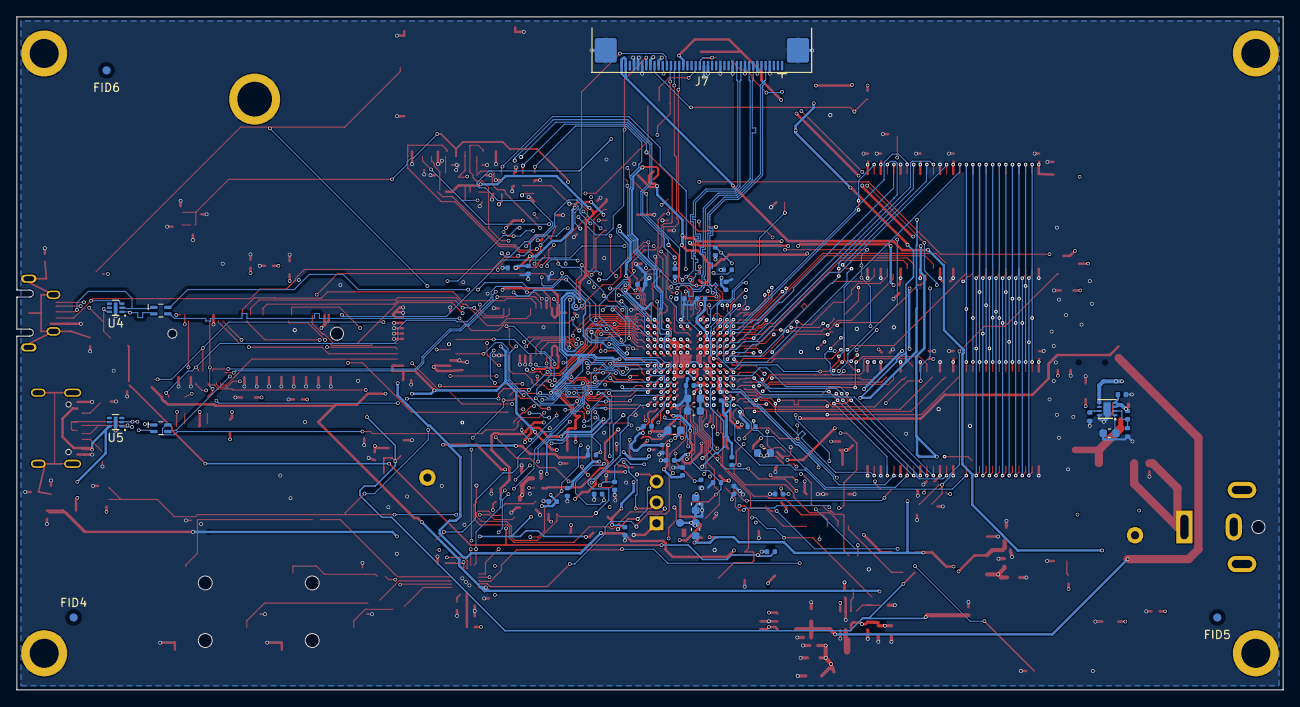
[picture p19: board Nosh.kicad_pcb from below]

Board: 6 copper layers, 153.9 x 81.8 mm, 294 parts (75 on the bottom side), 238 nets.
