newdigate/nosh-dev-board/(commit log)

2026-10-03 inital empty template
    [Nosh.kicad_pcb, Nosh.kicad_sch]
2026-10-03 Add MIMXRT1176DVMAA schematic symbol and BGA-289 footprint
    12-unit symbol following NXP's MIMXRT1170-EVKB unit split, 289 pins with
    ball numbers from the EVKB RevC3 Allegro netlist. Pin names are
    PAD/ALT0/GPIOn_IOxx; all other ALT functions from IMXRT1170RM Table 11-1
    are attached as KiCad alternate pin definitions.
    Kicad/tools/gen_rt1176_symbol.py regenerates the symbol from the checked-in
    data/*.json, and can re-extract that data from the EVKB pstchip.dat and an
    RM text dump. Libraries are registered project-locally as "Nosh".
2026-10-03 Place MIMXRT1176 on hierarchical Power / Core / GPIO sheets
    Root sheet links three sub-sheets holding the 12 units of U1:
    power.kicad_sch SNVS/PMIC, core & analog supplies, DCDC, VSS
    core.kicad_sch clocks/DAC, MIPI, USB
    gpio.kicad_sch EMC, AD, DISP, LPSR, SD (A3)
    No wiring yet; units are spaced out for support circuitry.
    [Nosh.kicad_sch, core.kicad_sch, gpio.kicad_sch, power.kicad_sch]
2026-10-03 Add MCU decoupling caps to Power and GPIO sheets
    Values, counts and packages follow MIMXRT1170-EVKB RevC3 sheets 6-8
    (derived from the Allegro netlist + part list so each cap maps to a rail).
    power.kicad_sch: 33 caps (C1-C33) on VDD_SNVS_*, VDD_LPSR_*, VDDA_*,
    ADC_VREFH, VDD_SOC_IN, DCDC_IN/ANA/DIG; MCU power balls and all 37
    VSS/DCDC_GND balls labelled. 0402 <=4.7uF, 0603 for 10/22uF.
    gpio.kicad_sch: 11 caps (C34-C44), one group per NVCC_* I/O bank, kept as
    per-bank nets for later rail assignment.
    [gpio.kicad_sch, power.kicad_sch]
2026-10-03 Add DCDC inductor and PSWITCH/MODE RC networks to Power sheet
    Per MIMXRT1170-EVKB RevC3 sheet 6: L1 4.7uH between DCDC_LP/LN,
    R1 30k + C45 220nF on DCDC_PSWITCH, R2 4.7k + C46 100nF on DCDC_MODE,
    R3 4.7k DNP pull-up (EVKB R397). Inductor footprint is a 4x4mm stand-in
    (ASPIAIG-F4020) pending part selection.
    All four sheets re-saved via `kicad-cli sch upgrade` to normalise the
    mixed tab/space formatting left by earlier tool edits (whitespace only).
    [Nosh.kicad_sch, core.kicad_sch, gpio.kicad_sch, power.kicad_sch]
2026-10-03 Add VDDA ferrite beads and PWR_FLAGs; mark MCU LDO/DCDC outputs power_out
    Power sheet: FB1 (+3V3 -> VDDA_ADC_3P3) and FB2 (+1V8 -> VDDA_1P8), 120R
    0402 per EVKB L28/L27, plus PWR_FLAGs on the ten passively-fed rails.
    GPIO sheet: PWR_FLAGs on the eight NVCC_* bank nets.
    Symbol: VDD_SNVS_ANA/DIG, VDD_LPSR_ANA/DIG, VDDA_1P0, DCDC_ANA_1 and
    DCDC_DIG_1 are now power_out (internal LDO / DCDC outputs). Generator
    orders pins by a fixed base classification so pin types can change
    without moving pins; verified all 289 positions unchanged. Embedded
    symbol copies in the three sheets synced to the library.
    [core.kicad_sch, gpio.kicad_sch, power.kicad_sch]
2026-10-03 Add USB and MIPI supply decoupling to Core sheet
    Per MIMXRT1170-EVKB RevC3 sheet 8: 120R beads from +1V8/+3V3 into
    VDD_USB_1P8, VDD_USB_3P3, VDD_MIPI_1P8 with 1uF each; VDD_MIPI_1P0 fed
    from the internal VDDA_1P0 LDO via 0R (R4) with 1uF; 1uF on each VBUS.
    PWR_FLAGs on the four passively-fed rails.
    [core.kicad_sch]
2026-10-03 Add DCDC output 0R links and feedback SENSE links to Power sheet
    R5/R6 (0805) route DCDC_ANA -> +1V8 and DCDC_DIG -> VDD_SOC_IN;
    R7/R8 (0402) close DCDC_ANA_SENSE and DCDC_DIG_SENSE, per EVKB
    R1851/R1853/R2134/R2106. Power sheet enlarged to A3 for the new group.
    EVKB current-sense shunts and measurement headers are omitted.
    [power.kicad_sch]
2026-10-03 Add 24 MHz and 32.768 kHz crystals
    Core sheet: Y1 24 MHz 2016 4-pad on XTALI/XTALO with 4.7pF load caps
    (EVKB Y4, C316/C317). Power sheet: Y2 32.768 kHz 3215 on RTC_XTALI/O
    next to the SNVS unit; load caps omitted as on the EVKB (internal).
    Both wired directly, no labels on oscillator nets.
    [core.kicad_sch, power.kicad_sch]
2026-10-03 Add reset, ONOFF/WAKEUP buttons, control-pin terminations and boot-mode DIP
    Power sheet: POR_B 100k pull-up to +1V8 + 100nF + reset button (POR_B
    global net for debug nRST); ONOFF and WAKEUP buttons with 100nF;
    TEST_MODE to GND; PMIC_STBY_REQ 10k pull-down; PMIC_ON_REQ labelled.
    GPIO sheet: 2-way DIP on NVCC_LPSR via 4.7k into GPIO_LPSR_03:02 for
    BOOT_MODE[1:0]; BT_CFG switch omitted (FlexSPI NOR default).
    U1B and U1F shifted right and RTC crystal re-routed for label clearance.
    [gpio.kicad_sch, power.kicad_sch]
2026-10-03 Add ARM Cortex 10-pin SWD/JTAG debug header
    J1 2x5 1.27mm on GPIO_LPSR_15/14/11/12 (SWDIO/SWCLK/SWO/TDI), VTref on
    NVCC_LPSR, nRESET to POR_B through D1 RB521S30 (EVKB D2), JTAG_MOD 10k
    pull-down (EVKB R403). TRST left on its internal pull-up.
    [gpio.kicad_sch]
2026-10-03 Add W25Q512NWEIQ QSPI boot flash on FlexSPI1 port A
    U2 (EVKB U23, the populated option) on GPIO_SD_B2_06..11 with 10k CS
    pull-up, 1uF + 100nF decoupling, and FB6 120R + 10uF feeding NVCC_SD2
    from +1V8 so the SD2 bank runs at 1.8V. EVKB 0R option links and the
    octal-flash alternative are omitted. New Nosh:W25Q512NWEIQ symbol
    (derived from KiCad W25Q32JVZP, WSON-8 8x6mm footprint).
    [gpio.kicad_sch]
2026-10-03 Add USB sheet: OTG2 micro-AB host/OTG port and OTG1 USB-C device port
    USB2 (OTG2) replicates MIMXRT1170-EVKB sheet 20: micro-AB (Molex 47590),
    Coilcraft 0805USB-901ML choke, RClamp0854P ESD, 300R VBUS bead + 2x4.7uF,
    NX5P3090UK VBUS switch with the EVKB's ID-gated enable (2SK3018 + 10k/100k)
    so VBUS needs no GPIO, as USBHost_t36 expects on the RT1176. ID and OC go
    to GPIO_AD_08/06. USB1 (OTG1) is a USB-C device port: GCT USB4105, 5.1k CC
    pull-downs, choke, ESD, 300R bead + 4.7uF, shield RC.
    New Nosh:NX5P3090UK and Nosh:RClamp0854P symbols with EVKB footprints;
    USBx_VBUS MCU pins retyped as inputs; micro-B GND pin retyped passive.
    Generator now preserves non-MCU symbols in Nosh.kicad_sym.
    C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
    [Nosh.kicad_sch, core.kicad_sch, gpio.kicad_sch, power.kicad_sch, usb.kicad_sch]
2026-10-03 Add Supply sheet: 5V input, 3.3V buck, SNVS LDO, 1.8V LDO, rail links
    Power tree per MIMXRT1170-EVKB sheets 3/5: barrel jack + 2A polyfuse +
    B340A, ORed with both USB VBUS inputs (MBR120) -> +5V; MP2143DJ 3A buck
    -> +3V3 with EN from PMIC_ON_REQ (10k + 220nF); AP2112K-3.3 always-on
    LDO -> VLDO_3V3 -> RB521S30 -> VDD_SNVS_IN; AMS1117-1.8 -> +1V8. 0R
    links assign +3V3/+1V8 to the MCU rails. Power sheet: R5 (DCDC_ANA ->
    +1V8) now DNP, +3V3/+1V8 PWR_FLAGs removed. New Nosh:MP2143DJ symbol.
    [Nosh.kicad_sch, power.kicad_sch, supply.kicad_sch]
2026-10-03 Add SDRAM sheet: 2x IS42S16320F-7TLI on 32-bit SEMC (128 MB)
    Same arrangement as the EVKB's two W9825G6KH (U13/U25) but with 512Mb
    ISSI parts (JLCPCB C1348819): U9 on D0..15, U10 on D16..31, shared
    A0..A12/BA/CS0/RAS/CAS/WE/CKE, 0R per CLK, 7x100nF + 4.7uF per chip,
    120R bead + 22uF/4.7uF feeding SDRAM_3V3. SEMC labels added to the
    EMC unit on the GPIO sheet. New Nosh:IS42S16320F-7TLI symbol.
    [Nosh.kicad_sch, gpio.kicad_sch, sdram.kicad_sch]
2026-10-03 Switch SDRAM to IS42S16320F-6TL (166 MHz)
    JLCPCB C17672183, Extended part (one-time loading fee per PCBA order).
    Pin-identical to the -7TLI; allows the EVKB's 166 MHz SEMC clock.
    Symbol renamed and sheet notes updated.
    [sdram.kicad_sch]
2026-10-04 Add M.2 Key-E socket (uSDHC1, 1.8V) and microSD (uSDHC2, 3.3V) on separate buses
    M.2 sheet: 67-contact Key-E socket for the u-blox MAYA-W1 / NXP IW416
    on uSDHC1 (GPIO_SD_B1_00..05) with NVCC_SD1 = +1V8, so M2Radio works
    unchanged (no VSELECT mux, no shared slot). Two 74AVC8T245PW shifters
    as on the EVKB (U354/U355): 3.3->1.8V for SDIO_RST, UART TXD/RTS,
    BT/WL_DEV_WAKE; 1.8->3.3V for SDIO_WAKE, UART RXD/CTS, UART_WAKE.
    WL_3V3 bead + caps, SDIO pull-ups, W_DISABLE1/2 networks driven from
    GPIO_AD_31/AD_15, WiFi/BT LEDs. SUSCLK left NC (M2-MAYA-W1 pin 50 is NC).
    SD card sheet: Hirose DM3AT microSD on uSDHC2 (GPIO_SD_B2_00..05),
    IRLML6401 power switch (SD_PWREN_B = GPIO_AD_35), pull-ups, CLK ser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
    [Nosh.kicad_sch, gpio.kicad_sch, m2.kicad_sch, sdcard.kicad_sch, supply.kicad_sch]
2026-10-04 Add LCSC/MPN fields to all parts, rebuild M.2 socket footprint from EVKB IPC data
    Every symbol instance on all sheets now carries hidden LCSC and MPN
    properties (223 instances, 57 order lines, 20 of them JLCPCB Basic),
    verified against JLCPCB's live parts search; summary table in
    tools/data/lcsc_parts.csv.
    Part changes made while sourcing:
    - J6: TE 2199230-4 (the EVKB socket, C2977809). The footprint was a
    placeholder grid; regenerated from the EVKB IPC-D-356 pad data plus
    the TE drawing (solder-peg holes, standoff tabs, outline, courtyard).
    - Y1: Murata XRCGB24M000F2P91R0 8 pF (EVKB part, matches 4.7 pF caps).
    - Y2: Epson Q13FC13500002 7 pF (EVKB uses a 7 pF FC-135, no ext. caps).
    - L5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
    [core.kicad_sch, gpio.kicad_sch, lcsc_parts.csv, m2.kicad_sch, power.kicad_sch, sdcard.kicad_sch, sdram.kicad_sch, supply.kicad_sch]
2026-10-04 Switch SDRAM to 2x W9825G6KH-6 (256Mb, 64 MB total)
    IS42S16320F-6TL has essentially no JLCPCB stock; the Winbond part is the
    EVKB's family (W9825G6KH-5I), same JEDEC x16 TSOP-II-54 pinout (A0..A12,
    BA0/1, pin 40 NC), -6 grade = 166 MHz CL3, C62246.
    - Nosh.kicad_sym: ISSI symbol replaced by W9825G6KH-6 (identical pins);
    KiCad re-sorted the library on save, other symbols unchanged.
    - sdram.kicad_sch: U9/U10 lib_id, value, LCSC/MPN, datasheet; notes now
    64 MB, 13 row x 9 column (SEMC COL=9 as on the EVKB), ISSI 512Mb part
    listed as pin-compatible upgrade.
    - tools/data/lcsc_parts.csv regenerated.
    Netlist and ERC unchanged.
    [lcsc_parts.csv, sdram.kicad_sch]
2026-10-04 Switch USB chokes L3/L4 to Murata DLW21HN900SQ2L
    Coilcraft 0805USB-901ML has ~150 pcs at JLCPCB; the Murata part is what
    the EVKB uses on both ports of this PHY (L12/L13), 90R @ 100 MHz, 51k in
    stock, C80529.
    - New footprint Nosh:L_CommonModeChoke_Murata_DLW21, land pattern taken
    from the EVKB L12 IPC-D-356 data (0.914x0.406 pads, 1.70x0.80 grid),
    windings 1-2 / 4-3 as the schematic symbol expects.
    - usb.kicad_sch: L3/L4 value, footprint, LCSC/MPN, datasheet, note text.
    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
    [lcsc_parts.csv, usb.kicad_sch]
2026-10-04 Replace OTG VBUS switch NX5P3090UK with TI TPS2553DBVR
    The NXP part is a 0.4 mm-pitch WLCSP with no JLCPCB stock; the TPS2553
    (SOT-23-6, C55266) keeps the same control topology: active-high EN from
    the ID gating, open-drain FAULT to USB_OTG2_OC, resistor-set limit,
    reverse-voltage shutoff.
    - Nosh.kicad_sym: new TPS2553DBVR symbol (1 IN, 2 GND, 3 EN, 4 FAULT,
    5 ILIM, 6 OUT per TI SLVS841); NX5P3090UK symbol and the WLCSP-12
    footprint removed.
    - usb.kicad_sch: U3 replaced in place with new pin labels; R23 100k ->
    22k (I_OS 1.09/1.17/1.26 A min/nom/max from TI eq. 1); note updated.
    Nets unchanged apart from U3's pin numbers; ERC unchanged.
    Co-Au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
    [lcsc_parts.csv, usb.kicad_sch]
2026-10-04 Add MIMXRT1176DVMAB as accepted MCU alternate; add README
    NXP moved the RT1170 family to rev-B silicon (PCN 202502019I); the rev-A
    MIMXRT1176DVMAA is NRND but the only part obtainable in small quantities.
    Keep it, and document the pin-identical rev-B part as an accepted alternate.
    - U1: description names both parts; all 12 units carry MPN_Alt /
    LCSC_Alt (MIMXRT1176DVMAB, C44999798). Same text in the symbol
    generator so regeneration keeps it.
    - README.md: board overview, sheet list, sourcing/BOM notes including
    the MCU availability situation and the consign-from-distributor advice.
    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
    [core.kicad_sch, gpio.kicad_sch, power.kicad_sch]
2026-10-04 Add LCD sheet: MIPI DSI connector for the RK055HDMIPI4MA0 display and touch
    New hierarchical sheet "LCD" (page 10) replicating MIMXRT1170-EVKB J48:
    - J7: 40-pin 0.5 mm FPC, Wuerth 68714014022 (EVKB connector, C6264899);
    pinout per the EVKB netlist and the Rocktech RK055MHD091A0-CTG spec.
    Footprint generated from the EVKB IPC-D-356 land pattern (= Wuerth's
    recommended pattern). New LCD_FPC40, UM1663S and ME6211C28M5G symbols.
    - MCU side: DSI lanes on A8/B8, A10/B10, A9/B9; LCD reset GPIO_AD_02,
    backlight GPIO_AD_30, panel power GPIO_DISP_B2_15, touch INT/RST
    GPIO_AD_00/01, LPI2C5 on GPIO_LPSR_04/05, TE GPIO_AD_05 - the NXP
    board.h map, so MipiDisplay/panels/rk055 runs unchanged.
    -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
    [Nosh.kicad_sch, core.kicad_sch, gpio.kicad_sch, lcd.kicad_sch, lcsc_parts.csv]
2026-10-04 Remove the on-board LCD backlight boost and 2.8 V LDO
    The RK055HDMIPI4MA0 adapter (NXP SPF-39012) generates its own 2.8/1.8/3.3 V
    rails and drives its own backlight from the 5 V on FPC pins 39/40, with
    its jumpers defaulting to on-board, so the EVKB-style UM1663S boost and
    the 2.8 V LDO added as DNP in the previous commit are dropped entirely.
    - lcd.kicad_sch: U13/L6/D8/C120-C123/R61-R63/R65/R78 and
    U14/C124-C126/R68 removed; J7 pins 1/2 (LEDK/LEDA) and 23 (VDD_2V8)
    are no-connects; notes updated (keep adapter J3/J5/J6 at 1-2).
    - Nosh.kicad_sym: UM1663S and ME6211C28M5G symbols removed.
    - tools/data/lcsc_parts.csv regenerated; README updated.
    Only the removed parts' pins leave the netl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
    [lcd.kicad_sch, lcsc_parts.csv]
2026-10-04 Add Audio sheet: WM8962 codec on SAI1/LPI2C5 with line-out and line-in jacks
    New hierarchical sheet "Audio" (page 11; root sheet enlarged to A3):
    - U15 WM8962BECSN/R (EVKB U368, C5184531) on the EVKB SAI1 pads
    (GPIO_AD_17 MCLK, AD_22/23 TX_BCLK/TX_SYNC -> BCLK/LRCLK, AD_21 TXD0,
    AD_20 RXD0; RX_BCLK/RX_SYNC links DNP as EVKB R2124/R2125) and on
    LPI2C5 (2-wire mode, 0x1A). CODEC_1V8 from +1V8 via 0R with EVKB
    decoupling, DBVDD/MICVDD from +3V3, SPKVDD from +5V (speakers open).
    Charge-pump, VMIDC and MICBIAS caps per the datasheet.
    - J8 line out: HPOUTL/R via 120R beads + 20R/100nF Zobel, HPOUTFB to
    jack ground; J9 line in: 1uF into IN2L/IN2R. Both CUI SJ-3523-SMT.
    - New symbols WM8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
    [Nosh.kicad_sch, audio.kicad_sch, gpio.kicad_sch, lcsc_parts.csv]
2026-10-04 Rewrite README; add the BOM-table regeneration script to tools
    README now documents the board as built: status and ERC baseline, block
    table, a pin map for software, every deliberate difference from the
    MIMXRT1170-EVKB with its reason, BOM statistics and a low-stock watch
    list, the repository layout with footprint provenance, and the
    verification workflow.
    tools/lcsc_table.py regenerates tools/data/lcsc_parts.csv from the LCSC/MPN
    fields on all sheets (paths relative to the script).
2026-10-04 README: add flashing and debugging section
    How QSPI flashing works on the RT1176, the J1 SWD header pinout, probe
    options (CMSIS-DAP incl. MCU-Link, Pi Debug Probe, Atmel-ICE, SAMD21 +
    free-dap; J-Link), the pyOCD commands, and the probe-less ROM serial
    downloader path over USB-C with SPSDK/blhost.
2026-10-04 Fix DNP flags: R20 EN pull-down must not be fitted; give C115 its value
    - usb.kicad_sch: R20 (10k pull-down on the TPS2553 EN, EVKB R162) was
    fitted although the note and the EVKB say DNP; together with the 100k
    pull-up it would have held EN at 0.3 V and VBUS off. Now DNP.
    - sdcard.kicad_sch: C115 had the literal value "DNP" and no DNP flag;
    now 18pF C0G (EVKB C247, C1549) marked DNP.
    - tools/data/lcsc_parts.csv regenerated; every line has an LCSC code.
    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
    [lcsc_parts.csv, sdcard.kicad_sch, usb.kicad_sch]
2026-10-04 Add Test points sheet: 72 bare-pad test points; bring out LPUART1 console
    - New testpoints.kicad_sch (page 12): GND x6 (2.0 mm plated holes), supply
    rails, MCU power domains, reset/boot/power control, peripheral control and
    bus/clock nets, one global label each. KiCad TestPoint footprints, in_bom
    = no, so nothing is added to the JLCPCB order.
    - GPIO sheet: LPUART1_TXD/RXD labels on GPIO_AD_24/25 (SDK debug console),
    reachable on TP62/TP63.
    - lcsc_table.py skips test points; CSV unchanged.
    - README: test point table, LPUART1 pin-map row, sheet list.
    [Nosh.kicad_sch, gpio.kicad_sch, testpoints.kicad_sch]
2026-10-04 README: note that the EVKB M.2 HCI UART rework does not apply to Nosh
2026-10-04 LPI2C5 pull-ups R74/R75: 4.7k -> 2.2k (EVKB-equivalent bus strength)
    [lcd.kicad_sch, lcsc_parts.csv]
2026-10-05 Add RK055 adapter mounting holes H1-H4 and a user LED on GPIO_AD_04
    - LCD sheet: four grounded M3 mounting holes on the RK055HDMIPI4MA0 adapter's
    SS1-SS4 standoff positions (board outline = adapter outline). New project
    footprint MountingHole_3.53mm_M3_Pad: 3.53 mm plated hole, 5.6 mm GND pad,
    NXP's .635" M3 standoff land as on the EVKB. Hole coordinates still to be
    taken from the adapter design files or measured.
    - GPIO sheet: user LED on GPIO_AD_04 (SDK BOARD_USER_LED), direct drive,
    1k series + red 0603 (parts already on the BOM).
    - lcsc_table.py skips mounting holes; README mechanical row, pin-map row.
    [gpio.kicad_sch, lcd.kicad_sch, lcsc_parts.csv]
2026-10-05 Add 2x10 expansion header J10, boot-strap pull-downs, NC flags on unused MCU pins
    - J10 (2x10 2.54 mm, JLCPCB C42372518): +3V3, +5V, 3x GND, LPUART1
    console, LPI2C5, LPSPI3 (SCK/SOUT/SIN + GPIO CS), GPIO_LPSR_00/01
    (FLEXCAN3 / LPUART12 / PDM / MQS), GPIO_AD_10..13 (ADC1 / FlexPWM2 X),
    GPIO_AD_26 (FLEXPWM2_PWM1_A). 3.3 V pads only, no boot-strap pins.
    - NVCC_DISP1 1.8 V -> 3.3 V (R39 moved to the +3V3 rail group): the bank
    is unused except for the J10 LPSPI3 pins.
    - Boot straps: 100k pull-downs on BOOT_MODE0/1 (EVKB R34/R35) and on the
    12 BOOT_CFG pins (EVKB 47k). The pads have no pull at reset (RM IOMUXC
    reset values), so internal boot could read random settings before.
    - No-conn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
    [core.kicad_sch, gpio.kicad_sch, lcsc_parts.csv, power.kicad_sch, supply.kicad_sch]
2026-10-05 Switch codec to SGTL5000; 3 A input fuse, SS54, debug UART J11, power LED, fiducials, EVKB DNP pads
    Audio
    - U15 is now the SGTL5000XNLA3R2 (QFN-20 3x3, JLCPCB C2651833), the Teensy
    Audio Shield codec, replacing the WM8962 (0.5 mm WLCSP-49). Wired per the
    datasheet's 20-QFN application circuit and the Teensy library's power
    assumptions: VDDD external 1.8 V (CODEC_1V8), VDDIO +3V3, VDDA +3V3 via
    FB11 (new net AUD_VDDA, on TP16), VAG 100nF. Same SAI1 pins and links,
    LPI2C5 control at the fixed QFN-20 address 0x0A.
    - J8 is now a true line output (LINEOUT_L/R through 1uF); the headphone
    amplifier and mic inputs are unused. J9 line in unchanged.
    - WM8962 symbol and WCSP-49 footprint re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
    [audio.kicad_sch, gpio.kicad_sch, lcd.kicad_sch, lcsc_parts.csv, power.kicad_sch, sdram.kicad_sch, supply.kicad_sch, testpoints.kicad_sch]
2026-10-05 Add JLCPCB design rules; replace placeholder MCU and RClamp footprints
    - Kicad/Nosh.kicad_dru: JLCPCB custom DRC rules from kicad-druid
    (JLCPCB/JLCPCB-6L-1oz.kicad_dru, upstream 8af046d), rules unchanged,
    MIT notice kept in the header. The 4-layer 1 oz file has identical
    rules. KiCad loads it automatically. README: new "PCB design rules
    (JLCPCB)" section with the main limits.
    - U1: the project footprint bga289_0p8_14x14_1p52mm was a placeholder
    from the EVKB pst2kicad stub library (0.6 mm pads on a 1.2 mm grid).
    U1 now uses KiCad's Package_BGA:MAPBGA-289_14x14mm_Layout17x17_P0.8mm
    (0.32 mm pads, EVKB 0.33 mm) and the stub is deleted. Symbol, symbol
    generator, parts table and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
    [core.kicad_sch, gpio.kicad_sch, lcsc_parts.csv, power.kicad_sch]
2026-10-06 Add bottom-side fiducials FID4-FID6; D3/D4 to the SOD-123F footprint
    - LCD sheet: FID4-FID6 (Fiducial_1mm_Mask2mm, out of the BOM and CPL)
    for the bottom-side assembly pass. The MCU bypass capacitors and the
    display FPC connector now go on the bottom. KiCad has no schematic
    side attribute, so flip FID4-FID6 to the back in the PCB editor; the
    sheet note and their Description field say so. Fiducial heading and
    README mechanical row updated.
    - D3/D4 (MBR120VLSFT1G, SOD-123FL): Diode_SMD:D_SOD-123 -> D_SOD-123F,
    the flat-lead land. Pads 1/2 unchanged. Parts table regenerated.
    - ERC clean; nets unchanged.
    [lcd.kicad_sch, lcsc_parts.csv, supply.kicad_sch]
2026-10-06 Add M.2 retention nut H5 (M2.5 SMT, 2 mm, as EVKB BH1) with a 2.5 mm fallback
    - M.2 sheet: H5, a YIYUAN SMTSOM2.520BTR M2.5 SMT round nut, 2 mm high
    (LCSC C5301776), on GND, as EVKB BH1. Sheet notes: place it 30 mm from
    the centre of J6's signal pads, on J6's centre line (EVKB BH1 to J54).
    If C5301776 has no stock at order time, fit the 2.5 mm SMTSOM2.525BTR
    (C49236513) on the same land; the card end then sits 0.5 mm higher.
    - New footprint Nosh:SMTSO_M2.5_Hole4.22mm_Pad6.2mm: 4.22 mm plated hole
    and 6.2 mm pad (YIYUAN SMTSO datasheet, same as the EVKB BH1 land),
    0.05 mm mask margin, and the EVKB's 4-segment paste ring (0.18 to
    0.25 in). SMD attribute; DRC clean on a test board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
    [lcsc_parts.csv, m2.kicad_sch]
2026-10-06 PCB stage 1: board setup, netlist import and floor plan; fix mirrored FPC40 footprint
    - Kicad/tools/build_board.py (pcbnew, KiCad's bundled Python) generates
    Nosh.kicad_pcb from the schematic netlist: 6 copper layers in the EVKB
    order (F.Cu, GND1, SIG, PWR, GND2, B.Cu), JLC06161H-3313 stackup, all
    362 footprints with nets (1292 pad nets checked against the netlist),
    155 x 83.5 mm outline, H1-H4 on the 147.253 x 72.905 mm pattern,
    explicit positions for connectors/ICs/holes/fiducials, small parts
    packed beside the part they connect to, MCU decoupling on the back,
    J7 display FPC on the back at the north edge, inner GND zones.
    - Nosh.kicad_pro: JLC design rules, track/via/diff-pai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
    [Nosh.kicad_pcb]
2026-10-07 SDRAM: 2x Alliance AS4C32M16SB-6TIN (512 Mb), 128 MB; SEMC 10-column-bit note
    - U9/U10 are now AS4C32M16SB-6TIN (32Mx16, 166 MHz, JLCPCB C1351095;
    four pre-ordered Oct 2026). Pinout checked against the datasheet:
    same JEDEC TSOP-II-54 pins as the W9825G6KH-6 (pin 36 A12, pin 40
    NC), so footprint and wiring are unchanged. Board fields updated.
    - Project symbol renamed W9825G6KH-6 -> SDRAM_x16_TSOP54, with the
    fitted part and the pin-compatible 256 Mb / 512 Mb alternates in
    its description. Sheet notes rewritten (the old note named the
    wrong 512 Mb upgrade part).
    - README: SDRAM rows, stock table row with the W9825G6KH-6 fallback,
    and a "SDRAM configuration" section: 13 row x 10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
    [Nosh.kicad_pcb, lcsc_parts.csv, sdram.kicad_sch]
2026-10-07 PCB stage 2: MCU fan-out, PWR planes, placement optimisation; restore project rules
    - U1 dog-bone fan-out: 145 vias (0.45/0.3 mm) for every connected ball
    from the third ring inwards; the outer two rings escape on F.Cu. The
    bottom-side decoupling moved into a ring around the via field.
    - PWR layer (In3): +3V3 plane with +5V (supply corner), SDRAM_3V3 (under
    U9/U10), WL_3V3 (M.2) and VDD_SOC_IN (MCU core) islands.
    - Placement optimisation (tools/optimise_placement.py): test points next
    to the far end of the net they probe and out of the BGA escape zone,
    0.5 mm courtyard spacing, free parts re-placed near their connections
    with the best of 4 rotations, two nudge/rotate sweeps. Tota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
    [Nosh.kicad_pcb]
2026-10-08 USB: fix DLW21 choke wiring, MCU D- on pin 3 so both MCU lines enter the same end (as EVKB L12/L13)
    The symbol draws pins 2 and 4 on the same side while the part has pins 2 and 3 at one end
    (windings 1-2 and 4-3), so D- entered the opposite end to D+ and the choke would block the signal.
    Swap the pin 3/4 labels on L3 and L4; add a note on each choke.
    [usb.kicad_sch]
2026-10-08 Project: restore JLCPCB design rules and net classes (KiCad had overwritten them with defaults)
2026-10-08 Tools: fan-out, PWR zones, plane stitching and differential-pair routing scripts (pcbnew)
2026-10-08 Test points to 1.0 mm pads; GND pours on F.Cu/B.Cu (unfilled) with a 0.5 mm pour-to-pair rule
    - testpoints sheet and board: TP7-TP72 TestPoint_Pad_D1.5mm -> TestPoint_Pad_D1.0mm (TP1-TP6 stay 2.0 mm plated holes)
    - tools/gnd_pours.py adds the two outer GND zones (0.25 mm clearance, 0.2 mm min width, islands removed, thermal reliefs)
    - Nosh.kicad_dru: zone clearance 0.5 mm to the USB_90 / MIPI_100 net classes
    [Nosh.kicad_pcb, testpoints.kicad_sch]
2026-10-08 Floor-plan search: annealing macro placer (tools/floorplan); apply locked-floor-plan polish
    Sides stay as the EVKB plan (SDRAM west, M.2 east): other sides came out equal or worse. Polish with the
    floor plan locked moved the small blocks (U2 north of the MCU, J5 on the north edge, U11/U12 east, J10
    horizontal south-east, U15 by the jacks, J1/J11 south-west) and re-placed passives and test points.
    Macro rats-nest 5331 -> 4677 mm, crossings 1976 -> 1507, full rats-nest 4839 -> 4683 mm.
    [Nosh.kicad_pcb]
2026-10-08 MCU fan-out vias to 0.45/0.2 mm (EVKB size) for inner-layer escape room; min through hole 0.2
    [Nosh.kicad_pcb]
2026-10-08 DRC rule: 0.1 mm track-to-via clearance for the fan-out vias (hole < 0.3 mm) so a 0.1 mm track fits between them
2026-10-09 Outline to the RK055 carrier's 153.9 x 81.8 mm; USB chokes/ESD on the bottom; pairs regenerated; DRC rule and track-width tidy-ups
    - tools/shrink_outline.py: square 153.9 x 81.8 outline, holes re-centred on the EVKB 147.253 x 72.905 pattern,
    J7 at x 70.65 (aligned with the carrier's 20.4 mm FPC, user-measured 2026-10-09), J2/J3 and the USB parts 1.1 mm
    west, J8/J9 1.7 mm north, zones clipped
    - optimise_placement.py now the corridor version: L3/L4/U4/U5 pinned on the bottom in line with the USB pairs,
    U2 pinned clear of the MIPI corridor; gnd_pours / pwr_zones / stitch_planes / route_pairs carry the new size
    - board: pairs regenerated (MIPI skew 0.00, USB within budget), L3/L4 pad nets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
    [Nosh.kicad_pcb]
2026-10-09 SDRAM routing plan: U10 at x 37.5 (3 mm via gap), routing corridors, no-tracks-on-plane-layers rules, plan note and README table
    [Nosh.kicad_pcb]
2026-10-10 SDRAM: EVKB-style placement, prebuilt chip-side geometry, routed and length-tuned bus; C-core bus router
    - U9/U10 as the EVKB's U13/U25: rot 270, stacked N/S west of the MCU (x 40.10, y 24.85 / 48.85, on the 0.05 mm
    router grid); SDRAM_3V3 island moved under them, +5V island trimmed; R41/R42 at the channel's east end
    - tools/sdram_prebuild.py: address links on the bottom joining both chips at each pin's x, vias beside outer data
    pins and every power pin
    - tools/busrouter: C A* core (ctypes, ~50x the Python search), negotiated congestion with hard fixed copper,
    neighbour rip-up, seeds run in parallel; per-pin length analyser, meander tuner, waypoints, partial rip-up
    - board: all 60 SEMC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
    [Nosh.kicad_pcb]
2026-10-11 Plane stitching (249 vias) on the power pads; inner planes typed as power layers for autorouting
    - stitch_planes.py skips U9/U10 (their power vias come from sdram_prebuild.py) and leaves the outer pours unfilled
    - one GND stitching via inside J5's keep-out removed
    [Nosh.kicad_pcb]
2026-10-11 Route the rest of the board: Freerouting result + greedy general router, 98 connections left open
    - Freerouting full and incremental passes applied; header-pin tracks that broke the 0.2 mm PTH
    pad-to-trace rule rerouted (fr_export.py grows through-hole padstacks for the DSN)
    - SDRAM_3V3 island extended over the SDRAM capacitors; stitching respects via keep-outs and
    skips pads that already have a track
    - genroute.py: general router on the A* core (islands per net, links or plane vias, greedy mode)
    brought unconnected from 206 to 98; DRC clean apart from the known library items
    - window_strip.py helper; README documents the new tools and routing status
    - SDRAM bus and its length tuning u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
    [Nosh.kicad_pcb]
2026-10-12 BGA escape tooling, hand-route list, 0.1 mm net-class clearance
    - bga_strip.py / bga_escape.py: clear the field round U1 and rebuild EVKB-style escapes with a negotiated
    router (rings 0/1 on top, inner rings down the via-lattice channels on SIG/B.Cu); places 130-138 of 146
    escapes DRC-clean, but no join back to the rest of the board beat the committed 98 open connections, so the
    board is unchanged (results in the README)
    - sw_rework.py: the local fixes found on the way (C145 moved, SEMC_D30/A3/DQS lanes cut for genroute to
    re-join, DCDC_IN PWR island, VDD_SOC island trimmed); unlock_old.py for Freerouting passes
    - genroute.py: no duplicate plane via when a path ends with a layer chan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
    [fr_export.py]
2026-10-12 Free the DCDC_LP/LN exits and add a DCDC_IN island: 98 -> 95 open connections
    - SEMC_D30's top-layer run under U3/U4 cut and re-joined by genroute on the bottom (31.2 -> 36.9 mm, 6 vias)
    - DCDC_LP (U3/T3) and DCDC_LN (U4/T4) reach L1 as 0.1 mm placeholders (to be widened by hand)
    - DCDC_IN island on PWR under L5/M5/N5; VDD_SOC island trimmed to x >= 69.6 (nothing was there)
    - duplicate / too-close GND stitch vias cleaned up (J7 pin 36 via re-placed)
    - DRC otherwise unchanged (the known J2/J3 library items only)
    [Nosh.kicad_pcb]
2026-10-12 handroute_list.py: regenerate the U1 hand-route list and close-up from the current board
    - runs kicad-cli DRC on a scratch copy, traces each open end to its copper, groups by exit side
    - Kicad/handroute regenerated from ff6e513: 67 open U1 connections (was 70), 95 open in total
2026-10-12 Fan-out first: all 247 connected balls escape the field on a clean board
    - all routing removed; placement, PWR islands and pours kept
    - fanout2.py: DC-DC block moved to U1's south edge (L1, R5/R6/R7, C23/C24, C27/C28, C30-C33; R13, R37, R90,
    R99, FB5, C1, C7, C145 pushed out), PWR islands for DCDC_IN / DCDC_ANA / DCDC_DIG in via-free corridors through
    the lattice, VDD_SOC lobe to R6, fan-out vias for every ring >= 2 ball (power balls on fixed cells first)
    - bga_escape.py at 0.1 mm for everything (3 seeds + second pass): 194 escapes, 7 plane vias, 46 balls on planes,
    none contested; widen_power.py then widens power tracks where room allows
    - DRC: known J2/J3 items only; the three big pl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
    [Nosh.kicad_pcb]
2026-10-12 SDRAM bus on the fan-out-first board: all 60 nets routed and tuned (seed 51)
    - SDRAM balls' escapes stripped back to the fan-out; non-SDRAM escapes in the NW corner cleared, re-escaped after
    - west_stubs.py: fixed top-layer exits for the ring-1 balls of column 2 (the 15-into-16 gap chain)
    - busroute.py: the outer ring of lattice cells is via-free (ring-0/1 exits); 5 of 8 seeds converged
    - bustune: six short data nets meandered; SEMC_D16 remains 29 mm short of U10's clock
    - stitch_planes.py: plane table extended with the DCDC_IN / DCDC_ANA / DCDC_DIG islands and the VDD_SOC lobe
    - still open at the grid: A1/U1 GND corners, A4 LCM_PWR_EN, E7 NVCC_DISP2, D7 BT_CFG9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
    [Nosh.kicad_pcb]
2026-10-12 Stitching, open-field routing and the DC-DC block re-placed south of the escape fan: 178 open
    - stitch_planes: 261 vias; genroute greedy at 0.1 mm for the rest (Freerouting: 315 open, not used)
    - dcdc_block2.py: caps and R5/R6 in four columns at y 58-64 over 1.1 mm PWR lobes that jog under L1;
    no-via strip 67.4..73.8 x 49.0..51.6 so escape vias cannot cut the lobes; L1, R7, R90, R37, R13, TP40,
    C44, C50, C144 moved clear; DCDC_IN connected, DCDC_ANA/DIG caps still need vias
    - genroute: same-net via spacing between islands of one call; genroute/bga_escape: no duplicate via on a
    double layer change
    - hand-route list regenerated: 51 U1 connections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
    [Nosh.kicad_pcb]
2026-10-12 plane_vias.py: nearest-site plane-via placer; DC-DC and VDD_SOC pads tied in: 166 open
    - plane_vias.py: for each pad of a plane net without a via into its plane, the nearest 0.05 mm grid site within
    3 mm inside the net's fill, JLCPCB clearances on every layer (0.2 mm hole-to-copper, 0.554 mm own vias),
    outside no-via areas (the islands' own region excepted), reachable by a straight track; 26 vias placed
    - dcdc_block2.py: the whole lobe region is a routing-time no-via area (other nets' vias cut the 1.1 mm lobes);
    VDD_SOC pocket under its north caps through a via-free neck at column 9; C19 into the VDD_SOC column
    - routing-time rule areas removed on apply; hand-route list regenerated (42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
    [Nosh.kicad_pcb]
2026-10-12 +5V and WL_3V3 islands extended to their far pads
    - +5V: tongue north to D2, south-centre strip for U6/U7/D4 (clear of L5/U6 +3V3 pads), tongue to J10.2,
    2 mm corridor up the east side to a patch at 79.5-83.6 x 29.5-43 for U3/D3
    - WL_3V3: west extension 85.6-110 x 38-48 for U11/U12, south lip for FB10/R51/R52 (kept clear of +3V3 vias)
    - plane vias placed for the newly covered pads; 166 open; hand-route list regenerated
    [Nosh.kicad_pcb]
2026-10-12 +3V3 plane back under the 1.8 V regulator block; plane_cleanup.py: 157 open
    - +5V island stops at x 23.2 south-west (its parts end at x 22.5); SDRAM_3V3 loses its empty bottom strip and
    gets a notch for R36; D2 tongue narrowed so the +3V3 strip reaches the C82 notch
    - plane_cleanup.py: removes a plane net's clusters that reach no via inside the plane's MAIN fill (KiCad keeps
    fill islands round stray vias); plane_vias.py tests the same way and handles through-hole pads
    - +3V3 fully tied in; hand-route list regenerated
    [Nosh.kicad_pcb]
2026-10-13 Decoupling, USB shields and the DC-DC block signals: 102 open; local_links, per-region negotiation, lobe rule in genroute
    157 -> 102 open (43 at the ball grid), DRC clean apart from the J2/J3 library hole clearances.
    Connected: VDDA_1P8, VDD_USB_3P3, NVCC_GPIO, +1V8 (U8 tab), VDD_SOC_IN (C17/R8 via an island tongue),
    VDD_MIPI_1P8/1P0, NVCC_DISP1, VDDA_1P0, VDD_SNVS_IN, DCDC_MODE, both USB shields, J10's +3V3 pin, LCD_RST_B,
    the DC-DC block signals (PMIC_*, ONOFF, WAKEUP, BOOT_MODE*, JTAG, RTC_XTALI), M2_SDIO_D0.
    - busrouter/local_links.py: closes the short ratsnest pairs of a DRC report (track, L, or via + two tracks),
    keeps foreign vias out of the 1.1 mm PWR lobes.
    - busrouter/net_strip.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
    [Nosh.kicad_pcb]
2026-10-13 Expansion header J10 and the test points taken off the board: 78 open
    tools/strip_parts.py removes J10 and TP1-TP72 (recorded in Kicad/handroute/removed_parts.json with position,
    rotation, side and pad nets so they can be put back), keeps the routes that met at a removed pad by joining
    their ends, drops the copper of the nets left with one pad (the header-only GPIOs keep their fan-out) and prunes
    dangling branches outside the escape band. One greedy pass on the result: 102 -> 78 open (36 at the ball grid,
    42 elsewhere), DRC clean apart from the J2/J3 library hole clearances. The schematic still has the parts.
    genroute.py: the VDD_SOC neck mouth is via-free outright (a via in the pocket besi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
    [Nosh.kicad_pcb]
2026-10-13 East band cleared by placement: USB switch and schottky to the south-east pocket, boot straps north-east, SD nets escape north: 75 open
    The band beside the field (x 78.9-84) held U3/R23/R24, D3/C51 and seven pull-downs in the escape lanes; clearing
    its copper and re-routing never beat 78, so the parts moved (tools/move_out.py): U3, R23, R24, D3, C51 into the
    free pocket at 87-96 x 58-63 with a +5V tongue (80.5-96.3 x 57.8-63.4) replacing the old +5V patch, R93/R95/R98/
    R100/R102/R103/R39 to 90.5-97.5 x 18.5-29.3, and SD_CMD/SD_CLK/SD_DAT0-3 re-escaped north. Then band_strip.py
    (routed copper in the band), greedy with the band-end nets first and a x4 band cost, power nets, plane vias.
    genrou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
    [Nosh.kicad_pcb]
2026-10-13 Codec west pads: hand-laid exits, R74/R75 swapped, band ends freed by negotiation: 71 open
    busrouter/u15_exits.py lays the five exits of U15's pads 16-20 (0.4 mm pitch, pull-ups 0.5 mm in front) by hand:
    R74/R75 swap places so each I2C pull-up sits beside its own pad, SDA/SCL go straight to them, RXD0 north onto its
    existing via, TXD0 to SIG and west under the pull-ups, CODEC_1V8 south; the old CODEC_1V8 exit along the pad row
    and NVCC_SD1's corridor pieces go. The band-end stubs of SAI1_RXD0/TXD0 were boxed in by the east-band re-route;
    a negotiation over the east-south quadrant with the exits pinned connected them, and the nets it dropped were
    restored where they still fit.
    genroute.py DE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
    [Nosh.kicad_pcb]
2026-10-13 Targeted re-escape of the stuck balls with their one-cell neighbours: 66 open, 28 at the grid
    A stuck inner ball cannot be re-escaped alone (its lanes belong to fixed neighbours): busrouter/ball_strip.py
    strips the escapes (WIN=63,33,81,51: inside the chip window only, the routes beyond stay) of the ten stuck balls
    and their single-ball non-bus non-plane neighbours within one cell (40 balls), bga_escape in band mode places all
    40 in seconds, then local_links + greedy reconnect the new band ends and esc/restore.py puts the broken nets' old
    copper back where it still fits. Out of the grid: BT_CFG1, CTP_INT, LPI2C5_SDA, NVCC_DISP1, NVCC_SD1, SD_CMD,
    SD_DAT2, USB_OTG2_OC; seven neighbours now wa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
    [Nosh.kicad_pcb]
2026-10-13 Hand routing in KiCad: MIPI DSI pairs re-routed north, R92 moved, SD_PWREN_B / LPSPI3_SOUT / NVCC_SD2 / FLEXSPI_A_D3 / ADC_VREFH / USB1_DP reworked: 58 open
    Board edited interactively (704 items added, 485 removed, all copper unlocked, R92 from (83.5, 71.75) to
    (70.4, 25.5)). With zones refilled the DRC gives 58 open (26 at the ball grid, 32 elsewhere), down from 66.
    The file was saved with the zones unfilled; refill before DRC (kicad-cli pcb drc --refill-zones).
    Still to fix from this pass - 45 clearance / hole-clearance errors: via-to-via at (86.7, 34.45) BT_UART_TXD vs
    DCDC_ANA and M2_SDIO_CMD, MIPI_DSI_CLKP / D1N vias vs the VDD_MIPI_1P0 via at (73.3, 29.3), MIPI_DSI_D0P via vs
    BT_UART_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
    [Nosh.kicad_pcb]
2026-10-15 Hand routing in KiCad: SD bus, codec SAI1, RTC/XTAL, FLEXSPI_A_D1 and clearance cleanup: 41 open
    Board edited interactively since 553572e. With zones refilled the DRC gives 41 open (15 at the U1 ball
    grid, 26 elsewhere), down from 58. Closed: SD_CLK / SD_CMD / SD_DAT0 / SD_DAT2 / SD_DAT3, SAI1_RXD0 /
    SAI1_RX_BCLK / SAI1_TX_SYNC, FLEXSPI_A_D1, RTC_XTALI / RTC_XTALO / XTALI, USER_LED, ONOFF, DCDC_MODE,
    WIFI_RST_B, USB2_VBUS, VDD_USB_3P3, NVCC_DISP2, BT_CFG7, BT_CFG8, MIPI_DSI_D1N.
    All the clearance and hole-clearance errors from the previous hand pass are fixed, and so is the
    DCDC_ANA / +1V8 short. Errors left: the 4 J3 NPTH-to-pad and 2 J2 slot assertions that were already
    there, and 8 starv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
    [Nosh.kicad_pcb]
2026-10-15 making progress on routing
    [Nosh.kicad_pcb]
2026-10-15 R6 (0R, DCDC_DIG -> VDD_SOC_IN) replaced by net tie NT1: 35 open
    Nosh has no external PMIC option and no current-measurement jumper (the EVKB's R1853 + J14 + R117), so the
    0805 0R link becomes a net tie: one part fewer and no 0R resistance in the core supply path. R8 still takes
    the DC-DC sense from the VDD_SOC_IN side.
    - Nosh.pretty/NetTie-2_SMD_0805: R6's 0805 pads (1.025 x 1.4 mm, 1.825 mm pitch, copper only), excluded from
    BOM and placement files, net_tie_pad_groups "1, 2". The bridge is 0.55 mm wide along one half of the pad gap:
    the routing has a +1V8 via at (73.5, 62.7) in the other half, which a centred bridge shorts.
    - power.kicad_sch: Device:NetTie_2 in R6's place (same symbol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
    [Nosh.kicad_pcb, lcsc_parts.csv, power.kicad_sch]
2026-10-15 21 0R links removed, their nets merged: bank rails, R4, signal isolation and peripheral rail links: 34 open
    Removed and merged (surviving net first):
    - bank rails: R31-R37, R39 -> +3V3 (VDD_LPSR_IN, DCDC_IN, NVCC_GPIO / EMC1 / EMC2 / LPSR / DISP2 / DISP1),
    R38 -> +1V8 (NVCC_SD1). R40 (+1V8 -> ADC_VREFH) stays: a reference input may want a filter.
    - R4: VDD_MIPI_1P0 -> VDDA_1P0.
    - signal isolation: R64 BACKLIGHT_CTL, R72 LCM_PWR_EN, R76 CTP_RST_B, R77 CTP_INT, R17 USB_OTG2_ID,
    R45 WL_RST_B, R48 BT_RST_B (each keeps the MCU-side name).
    - peripheral rails: R69 LCD_IOVCC_1V8 -> +1V8, R70 CTP_3V3 -> +3V3, R71 LCD_5V -> +5V, R79 CODEC_1V8 -> +1V8.
    Schematic: each resistor and the two global l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
    [Nosh.kicad_pcb, audio.kicad_sch, core.kicad_sch, gpio.kicad_sch, lcd.kicad_sch, lcsc_parts.csv, m2.kicad_sch, power.kicad_sch]
2026-10-15 Hand routing (BT_UART_CTS closed), C9 ground spoke, one-spoke rule for the J7 / U1 ground pins: 33 open
    - Board edited interactively since c7e4c33: BT_UART_CTS routed; with zones refilled the DRC gives 33 open.
    - C9 (100nF, VDDA_ADC_3P3, B.Cu): its GND pad reached the B.Cu pour with one spoke (USB2_DP and nearby vias leave
    no pour to its west and south). A 0.2 mm GND track on B.Cu from (91.75, 31.40) east to (92.75, 31.40) runs into
    the pour piece east of the pad and counts as the second spoke.
    - Nosh.kicad_dru: min_resolved_spokes 1 for GND pads of J7 and U1. J7's 0.5 mm pitch leaves no room for side
    spokes, and U1 ball A1 is boxed in by the SDRAM escape tracks; each also has its own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
    [Nosh.kicad_pcb]
2026-10-17 routing complete, final touchess
    [Nosh.kicad_pcb]
2026-10-18 0.1mm SEMC traces to 0.13mm
    [Nosh.kicad_pcb]
2026-10-24 manual cleanup
    [Nosh.kicad_pcb]
2026-10-25 nic: lots of work done, components moved, traces thickened
    [Nosh.kicad_pcb]
2026-10-27 0.13 mm minimum track width: rule, netclasses and track sizes; 0 open
    Every track on the board is now 0.13 mm or wider, so the constraints say so:
    - Nosh.kicad_dru: new rule "Nosh: Trace Width" (min 0.13 mm), placed after
    the JLCPCB 0.09 mm rule so it is the one that applies.
    - Nosh.kicad_pro: minimum track width 0.13; SDRAM track 0.1 -> 0.13;
    MIPI_100 track and diff pair 0.11 -> 0.13; predefined MIPI pair 0.13;
    0.1 / 0.11 removed from the track size list.
    - handroute report regenerated (0 open) and its 0.1 mm wording updated.
    - tools/widen_tracks.py: widens a net's tracks and backs out any segment
    that adds a DRC violation.
2026-10-27 write_project_rules.py: match the project file (0.13 mm minimum, 0.1 clearance)
    The script that restores Nosh.kicad_pro still wrote the old 0.09 minimum,
    0.1 SDRAM / 0.11 MIPI widths and 0.127 net class clearance, so running it
    would have undone e26a4d4. It now writes exactly what the project file holds
    (same JSON), with KiCad's 0.0 placeholder first entries and the classes in
    KiCad's order.
    [write_project_rules.py]
2026-10-27 nic: minor pcb cleanup
    [Nosh.kicad_pcb]
2026-10-28 Schematic in step with the board: J10 and test points removed; dangling stubs cleared
    - gpio.kicad_sch: J10 expansion header removed with its labels and notes; the
    ten U1 pins that only went to J10 (GPIO_AD_10-13, GPIO_AD_26, GPIO_LPSR_00/01,
    LPSPI3_CS/SCK/SIN) get no-connect flags; two notes reworded
    - Test points sheet (TP1-TP72) removed from Nosh.kicad_sch, file deleted
    - lcsc_table.py / lcsc_parts.csv: testpoints sheet and J10 line dropped
    - Nosh.kicad_pcb: six stubs left by push-and-shove deleted (AUD_LRCLK,
    BACKLIGHT_CTL, NVCC_SD2, SD_CD_B, SD_DAT1, WIFI_WAKE_B)
    - tools/remove_dangling.py: deletes DRC-flagged dangling tracks and vias,
    puts back anything whose removal opens a co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
    [Nosh.kicad_pcb, Nosh.kicad_sch, gpio.kicad_sch, lcsc_parts.csv, testpoints.kicad_sch]
2026-10-28 nic: minor aesthetic pcb cleanup
    [Nosh.kicad_pcb]
2026-10-28 Remove dangling copper left by the aesthetic clean-up
    Seven items flagged by DRC, removed with tools/remove_dangling.py: +1V8 via at
    (44.50, 53.20) connected on one layer only, and track stubs on DCDC_PSWITCH,
    USB1_VBUS, WL_DEV_WAKE_1V8, SD_DAT2 (x2) and MIPI_DSI_CLKN (0.02-0.78 mm).
    DRC with schematic parity: 0 open, parity 0; errors left are J3 hole
    clearance x4 and J2 slot shape x2 (library footprints).
    [Nosh.kicad_pcb]
2026-10-28 Stop tracking Nosh.kicad_prl (per-user KiCad view state)
    *.kicad_prl has been in .gitignore since the first commit, but the file was
    added in 89901c4, so every change of layer visibility or view mode showed up
    as a modification. The local copy stays; nothing reads it.
2026-10-28 Symbol descriptions: library text instead of a stray "Unpolarized capacitor"
    71 non-capacitor symbols (37 resistors, ferrite beads, diodes, LEDs, crystals,
    switches, regulators, U2/U4-U8/U11/U12, J1-J6, Q2/Q3, L5) carried the
    capacitor description from when the sheets were first generated (2026-10-03).
    Each now has its library symbol's description; the board footprints' copies
    are updated to match. Hand-written descriptions and the 130 capacitors are
    unchanged.
    ERC 0; DRC with schematic parity: 0 open, parity 0, same J3/J2 errors.
    [Nosh.kicad_pcb, core.kicad_sch, gpio.kicad_sch, m2.kicad_sch, power.kicad_sch, sdcard.kicad_sch, sdram.kicad_sch, supply.kicad_sch]
2026-10-28 USB connectors on their makers' edge lines; Molex notches and 2:1 peg slots
    J2 (Molex 47590-0001) moves 2.145 mm east so its datasheet PCB edge sits on
    the board edge (mouth overhangs 0.70 mm), and the two 0.85 x 2.0 mm notches
    from SD-47590-001 are cut into the east outline. J2 now uses a project copy,
    Nosh:USB_Micro-AB_Molex_47590-0001_JLC, with the rear peg holes lengthened
    to 0.65 x 1.30 mm (pads 1.05 x 1.70) for JLCPCB's 2:1 plated-slot rule; its
    edge and notch outline is kept on Dwgs.User.
    J3 (GCT USB4105) moves 0.85 mm east, flush with the edge per GCT's drawing.
    Tracks under each connector move with it, incoming tracks get straight
    extensions (equal on both lines of each USB pair),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
    [Nosh.kicad_pcb, lcsc_parts.csv, usb.kicad_sch]
2026-10-28 J4, J5, J8/J9 placed by their makers' drawings instead of the courtyard
    All three were left inside the edge by the courtyard-based placement.
    J8/J9 (CUI SJ-3523-SMT) move 0.845 mm south so the snout is flush with
    the south edge; with the plug axis 2.5 mm up, a plug collar used to hit
    the board edge before seating.
    J5 (Hirose DM3AT push-push) moves 0.55 mm north, the most the 0.3 mm
    copper-edge rule allows since its front shield pads sit 0.2 mm ahead of
    the body. A locked card now stands 1.075 mm proud and the over-stroke
    (push-to-eject) point is 0.275 mm outside the edge instead of inside it.
    The SD_CLK_C and SD_DAT2 turns in front of the pad row, the shield GND
    stub and via, and the footp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
    [Nosh.kicad_pcb]
2026-10-28 J3: trim the corner GND pads for the JLC NPTH-to-copper rule
    The stock GCT USB4105 footprint puts the rounded corners of pads A1/B12
    and A12/B1 0.194 mm from the locating-peg holes, under JLCPCB's 0.2 mm
    NPTH-to-copper minimum. J3 now uses a project copy,
    Nosh:USB_C_Receptacle_GCT_USB4105-xx-A_16P_TopMnt_Horizontal_JLC, with
    those four pads shortened 0.03 mm at the peg end (0.6x1.12 instead of
    0.6x1.15), about 0.224 mm clear. Schematic footprint field and parts CSV
    updated, zones refilled.
    DRC: no errors, 0 unconnected, parity clean (silkscreen warnings only);
    ERC clean.
    [Nosh.kicad_pcb, lcsc_parts.csv, usb.kicad_sch]
2026-10-28 Silkscreen to the JLCPCB rules: DRC now clean
    The JLCPCB pad-to-silkscreen rule (0.15 mm) flagged roughly 1,400
    warnings, almost all from KiCad's stock 0402 footprints, whose silk bars
    sit 0.10 mm from the pads.
    - 0402 resistors and capacitors (175) move to project copies
    Nosh:R_0402_1005Metric_JLC / C_0402_1005Metric_JLC without the bars.
    - J4, J5, J8/J9 and Y2 move to *_JLC project copies with silkscreen
    clipped to 0.15 mm from their pads; J4 and J8/J9 also keep it 0.25 mm
    behind the face that sits on the board edge.
    - DLW21 (L3/L4) pin-1 mark moved out to clear pad 1; the M.2 (J6)
    pin-1 mark's short leg no longer touches D6's outline.
    - Twelve reference labels (U2, SW2, Y1, F1, C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
    [Nosh.kicad_pcb, audio.kicad_sch, core.kicad_sch, gpio.kicad_sch, lcd.kicad_sch, lcsc_parts.csv, m2.kicad_sch, power.kicad_sch]
2026-10-28 Q3: source to +3V3, drain to VSD_3V3 so the microSD supply switches off
    The IRLML6401 pinout is G 1, S 2, D 3. Q3 had its source (pad 2) on the
    card side and its drain (pad 3) on +3V3, so the body diode fed the card
    about 2.6 V with the FET off and the card could not be power-cycled.
    - Schematic: Q3 mirrored vertically, so S lands on the +3V3 label and D
    on VSD_3V3 (supply on top, the usual drawing).
    - Board: pad 2 now +3V3, a 0.3 mm stub to a new via in the In3 +3V3
    plane at (25.3, 28.45). Pad 3 now VSD_3V3: its old stub and via carry
    it down to a 0.3 mm In2 link to a new via at (28.4, 28.85), where the
    card feed track now starts. Gate routing unchanged.
    Zones refilled with the pr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
    [Nosh.kicad_pcb, sdcard.kicad_sch]
2026-10-29 U6 buck: input/output caps, L5 and FB divider at the chip
    Decoupling blocker from the 2026-10-28 design review: U6 (MP2143, 3 A)
    had its nearest input cap 32.3 mm from VIN, the FB divider and EN cap
    25 mm away, and 7.7 mm of SW routing to L5.
    - L5 moves under U6: SW drops straight from pin 3 (0.5 mm between
    pins 2 and 4, 0.8 mm into L5).
    - C77/C75/C76 sit beside IN, tied on top into the IN feed under U6,
    with a +5V plane via and a GND via per cap.
    - C74/C73/C72 sit at L5's output, joined on top to three +3V3 plane
    vias.
    - R29/R30 stack over the FB and GND pins (R30 to U6.6; R29 to a
    +3V3 plane via); C71 sits beside R28.
    - The parts' old stubs and plane vias are removed, plus one GND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
    [Nosh.kicad_pcb]
2026-10-29 U3 TPS2553: input caps C62/C63 at the IN pin
    Decoupling blocker from the 2026-10-28 design review: U3's IN caps sat
    by the USB2 connector, 54.5 mm from the pin, against the datasheet's
    "0.1 uF or greater ceramic capacitor from IN to GND as close to the
    IC as possible".
    - C62 (10 uF) and C63 (100 nF) sit beside U3, chained from IN on a
    0.5 mm trace (C62 about 1.8 mm from the pin).
    - Each cap's GND pad has its own GND via.
    - USB_OTG2_OC, USB_OTG2_ID, CTP_RST_B, OTG2_ILIM and SAI1_TXD0 are
    rerouted around the new parts.
    - U3's reference text moves below the part, off C62's pad.
    The output caps C64/C65 stay at the connector as VBUS bulk.
    DRC 0 violations, 0 unconnected, schematic parity 0.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
    [Nosh.kicad_pcb]
2026-10-29 U7 AP2112K: input/output caps C78-C80 at the chip
    C78 (VIN) and C79/C80 (VOUT) moved from beside J4, about 42 mm away, to
    about 2 mm from their pins, and their old copper removed. C79 and C80
    get their own GND vias, and the VLDO_3V3 cap junction now sits on the
    output line.
    [Nosh.kicad_pcb]
2026-10-29 U8 AMS1117: input/output caps C81-C84 at the chip
    C81/C82 (VIN) and C83/C84 (VOUT) moved to 2-3 mm from their pins, from
    up to 15 mm away, and their old copper removed. D11 and R104 moved west
    to make room, and POR_B rerouted on SIG. Each cap gets its own GND via.
    The +1V8 via at (41.05, 69.85), left joining only SIG tracks, is
    deleted.
    [Nosh.kicad_pcb]
2026-10-29 DC-DC step 1: R1 under U1 on DCDC_IN, via-in-pad 0402 footprint
    R1 (30k, +3V3 -> DCDC_PSWITCH) moves from (57.5, 9.25) on top to the
    bottom under U1's south-west corner, as the EVKB wires its R396: pad 1
    on DCDC_IN's via (68.4, 45.6) from ball N5, pad 2 on the C45 -> P3
    PSWITCH track. Its old route (68 mm, 5 vias) is removed and its
    silkscreen reference hidden (it would sit over the via field).
    New footprint Nosh:C_0402_1005Metric_ViP: an 0402 with pad centres
    0.8 mm apart, so both pads sit on U1's fan-out via lattice. It is for
    the decoupling caps that move under the BGA; it needs filled, capped
    vias (free at JLCPCB on 6+ layers).
    [Nosh.kicad_pcb]
2026-10-30 claude: cleaned up, handover to nic
    [Nosh.kicad_pcb]
2026-10-30 nic: traces routed, handover to claude
    [Nosh.kicad_pcb]
2026-10-30 DC-DC step 2 clean-up: dangling items removed, C28 ViP footprint in schematic
    - Board: removed the SIG-only VDDA_1P0 via at (72.33, 54.34), the
    LPI2C5_SCL SIG stub lying on top of its own segment at x 69.6 and a
    0.013 mm RTC_XTALI SIG sliver; zones refilled. DRC: 0 violations,
    0 unconnected, parity 0.
    - power.kicad_sch: C28 footprint is Nosh:C_0402_1005Metric_ViP,
    matching the board.
    - C_0402_1005Metric_ViP: pads take no zone connection (each sits on its
    via), which clears the starved-thermal warning at C28.
    [Nosh.kicad_pcb, power.kicad_sch]
2026-10-30 claude: do BT_CFG7 traces
    [Nosh.kicad_pcb]
2026-10-30 nic: BT_CFG7 done
    [Nosh.kicad_pcb]
2026-10-30 DC-DC step 3: C32/C33 ViP footprint in schematic
    [power.kicad_sch]
2026-10-31 claude: redo LPI2C5_SCL
    [Nosh.kicad_pcb]
2026-10-31 nic: LPI2C5_SCL done, next on the list is VDD_SOC_IN
    [Nosh.kicad_pcb]
2026-10-31 DC-DC step 4: clean-up after LPI2C5_SCL reroute; C24/C25 ViP in schematic
    Remove redundant copies left by the reroute: doubled RTC_XTALI F.Cu run
    from via (73.85, 53.07) to Y2 pad 1, its SIG stub, and overlapping stubs
    on VDD_SNVS_IN, RTC_XTALO and BT_CFG7. power.kicad_sch: C24/C25 footprint
    to Nosh:C_0402_1005Metric_ViP. DRC 0 violations, 0 unconnected, parity 0.
    [Nosh.kicad_pcb, power.kicad_sch]
2026-10-31 claude: do BT_CFG11, DS_PWREN_B
    [Nosh.kicad_pcb]
2026-10-31 nic: done: BT_CFG11, DS_PWREN_B
    [Nosh.kicad_pcb]
2026-10-31 DC-DC step 5: clean-up after BT_CFG11/SD_PWREN_B reroute; SOC caps ViP in schematic
    Remove 13 redundant track pieces left by d071d9c: a 0.89 mm WL_3V3 F.Cu
    copy lying inside the main y 42.66 run, and micro-segments (<= 0.04 mm)
    on BT_CFG11, BT_CFG8, BT_UART_RXD, BT_WAKE_B, NVCC_SD2, SD_CD_B, SD_DAT3,
    SD_PWREN_B, VDDA_ADC_3P3 and WL_3V3, each collapsed into its neighbour.
    LCD_TE's 0.024 mm jog stays: collapsing it breaks via hole clearance.
    power.kicad_sch: C16, C17, C19, C20, C21 -> Nosh:C_0402_1005Metric_ViP,
    matching the board since 945175b.
    DRC 0 violations, 0 unconnected, parity 0; zone islands unchanged.
    [Nosh.kicad_pcb, power.kicad_sch]
2026-10-31 Supplies step 6: C7, C12, C47 via-in-pad under U1
    C7 2.2 uF (VDD_LPSR_DIG, P11), C12 100 nF (VDDA_1P8, M11) and C47 1 uF
    (VDD_USB_1P8, H12) move onto existing supply + GND via pairs under U1,
    0.6 mm from their balls (were 8.0, 17.3 and 7.0 mm), on
    Nosh:C_0402_1005Metric_ViP. No new vias.
    VDD_LPSR_DIG's 23 mm SIG run to C7's old spot is removed; P11's via and
    dogbone stay under C7. C47's old pad sat in series on VDD_USB_1P8's
    feed, which is kept. The old caps' GND plane vias stay as stitching
    vias (one holds a B.Cu GND island to the planes).
    Schematic: C47 (core), C7, C12 (power) -> ViP footprint.
    DRC 0 violations, 0 unconnected, parity 0.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
    [Nosh.kicad_pcb, core.kicad_sch, power.kicad_sch]
2026-10-31 claude: do VDD_USB_1P8
    [Nosh.kicad_pcb]
2026-10-31 nic: done VDD_USB_1P8
    [Nosh.kicad_pcb]
2026-10-31 Supplies step 7: clean-up after VDD_USB_1P8 reroute; C48/C50 ViP in schematic
    Remove a zero-length BT_CFG11 segment and a dangling 0.96 mm SD_DAT2
    duplicate on SIG; straighten the NVCC_SD2 F.Cu/SIG jogs left by nudging
    its G13 via to (75.667, 39.989). core.kicad_sch: C48, C50 on the
    via-in-pad footprint. DRC 0 errors, 0 unconnected, parity 0.
    [Nosh.kicad_pcb, core.kicad_sch]
2026-10-31 Supplies step 8: ViP pads 0.45 x 0.45; C37, C38, C34, C35 via-in-pad under U1
    Shrink the via-in-pad 0402 pads from 0.5 x 0.55 to 0.45 x 0.45 mm (the
    EVKB's under-BGA caps use 0.46 x 0.51): a cap then leaves 0.11 mm to a
    0.13 mm track between lattice columns instead of sealing the channel.
    That fits C37 4.7 uF and C38 2.2 uF (+3V3, E7/G6) beside SEMC_RAS
    without a reroute, plus C34 (NVCC_DISP1, D12) and C35 (+1V8, D14),
    which step 7 had to drop. All four now 0.6 mm from their balls (were
    3.8-37.6 mm); old copper removed. gpio.kicad_sch: C34, C35, C37, C38
    on the ViP footprint. DRC 0 errors, 0 unconnected, parity 0.
    [Nosh.kicad_pcb, gpio.kicad_sch]
2026-10-31 Supplies step 9: C5 and C3 via-in-pad south of U1
    C5 4.7 uF (+3V3 at R12, VDD_LPSR_IN) sits on R12's lattice via (74.8, 47.2)
    with a new GND via (74.8, 48.0); VDD_LPSR_ANA's B.Cu jog moves east to clear
    it. 0.57 mm routed to the ball (was plane-only, ~17.8 mm away).
    C3 100 nF (VDD_SNVS_ANA, U11/U14) sits on SNVS_ANA's SIG -> B.Cu via, moved
    from (77.05, 53.8) to (77.05, 53.413), with its GND pad on the GND via
    (77.05, 52.613). 18.3 -> 5.8 mm routed. C2 stays; C3's old branch ripped.
    C2, C6, C4, C1 and C13 have no legal spot: SIG reset/LCD lines block new
    GND vias south of U1, plus the VDD_SOC_IN PWR island and RTC vias.
    [Nosh.kicad_pcb, power.kicad_sch]
2026-10-31 Supplies step 10: C11 via-in-pad at K15
    C11 (1 uF, VDDA_1P8) moves under U1 onto the existing VDDA_1P8 via
    (77.2, 43.2) and GND via (77.2, 44.0): 19.2 -> 0.57 mm routed to K15.
    Only C11's GND copper is ripped, since the old C11 sat on VDDA_1P8's
    FB2 feed; the two feed segments that met at it are merged into one.
    C11 footprint in power.kicad_sch -> Nosh:C_0402_1005Metric_ViP.
    C14, C8, C51 and C52 are left where they are: no spot without rips
    (the C14 NVCC_SD2 rip has no reroute path).
    [Nosh.kicad_pcb, power.kicad_sch]
2026-10-31 Supplies step 11: C42 at M12, C44 at P7 via-in-pad
    The two +3V3 balls with no cap within 2.8 mm get a 2.2 uF under U1
    each, as on the EVKB (C258, C256):
    - C42 on M12's +3V3 via and USER_LED's old via, now GND: 0.57 mm
    routed. USER_LED moves to the free lattice point (74.8, 44.0);
    VDDA_1P8's B.Cu link through it moves one channel south.
    - C44 on BOOT_MODE0's old via, now +3V3 with a SIG link to P7's via,
    and a new GND via: 1.37 mm routed. BOOT_MODE0 moves to the free
    lattice point (69.2, 45.6); the redundant +3V3 SIG link through it
    goes. DCDC_ANA_SENSE's doubled B.Cu run at x 69.6 becomes one track.
    Old GND copper of both caps ripped; the 24.7 mm +3V3 run under C42's
    old pad stays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
    [Nosh.kicad_pcb, gpio.kicad_sch]
2026-11-01 C41 clean-up: +3V3 plane via beside the pad, redundant 24.7 mm run removed
    C41.1 already reached the +3V3 plane through a 2.7 mm track to the via at
    (67.0, 29.95). A new +3V3 via at (68.3, 28.65) on that track brings the
    plane to about 1 mm from the pad, and the 24.7 mm B.Cu run north to the
    via at (56.8, 8.35) (fed only C41 and the old C42) is removed.
    DRC 0 violations, 0 unconnected, parity 0.
    [Nosh.kicad_pcb]
2026-11-01 U2 decoupling: C59 100 nF and C58 1 uF moved to the flash's VCC pin
    C59 and C58 are U2's caps in the schematic but sat beside FB6, 27.7 and
    23.7 mm from U2.8 (NVCC_SD2). C59 now sits on the track out of U2.8
    (1.7 mm routed) and C58 on the NVCC_SD2 run south of U2 (5.3 mm), each
    with its own GND via; their GND pads take no F.Cu zone connection (the
    pour could only make starved thermals). C58's old NVCC_SD2 stub is
    removed; the tracks through C59's old pad stay (FB6 to C60).
    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
    [Nosh.kicad_pcb]
2026-11-01 U15 decoupling: SGTL5000 supply caps and FB11 moved to the codec
    C127 (VDDD), C130 (VDDIO), C128/C129 (VDDA), FB11 and C131 (VAG) sat in
    the audio block 21-34 mm from U15. They now sit 1.1-3.2 mm from their
    pins. FB11 moved too, taking +3V3 from a new plane via, so the 43 mm
    AUD_VDDA run after the filter (F.Cu + B.Cu, 2 vias) is gone: AUD_VDDA
    is a 4.2 mm chain down from pin 3 (C129, C128, FB11). C131 turned
    vertical under pin 5 to make room. Old +3V3 vias of FB11 and C130 go;
    old GND vias stay as stitching.
    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
    [Nosh.kicad_pcb]
2026-11-01 U11/U12 decoupling: level-shifter caps moved to their supply pins
    C112 (U11 VCCB +1V8), C113 (U12 VCCA +1V8) and C114 (U12 VCCB WL_3V3)
    now sit 1.1-1.5 mm from their pins (were 9.7-28.8 mm). C111 (U11 VCCA
    WL_3V3) has no spot near pin 1 without signal-via rips, so it sits
    3.9 mm away on its own WL_3V3 plane via (was 30.6 mm). U12.22 (OE, GND)
    is joined to C114's GND pad, since C114 starves its thermal; C112's GND
    pad takes no zone connection. The old +1V8 spur to C113/C112 and the
    WL_3V3 stubs and plane vias of C111/C114 are removed; old GND vias stay.
    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
    [Nosh.kicad_pcb]
2026-11-01 U9/U10 decoupling: SDRAM caps moved to their VDD/VDDQ pins
    Each 100 nF now sits at its own supply pin (schematic note "0.1uF at
    every VDD/VDDQ pin"), 1.2-2.3 mm from the pin instead of 7-41 mm away
    in the west cluster. C92/C100 4.7 uF move beside each chip's pin 27.
    U10's north edge is fenced by the F.Cu SEMC_D20/D21/DM1 runs: C93 is
    a B.Cu via-in-pad cap on pin 1's own plane via (footprint field in
    sdram.kicad_sch changed to C_0402_1005Metric_ViP), C97/C99 sit on
    their own plane vias. U10.49 is boxed in by SW4 and the SEMC_D28/D29
    vias, so C94 stays where it was (4.2 mm).
    Old cap stubs and plane vias removed; old GND vias kept as stitching.
    U9/U10 reference text moved to x 35 clear of the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
    [Nosh.kicad_pcb, sdram.kicad_sch]
2026-11-01 U3 TPS2553: C64 4.7 uF moved to the OUT pin
    C64 moves from the USB2 connector to U3's OUT pin (pin 6), about
    1.3 mm from the pin on the USB2_VBUS run north of the chip, with its
    own GND via. The datasheet recommends bypassing OUT when the load
    draws large transients; C65 stays at the connector as VBUS bulk.
    At the connector C64.1 sat in series on the FB7 -> C65 -> U3 feed, so
    the 0.5 mm gap its pad bridged now has a 0.2 mm track. Its GND stub is
    removed and its GND via stays as stitching.
    DRC 0 violations, 0 unconnected, schematic parity 0.
    [Nosh.kicad_pcb]
2026-11-01 RTC load caps fitted, POR_B reset supervisor added
    C143/C144 on the RTC crystal are fitted at 10 pF C0G (C32949, were
    18 pF DNP). Y2 (Epson FC-135) wants CL 7 pF; with the RT1176 pin
    capacitance (DS Table 29, 1.5-2 pF) and ~3 pF of routing per side
    this gives CL ~7.5 pF. Left DNP it was ~2.5 pF, about +150 ppm. The
    schematic note gives the trim rule for first boards (~26 ppm per pF).
    POR_B gets U16 TLV803SDBZR (C132016): open-drain, holds reset until
    +3V3 (DCDC_IN) is above 2.93 V, then 200 ms. NXP DS Table 4 asks for
    a reset IC threshold above the 2.6 V DCDC_IN low-detect. U16 and its
    100 nF C146 sit on F.Cu west of SW1, on the existing POR_B run.
    R9 (100k POR_B pull-up to +1V8) is remove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
    [Nosh.kicad_pcb, lcsc_parts.csv, power.kicad_sch]
2026-11-01 claude: route BT_UART_CTS (B6), BT_CFG10 (C7), BT_CFG11 (C9), LPSPI3_SOUT = BT_CFG0 (D10, R92)
    [Nosh.kicad_pcb]
2026-11-02 nic: done BT_UART_CTS (B6), BT_CFG10 (C7), BT_CFG11 (C9), LPSPI3_SOUT = BT_CFG0 (D10, R92)
    [Nosh.kicad_pcb]
2026-11-02 MIPI DSI pairs re-tuned after hand routing; pour rule limited to outer layers
    pairtune.py re-run on the hand-routed board: all six MIPI_DSI tracks
    38.52 mm (intra-pair and pair-to-pair 0.00), bumps on B.Cu only.
    "Nosh: Pour to USB / MIPI pairs" gets (layer outer) so MIPI/USB vias no
    longer punch holes in GND1/PWR/GND2. DRC 0/0/0, parity 0.
    [Nosh.kicad_pcb]
2026-11-02 U8: AMS1117-1.8 replaced by TI TLV1117LV18DCYR (ceramic-stable)
    Review item: the AMS1117 wants a 22 uF tantalum on its output and
    10 mA minimum load. The TLV1117LV is stable with 0 ohm ESR ceramics,
    has no minimum load, same SOT-223 pinout (1 GND, 2 OUT+tab, 3 IN), so
    footprint and caps are unchanged. LCSC C80105 (Extended; no Basic
    1.8 V SOT-223 LDO exists). New project symbol Nosh:TLV1117LV-18.
    ERC unchanged, DRC/parity 0/0/0.
    [Nosh.kicad_pcb, lcsc_parts.csv, power.kicad_sch, supply.kicad_sch]
2026-11-02 U1 D12 +3V3: notch the VDD_SOC_IN plane so the +3V3 plane reaches its via
    The D12 fan-out via (74.8, 37.6) sat inside the VDD_SOC_IN PWR zone and
    was fed only through the via knock-out filament past the GND via at
    (74.8, 36.8). The zone outline now steps around x 73.7-76.0,
    y 36.5-38.1; +3V3 fills that pocket solidly (0.74 mm straps, 2.3 mm
    band at the via). SOC plane loses 1.35 mm^2 of lattice slivers.
    DRC 0/0/0, parity 0.
    [Nosh.kicad_pcb]
2026-11-02 DC jack OVP: SMAJ6.0A TVS + TPS259531 eFuse after the reverse diode
    Review item: no over-voltage protection on J4. D12 SMAJ6.0A clamps
    transients on DC_IN_F; U17 TPS259531 (5.7 V output clamp, auto-retry)
    sits between D2 and +5V on the new net DC_IN_P, so a wrong adapter
    leaves +5V under the MP2143's 6 V abs max. R105/R106 set UVLO 3.75 V,
    R107 560R sets ILIM 3.6 A, C147 3.3 nF dVdt, C148 IN bypass, FLT open.
    U17 and passives on B.Cu under D2 fed by D2.1's existing via; OUT
    vias in the +5V plane finger north of D2; D12 on F.Cu by F1.
    New symbol Nosh:TPS259531, PWR_FLAG on DC_IN_P. ERC baseline,
    DRC/parity 0/0/0.
    [Nosh.kicad_pcb, lcsc_parts.csv, supply.kicad_sch]
2026-11-02 C36 (NVCC_SD2) as a via-in-pad cap on U1 ball G13
    C36 2.2 uF moves from 17.9 mm away to a B.Cu ViP on the G13 fan-out via
    (75.667, 39.989) with its GND pad on the lattice via (75.6, 39.2).
    VDD_USB_1P8 B.Cu run beside it narrows to 0.13 mm at x 75.2; the old
    stub by FB6/R14 is ripped back to the via (89.0, 45.7). gpio.kicad_sch
    C36 -> Nosh:C_0402_1005Metric_ViP. C49 (VDD_MIPI_1P8, F9) stays: no
    legal GND via next to the F9 via. DRC 0/0/0, parity 0.
    [Nosh.kicad_pcb, gpio.kicad_sch]
2026-11-02 README: FlexSPI read strobe on GPIO_EMC_B2_18, not the SD_CMD pad
    Review item: SD_CMD shares GPIO_SD_B2_05 with FLEXSPI1_A_DQS, capping
    XIP reads at 60 MHz. USDHC2_CMD has no other location, but the DQS
    pad does: ball N3 (GPIO_EMC_B2_18) is unconnected on Nosh and is the
    alternate FLEXSPI1_A_DQS pad. Firmware-only fix: FCB stays on the
    internal loopback for ROM boot, the application re-inits FlexSPI with
    the DQS muxed to EMC_B2_18 at 133 MHz. No board change; N3 stays open.
2026-11-02 USB2 D+/D- length-matched on both sides of L3
    Review suggestion: USB2 pair 3.0 mm apart on the J2 side. Bumps on the
    shorter net only: USB2_DN 61.03 -> 64.06 mm (= USB2_DP) on its B.Cu
    run; USB2_CON_DN 12.88 -> 15.92 mm (CON_DP 15.90) with one B.Cu and
    two In2 bumps. Via count asymmetry and the uncoupled routing of the
    J2 pocket left as they are (see docs notes). DRC 0/0/0, parity 0.
    [Nosh.kicad_pcb]
2026-11-02 README in step with the board; SD DAT1/DAT2 pull-ups; U15 thermal vias
    Review suggestions: README no longer claims the layout has not started
    and no longer lists J10 or the 72 test points (removed in a9f1b1f);
    R108/R109 10k pull-ups on SD_DAT1/SD_DAT2 to NVCC_SD2 beside R53;
    U15 exposed pad gets three GND vias on the strip between the +1V8 and
    POR_B tracks under it (was one off-centre via). DRC 0/0/0, parity 0.
    [Nosh.kicad_pcb, lcsc_parts.csv, sdcard.kicad_sch]
2026-11-02 Seven bring-up test points: GND x2, +5V, +3V3, +1V8, DCDC_DIG, POR_B
    Review suggestion. TP1/TP2 2 mm plated GND holes; TP3/TP4 1 mm pads on
    vias into the +5V / +3V3 planes; TP5 +1V8 by U8; TP6 DCDC_DIG on the
    bottom beside C31; TP7 POR_B by U16. Nosh.pretty gets the KiCad
    TestPoint footprints without their silk ring (0.14 mm from the pad,
    under the JLCPCB 0.15 mm rule); not in BOM or position files. Symbols
    on the Supply and Power sheets. DRC 0/0/0, parity 0.
    [Nosh.kicad_pcb, power.kicad_sch, supply.kicad_sch]
2026-11-02 nic: cleanup
    [Nosh.kicad_pcb]
2026-11-02 J8/J9: SJ-3523-SMT-TR (out of stock) -> SJ-3524-SMT-TR C20182907
    Same Sky (CUI) SJ-3524 is the same sj-352x drawing with one extra tip-switch
    pad TN, left unconnected. New project footprint and a TRS_SW symbol with
    no-connect flags on TN; LCSC/MPN/datasheet fields, parts CSV and README
    updated.
    The TN pads land where C141, LINEIN_L and the USB1_VBUS via were: C141 moved
    1.15 mm north, LINEIN_L re-run along y 61.1 and down x 131.95 into J9.T,
    USB1_VBUS via moved from (130.55, 62.6) to (132.5, 62.6).
    DRC 0 / unconnected 0 / parity 0 (severity-all, refilled); ERC baseline;
    no new copper below 0.1 mm clearance.
    [Nosh.kicad_pcb, audio.kicad_sch, lcsc_parts.csv]
2026-11-02 ESD diodes on the microSD lines and the audio jacks
    D13-D18 TPD1E05U06DPYR (C436349, 5.5 V, 0.42 pF) on SD_CLK_C, SD_CMD and
    SD_DAT0-3; D19-D22 TPD1E10B06DPYR (C48260, +-5.5 V bidirectional) on the
    jack side of LINEOUT_L/R and LINEIN_L/R. Single X1SON-2 diodes placed on the
    traces next to the connectors with a GND via each; C132 moved 1.15 mm west
    to make room for D19. New footprint Nosh:ESD_X1SON-2_0.6x1mm_JLC (no silk
    dot), symbols Nosh:TPD1E05U06 / TPD1E10B06, parts CSV and README rows.
    DRC 0 / unconnected 0 / parity 0 (severity-all, refilled); ERC baseline.
    [Nosh.kicad_pcb, audio.kicad_sch, lcsc_parts.csv, sdcard.kicad_sch]
2026-11-02 Merge the SDRAM_3V3 island into the +3V3 plane
    The SEMC address/command bus runs on In2 (SIG) and referenced the PWR plane, where every line crossed the edge between the SDRAM_3V3 island and the main +3V3 fill (17 crossings). Rather than change the stackup, drop the EVKB-style bead and make the SDRAM supply part of the +3V3 plane:
    - Board: FB9, its two F.Cu stubs and the two vias either side removed; 51 tracks/vias and 32 pads (U9, U10, C85-C102) re-netted SDRAM_3V3 -> +3V3; zone PWR_SDRAM_3V3 deleted so the board-wide +3V3 zone fills the area. SEMC island crossings on In2 17 -> 0; SEMC length over plane voids 87.4 -> 83.6 mm.
    - sdram sheet: FB9 and its labels removed, 33 SDRAM_3V3 labels -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
    [Nosh.kicad_pcb, lcsc_parts.csv, sdram.kicad_sch]
2026-11-03 J2 host VBUS: D2 SS54 Schottky -> Q4 IRLML6401 P-FET, FB7 -> low-DCR bead
    The jack-to-J2 chain (F1, D2, U17 eFuse, U3 TPS2553, FB7) put only ~4.25 V on
    the host port at 1 A. The EVKB uses back-to-back P-FETs instead of a Schottky
    and sits near 4.8 V, so follow it:
    - D2 SS54 removed; Q4 IRLML6401 (SOT-23, same part as Q3) as a reverse-polarity
    switch: drain on DC_IN_F (jack side), source on DC_IN_P, gate to GND.
    ~50 mOhm instead of a ~0.4 V diode drop. Board: Q4 at D2 old spot (19.75,48.0),
    source on the existing DC_IN_P via, gate by F.Cu track to the GND via at U17,
    drain on the 1.0 mm DC_IN_F feed from F1.
    - FB7 742792641 (0.15 R DCR) -> BLM18PG121SN1D 120R (same part as FB10).
    - E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
    [Nosh.kicad_pcb, lcsc_parts.csv, supply.kicad_sch, usb.kicad_sch]
2026-11-03 JLCPCB fabrication outputs: fab_export.py, fab/ (Gerbers, BOM, CPL), README
    Kicad/tools/fab_export.py writes fab/: Nosh-gerbers.zip (6 copper + paste, silk,
    mask, edge cuts, Protel extensions, no X2, mask subtracted from silk; one Excellon
    drill file with Gerber X2 map), Nosh-bom.csv (Comment, Designator, Footprint,
    LCSC Part #, MPN; 70 order codes, 268 fitted parts) and Nosh-cpl.csv (Designator,
    Mid X, Mid Y, Layer, Rotation; DNP excluded, 198 top / 70 bottom) plus a README
    with the order settings. --no-tht drops J4 and J11 for hand soldering. LCSC
    numbers come from data/lcsc_parts.csv, regenerated here (row order only).
    README: review-fixes merged to main, testpoints sheet gone, part coun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
    [Nosh-B_Cu.gbl, Nosh-B_Mask.gbs, Nosh-B_Paste.gbp, Nosh-B_Silkscreen.gbo, Nosh-Edge_Cuts.gm1, Nosh-F_Cu.gtl, Nosh-F_Mask.gts, Nosh-F_Paste.gtp]
2026-11-03 SDRAM U9/U10: AS4C32M16SB-6TIN -> AS4C32M16SC-7TIN (SEMC 132 MHz); JLCPCB order settings in the fab README
    The -6TIN pre-order (C1351095) never came into stock; four AS4C32M16SC-7TIN
    (C1349997) were ordered instead. Same JEDEC TSOP-54 pinout and 13x10 addressing,
    but a 133 MHz part (tCK 7.5 ns at CL3), so the SEMC clock drops from the EVKB
    198 MHz to 132 MHz = SYS_PLL2 528 / 4, which is the clock root reset default.
    - U9/U10 Value, MPN, LCSC, Datasheet, Description on the sdram sheet and the
    board; project symbol description/datasheet; three sheet notes.
    - README: part in the overview, EVKB table and parts-to-check table (Winbond
    256 Mb fallbacks with stock, W989D6DBGX6I LPSDR noted as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
    [Nosh-B_Cu.gbl, Nosh-B_Mask.gbs, Nosh-B_Paste.gbp, Nosh-B_Silkscreen.gbo, Nosh-Edge_Cuts.gm1, Nosh-F_Cu.gtl, Nosh-F_Mask.gts, Nosh-F_Paste.gtp]
2026-11-03 JLCPCB order Y95-2611336A placed 2026-11-03: record it in the READMEs; fab README consigned-parts line -> SC-7TIN
    fab_export.py and fab/README.md: the consigned / pre-ordered line still named the
    out-of-stock AS4C32M16SB-6TIN; now AS4C32M16SC-7TIN (C1349997). New "Order placed"
    section with the order number, price, settings and the hand-depanel note (J5 is
    0.3 mm from the north V-score). README status line carries the order.
2026-11-03 docs: EVKB vs Nosh firmware porting reference
    Per-pad comparison of the MIMXRT1170-EVKB RevC3 and Nosh (230 signal balls, generated
    from both netlists) plus the board facts the teensy-cores/imxrt1176, USBHost_t36, SPI,
    M2Radio and MipiDisplay ports depend on: SEMC 128 MB at 132 MHz, microSD on uSDHC2,
    M.2 SDIO alone on uSDHC1 at 1.8 V, no SPI bus, USB/display unchanged, per-repo checklist.
2026-11-03 Add PCB images to README
    Added images of the PCB top and bottom sides to the README.
